foxsi/UMN-boards-FOXSI-4/README.md

# UMN-boards-FOXSI-4
Circuit boards designed in Minnesota for FOXSI-4
