foxsi/UMN-boards-FOXSI-4/little_switch/v2/doc/zdiff_jlc_vs_sierra.pdf

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
5 | 6 | 7 | 8

Trace Space

Trace Width

Trace width/space to achieve 100 Ω differential impedance for different manufacturers

Sierra-FR370HR | JLC7628 | JLC3313
