foxsi/UMN-boards-FOXSI-4/plenum/v2/doc/img/board.png

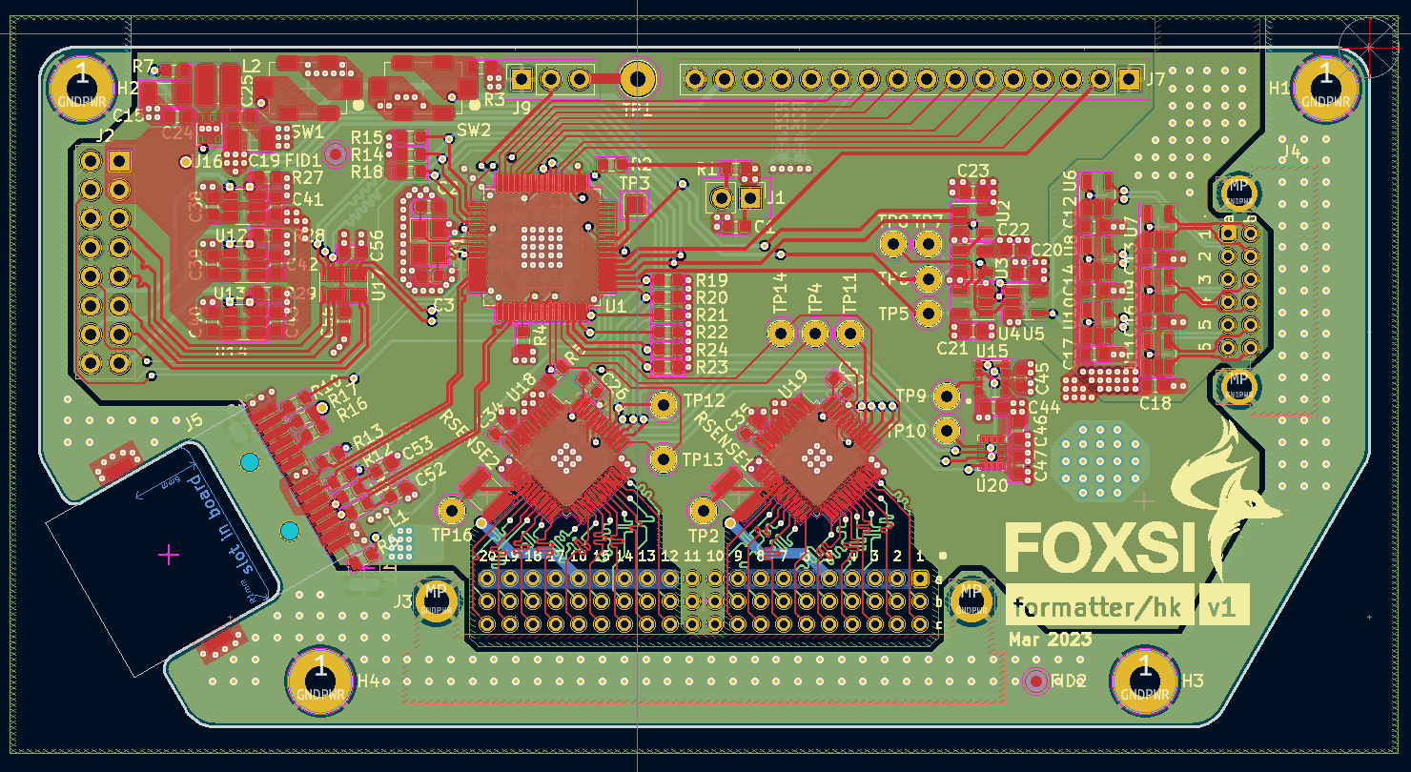
plenum/v2/doc/img/board.png
