foxsi/UMN-boards-FOXSI-4/plenum/v2/outline_w_cutout.dxf

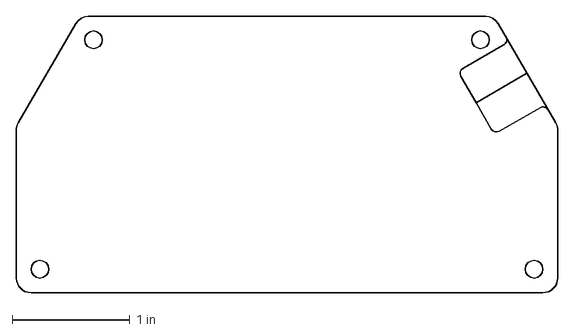
[picture p8: CAD file, 2023-04-05]
plenum/v2/outline_w_cutout.dxf
4.60 x 2.35 in
