foxsi/UMN-boards-FOXSI-4/rj45_jack/rj45_jack.stp

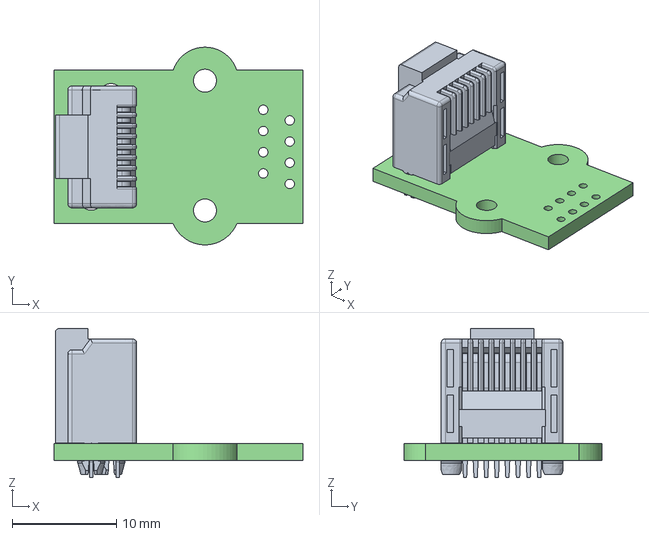
[picture p9: CAD file, 2023-04-05]
rj45_jack/rj45_jack.stp
23.9 x 19.0 x 14.3 mm
rj45_jack PCB
