foxsi/UMN-boards-FOXSI-4/plenum/v2/board_outline.dxf

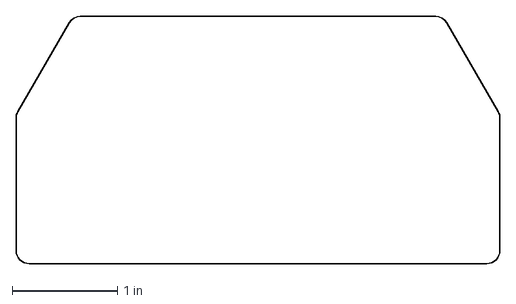
[picture p10: CAD file, 2022-10-31]
plenum/v2/board_outline.dxf
4.60 x 2.35 in
