foxsi/UMN-boards-FOXSI-4/(threads)

Thread 1 (2023-03-22):

Add RS-232 input to Ethernet switch board

thanasipantazides, 2023-03-22:
### Need:

To uplink commands from TM section (over RS-232 TX line) to Raspberry Pi.

### Todo:

- [x] Find an RS-232 <=> UART translator (with some memory, no fancy interrupting/flow control stuff)
- [x] Identify appropriate Raspberry Pi UART to route command uplink into.
- [x] Add that chip to the Ethernet switch, bottom side.

Closed 2023-07-11.

Thread 2 (2023-04-09):

Flight board solder concerns

thanasipantazides, 2023-04-09:
### Surface finishes

Summit requested to use ENIG surface finish on EM Housekeeping board due to small pad size (rather than HASL). Compared to HASL, ENIG has better pad flatness, corrosion and oxidation resistance under long-duration storage, but worse solderability and a propensity to form brittle solder joints. Specifically, some of the Ni used in the ENIG finish tends to flow into SnPb solders during reflow, which changes the solder chemistry and can result in a brittle joint if enough Ni is introduced (see  [Goyal et al. 2002](https://ieeexplore.ieee.org/document/1008179)). For SnAuCu (SAC) solders (lead-free), the Au content of the solder tends to create more brittle joints than leaded solders (see [Su, Jian, and Hamasha 2019](https://ieeexplore.ieee.org/document/8846735)).

So there doesn't seem to be a clear best solution.

### To do before flight

- [ ] Figure out any possible pre-soldering surface treatments for ENIG
- [ ] Store flight ENIG boards airtight, handle with gloves (avoid oil contamination of pads)
- [ ] Find a good solder to use ([on SAC candidate](https://www.digikey.com/en/products/detail/chip-quik-inc/SMD291SNL250T3/3645039))

Thread 3 (2024-10-10):

Power board v3

thanasipantazides, 2024-10-10:
## Overview
This issue will track changes to the `v3` power board design to address FOXSI-4 hardware errata, [documented here](https://github.com/foxsi/UMN-boards-FOXSI-4/releases/tag/foxsi-4-flight).

## Fixes to make

- [ ] Connect LT8612 `BST` to `SW` via 0.1 µF capacitor.
- [ ] Connect LT8612 `SYNC` to `INTVCC`.
- [ ] Route `SPI.SDO` to `J1.7` and `SPI.SDI` to `J1.9` (swapping them).
- [ ] Change `R58` value to 3 kΩ.
- [ ] `Timepix_5V_out` and `Timepix_12V_out` naming or placement in header should be swapped. They carry one another's voltage. (Error was introduced by module-level wiring in the hierarchical schematic).
- [ ] The MAX7317 `SPI.SDO` line needs external circuitry to be hi-Z when inactive (when `nCS3` is high).
- [ ] Something needs to be done to address the CMOS 2 always-on issue that emerged during sequence testing in Alaska. Consider new SRRs, input-side (`+28V_clean`) circuit protection, or output-side circuit protection.

thanasipantazides, 2024-10-10:
For the MAX7317 `SPI.SDO` fix, can use the TI [SN74AHC1G125](https://www.ti.com/lit/ds/symlink/sn74ahc1g125.pdf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) inline, switched by `SPI.nCS3`, to toggle.

thanasipantazides, 2024-10-10:
#### Oct 10 2024:
Implemented these locally:
- [x] Connect LT8612 BST to SW via 0.1 µF capacitor.
- [x] Connect LT8612 SYNC to INTVCC.
- [x] Route SPI.SDO to J1.7 and SPI.SDI to J1.9 (swapping them).
- [x] Change R58 value to 3 kΩ.
- [ ] Timepix_5V_out and Timepix_12V_out naming or placement in header should be swapped. They carry one another's voltage. (Error was introduced by module-level wiring in the hierarchical schematic).
- [x] The MAX7317 SPI.SDO line needs external circuitry to be hi-Z when inactive (when nCS3 is high).
- [ ] Something needs to be done to address the CMOS 2 always-on issue that emerged during sequence testing in Alaska. Consider new SRRs, input-side (+28V_clean) circuit protection, or output-side circuit protection.

thanasipantazides, 2024-10-10:
For voltage spike suppression, consider the [LittleFuse SMCJ36CA](https://www.digikey.com/en/products/detail/littelfuse-inc/SMCJ36CA/762405) which was used on the CMOS boards.

thanasipantazides, 2024-10-10:
Or the SMBJ36CA, which is slightly smaller.

thanasipantazides, 2024-10-22:
A proposed set of mitigations for the CMOS 2 issue. This avoids changes to the CdTe canister channels, for which we expect much less inrush and which performed well:
1. Add a TVS diode on the input for transient suppression. That's done above.
2. Maximize the R19/R20 resistance to maximize turn-on time. I think the largest we can do is ~1 kΩ; I will validate this in the lab.
3. Duplicate the CMOS channels' G3VM-61 chips. Run two chips in parallel per CMOS channel. This gives us much more current overhead, uses two of the same part that already flew, and minimizes board space consumption. Are there downsides to this plan?

thanasipantazides, 2024-10-23:
I corrected the `Timepix_5V_out` / `Timepix_12V_out` schematic-side. So there is no change to the FOXSI-4 power pinout, but the schematic is also now internally consistent with the voltage you actually get out of the pins.

thanasipantazides, 2024-11-01:
Phil made two suggestions in review:
1. Move topside copper out from under 12 V inductor. Lower layer or route around. This affects `REGS_Isense` and `Net-(JP9-C)`.
2. Get more consistent voltage across each duplicated CMOS SSR LED. This applies to `U19` + `U33`, and `U20` + `U32`. The idea is each LED will turn on at slightly different times, based on their steep transition in response to applied voltage. To mitigate, Phil suggests either wiring them serially, or giving each LED its own ballast resistor. Serial hookup is undesirable because of lack of redundancy, if the topside fails. Phil included a setup (for the low voltage/high current switches) with similar paired SSRs in his original v1 board, and succeeded with separate ballast resistors per LED.

So for (2) I will plan to implement dedicated ballast resistors for each LED.

thanasipantazides, 2024-11-13:
Another edit before purchase: add some exposed +28/return copper on bottom side just after input Gecko. In case we need more components for any reason.

thanasipantazides, 2024-11-15:
Re: Phil's suggestions: I've implemented this:
> So for (2) I will plan to implement dedicated resistors for each LED.
