foxsi/UMN-boards-FOXSI-4/power/v3/doc/ref_sch_20230531.pdf

# 2.2pF R5

INTVCC | 21 BST | 20 SW_5 | 19 SW_4 | 18 SW_3 | 17 SW_2 | 16 SW_1 | 15 GND_5 29 | NC_4 28 | NC_3 27 | NC_2 26 | NC_1 25 TP? R3

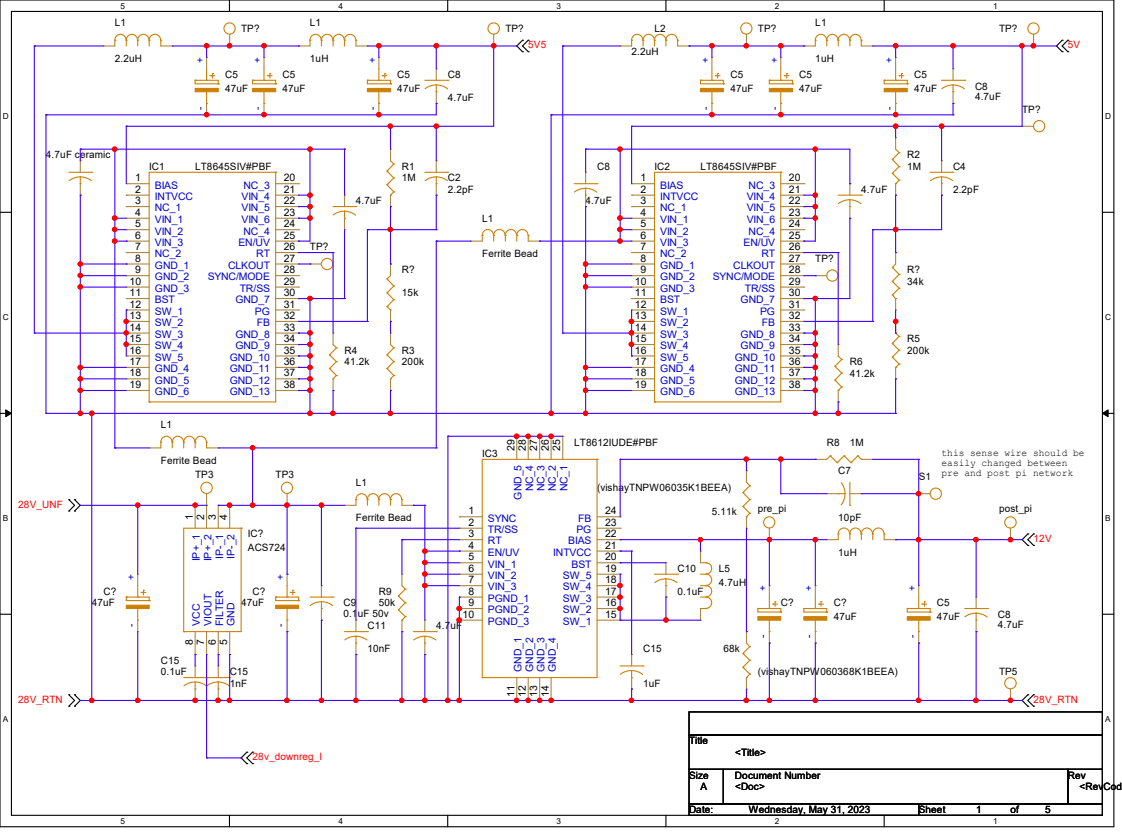
[picture p21: page 1]

this sense wire should be
easily changed between
pre and post pi network

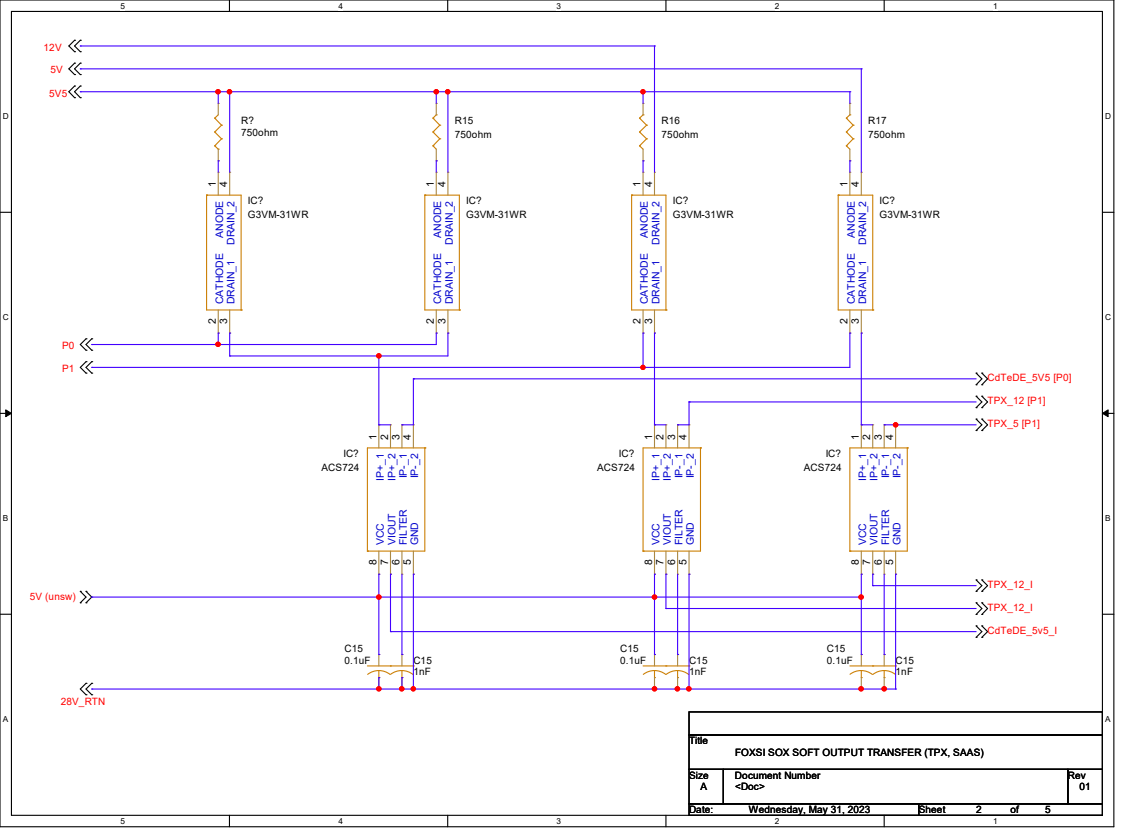
[picture p22: page 2]
A A 28V_RTN; CdTeDE_5V5 [P0]; TPX_12 [P1]; TPX_5 [P1]; CdTeDE_5v5_I; TPX_12_I; 5V (unsw); Title Size; Document Number; Rev Date:; Sheet; of <Doc>; 01 FOXSI SOX SOFT OUTPUT TRANSFER (TPX, SAAS) A; Wednesday, May 31, 2023; 5 Title Size; IC? ACS724; 4 VCC; 8 VIOUT; 7 FILTER; 6 GND; IC? G3VM-31WR ANODE; 1 CATHODE; 2 DRAIN_1; 3 DRAIN_2; R15 750ohm; R? 750ohm; R16 750ohm; 5 R17 750ohm

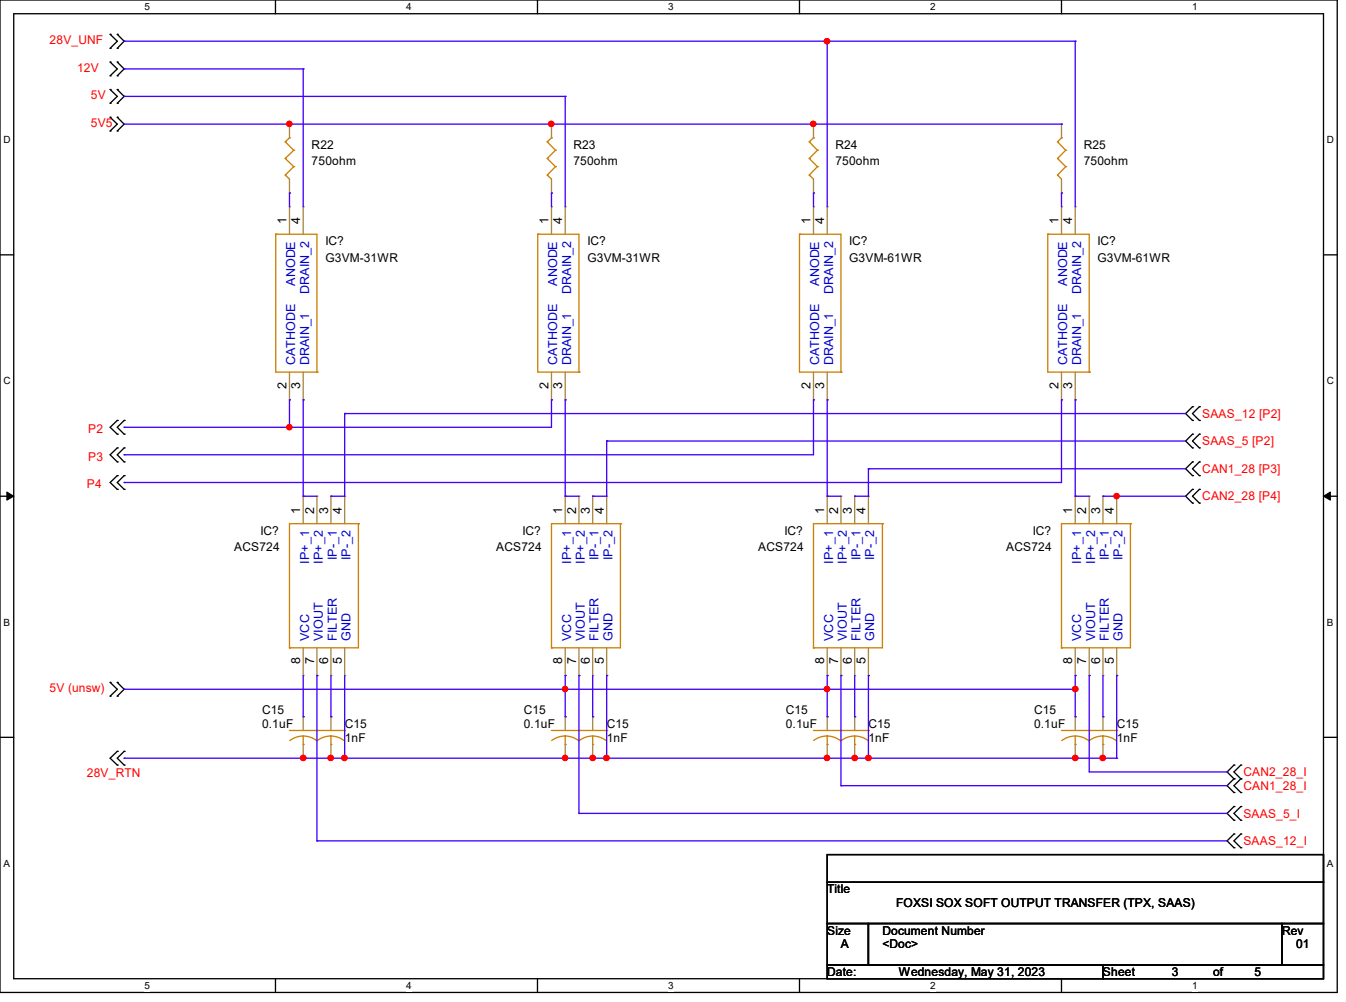
[picture p23: page 3]
A A 28V_RTN; 28V_UNF; SAAS_12 [P2]; SAAS_5 [P2]; CAN2_28 [P4]; CAN1_28 [P3]; CAN2_28_I CAN1_28_I; SAAS_5_I; SAAS_12_I; 5V (unsw); Title Size; Document Number; Rev Date:; Sheet; of <Doc>; 01 FOXSI SOX SOFT OUTPUT TRANSFER (TPX, SAAS) A; Wednesday, May 31, 2023; 5 Title Size; R23 750ohm; IC? G3VM-31WR ANODE; 1 CATHODE; 2 DRAIN_1; 3 DRAIN_2; 4 R22 750ohm; IC? ACS724; 4 VCC; 8 VIOUT; 7 FILTER; 6 GND; 5 R24 750ohm; IC? G3VM-61WR ANODE; R25 750ohm

5V5 P5

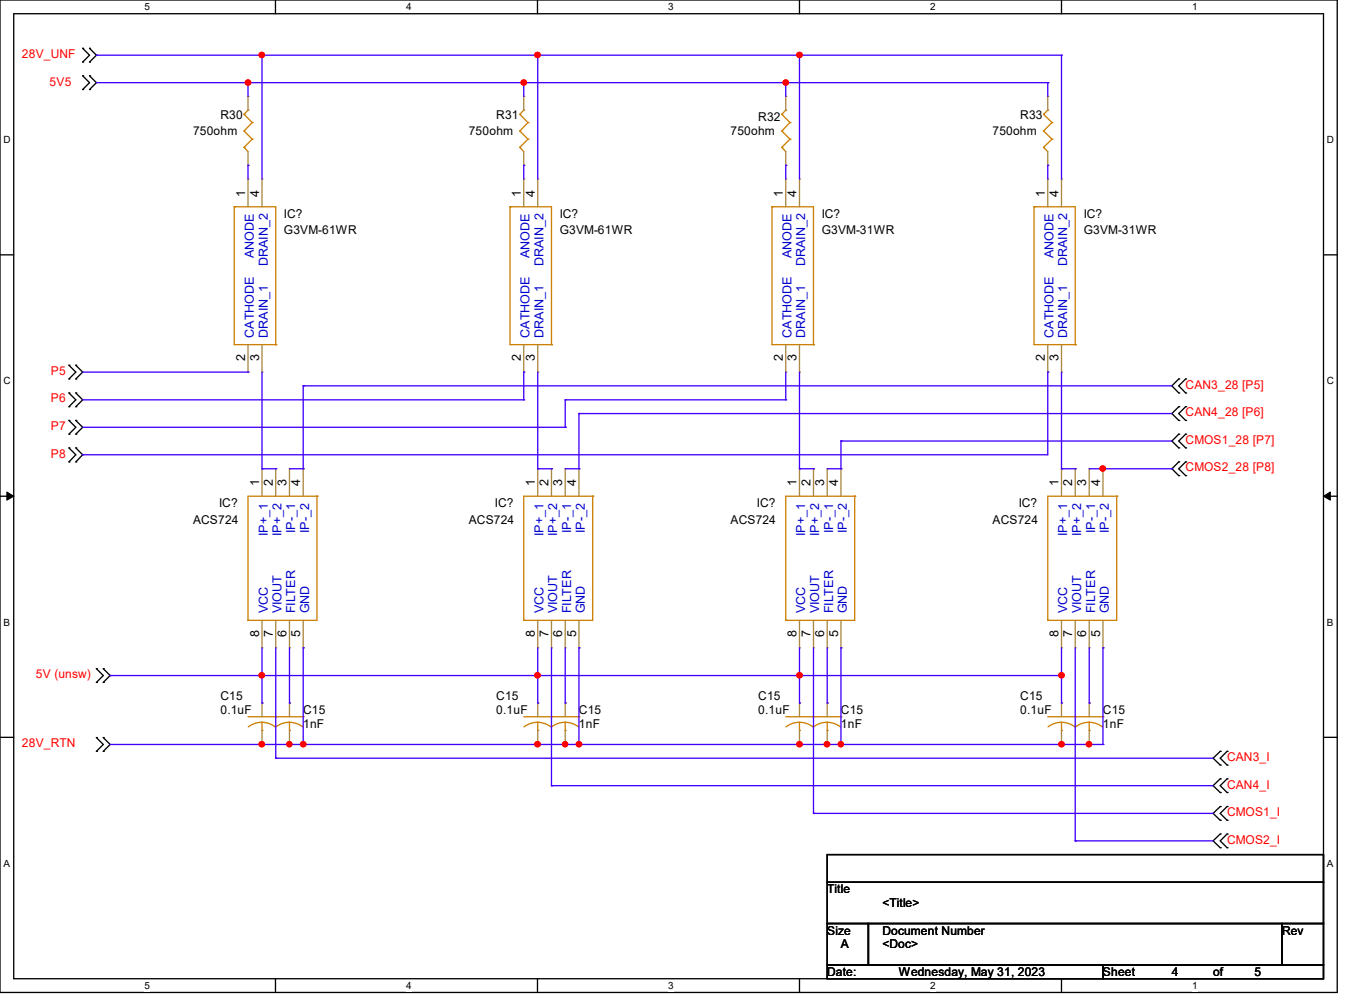
[picture p24: page 4]
A A 28V_RTN; CAN3_28 [P5]; CAN4_28 [P6]; CMOS1_28 [P7]; CMOS2_28 [P8]; 28V_UNF; CMOS2_I; CMOS1_I; CAN4_I; CAN3_I; 5V (unsw); Title Size; Document Number; Rev Date:; Sheet; of <Doc>; <Title> A; Wednesday, May 31, 2023; 5 Title Size; IC? G3VM-31WR ANODE; 1 CATHODE; 2 DRAIN_1; 3 DRAIN_2; R31 750ohm; IC? ACS724; 4 VCC; 8 VIOUT; 7 FILTER; 6 GND; R32 750ohm; IC? G3VM-61WR ANODE; R33 750ohm; R30 750ohm

# TP12 TP6

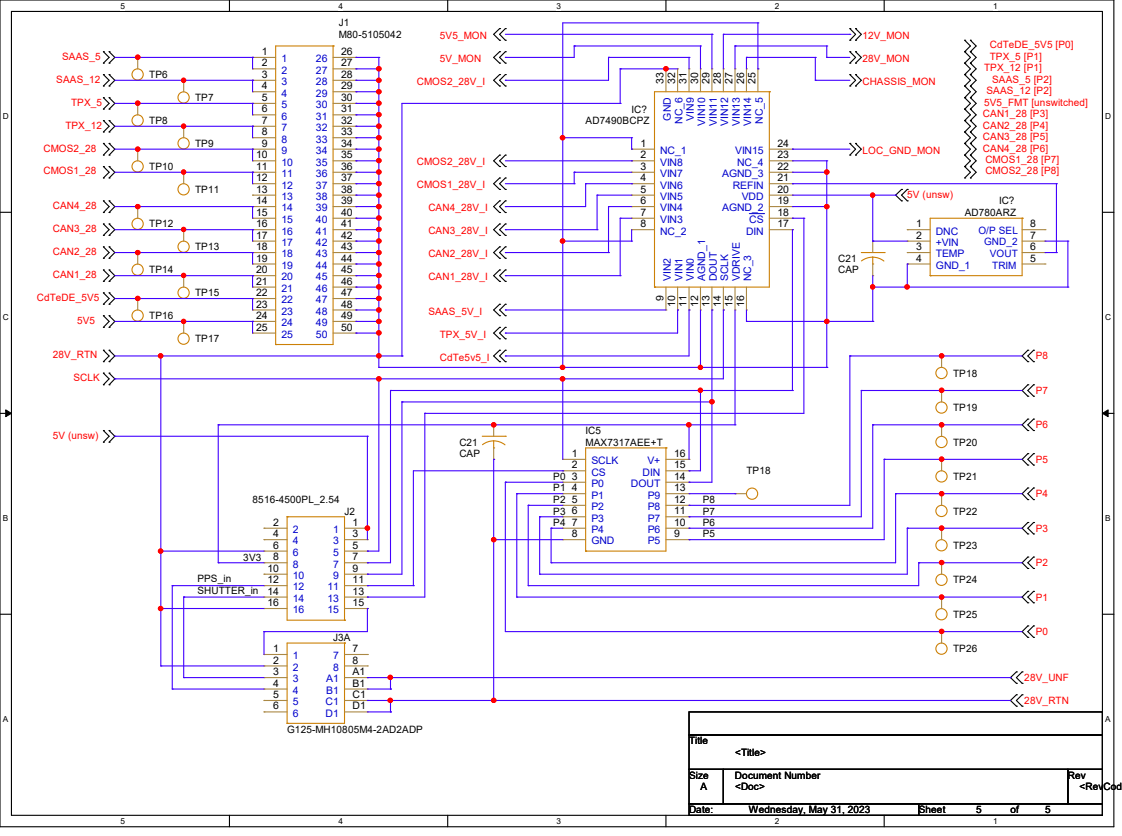
[picture p25: page 5]

9 VIN1 10 VIN0 11 AGND_1 12 DOUT 13 SCLK 14 VDRIVE 15 NC_3 16 VIN15 24 NC_4 23 AGND_3 22 REFIN 21 VDD 20 AGND_2 19 CS 18 DIN 17 GND 33 NC_6 32 VIN9 31 VIN10 30 VIN11 29 VIN12 28 VIN13 27 VIN14 26 NC_5 25
