foxsi/UMN-boards-FOXSI-4/little_switch/v2/doc/formatter stack drawing.pdf

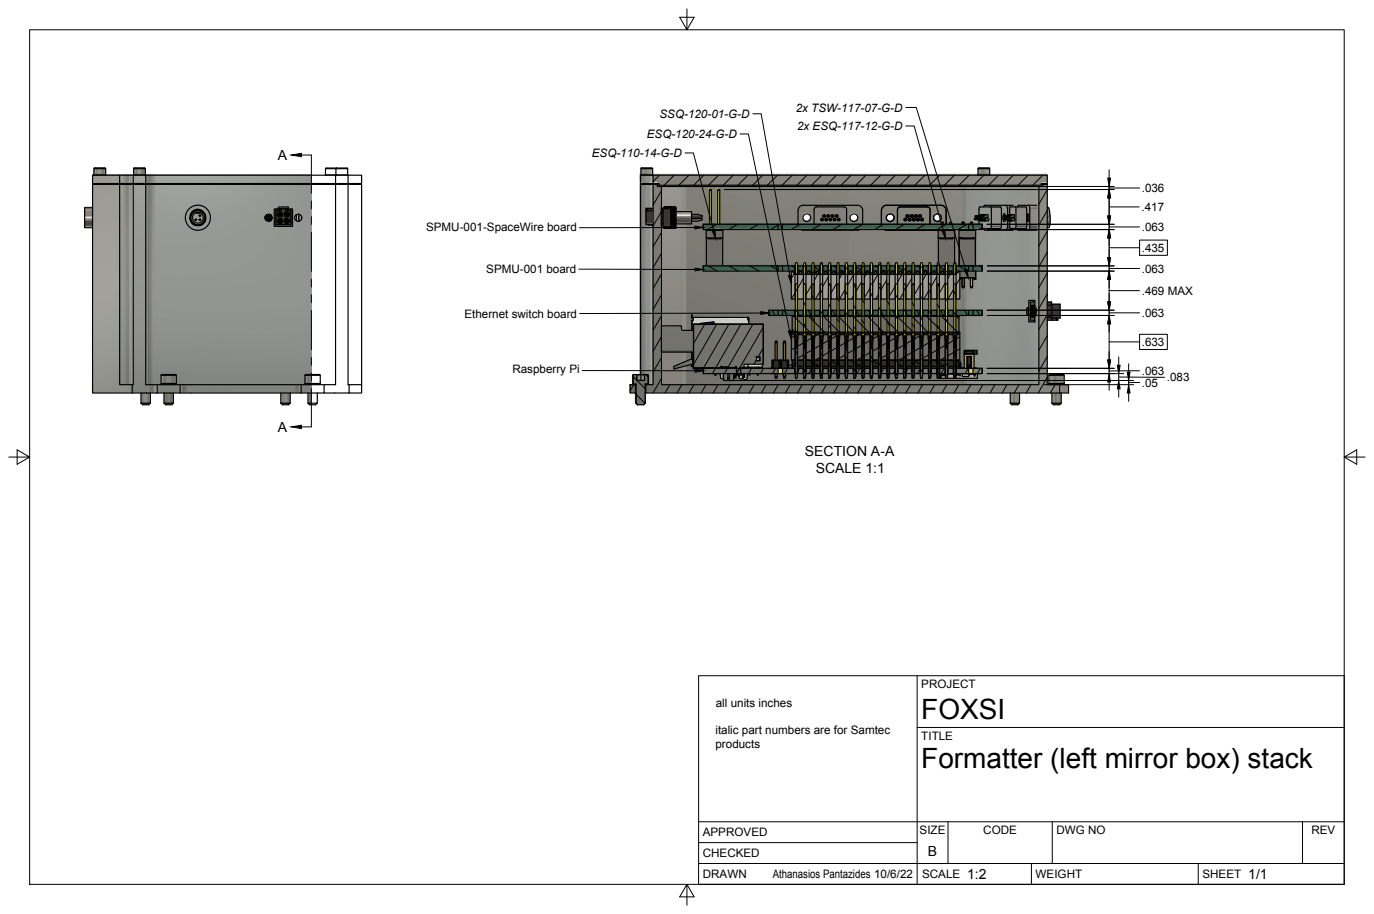
[picture p26: page 1]
SIZE; CODE; DWG NO; REV; Athanasios Pantazides 10/6/22; SECTION A-A SCALE 1:1; .469 MAX; SPMU-001 board; Raspberry Pi; 2x ESQ-117-12-G-D; 2x TSW-117-07-G-D SSQ-120-01-G-D

SPMU-001-SpaceWire board

Ethernet switch board

PROJECT
FOXSI
Formatter (left mirror box) stack

all units inches

italic part numbers are for Samtec
products
