foxsi/UMN-boards-FOXSI-4/power/v3/build/power.pdf

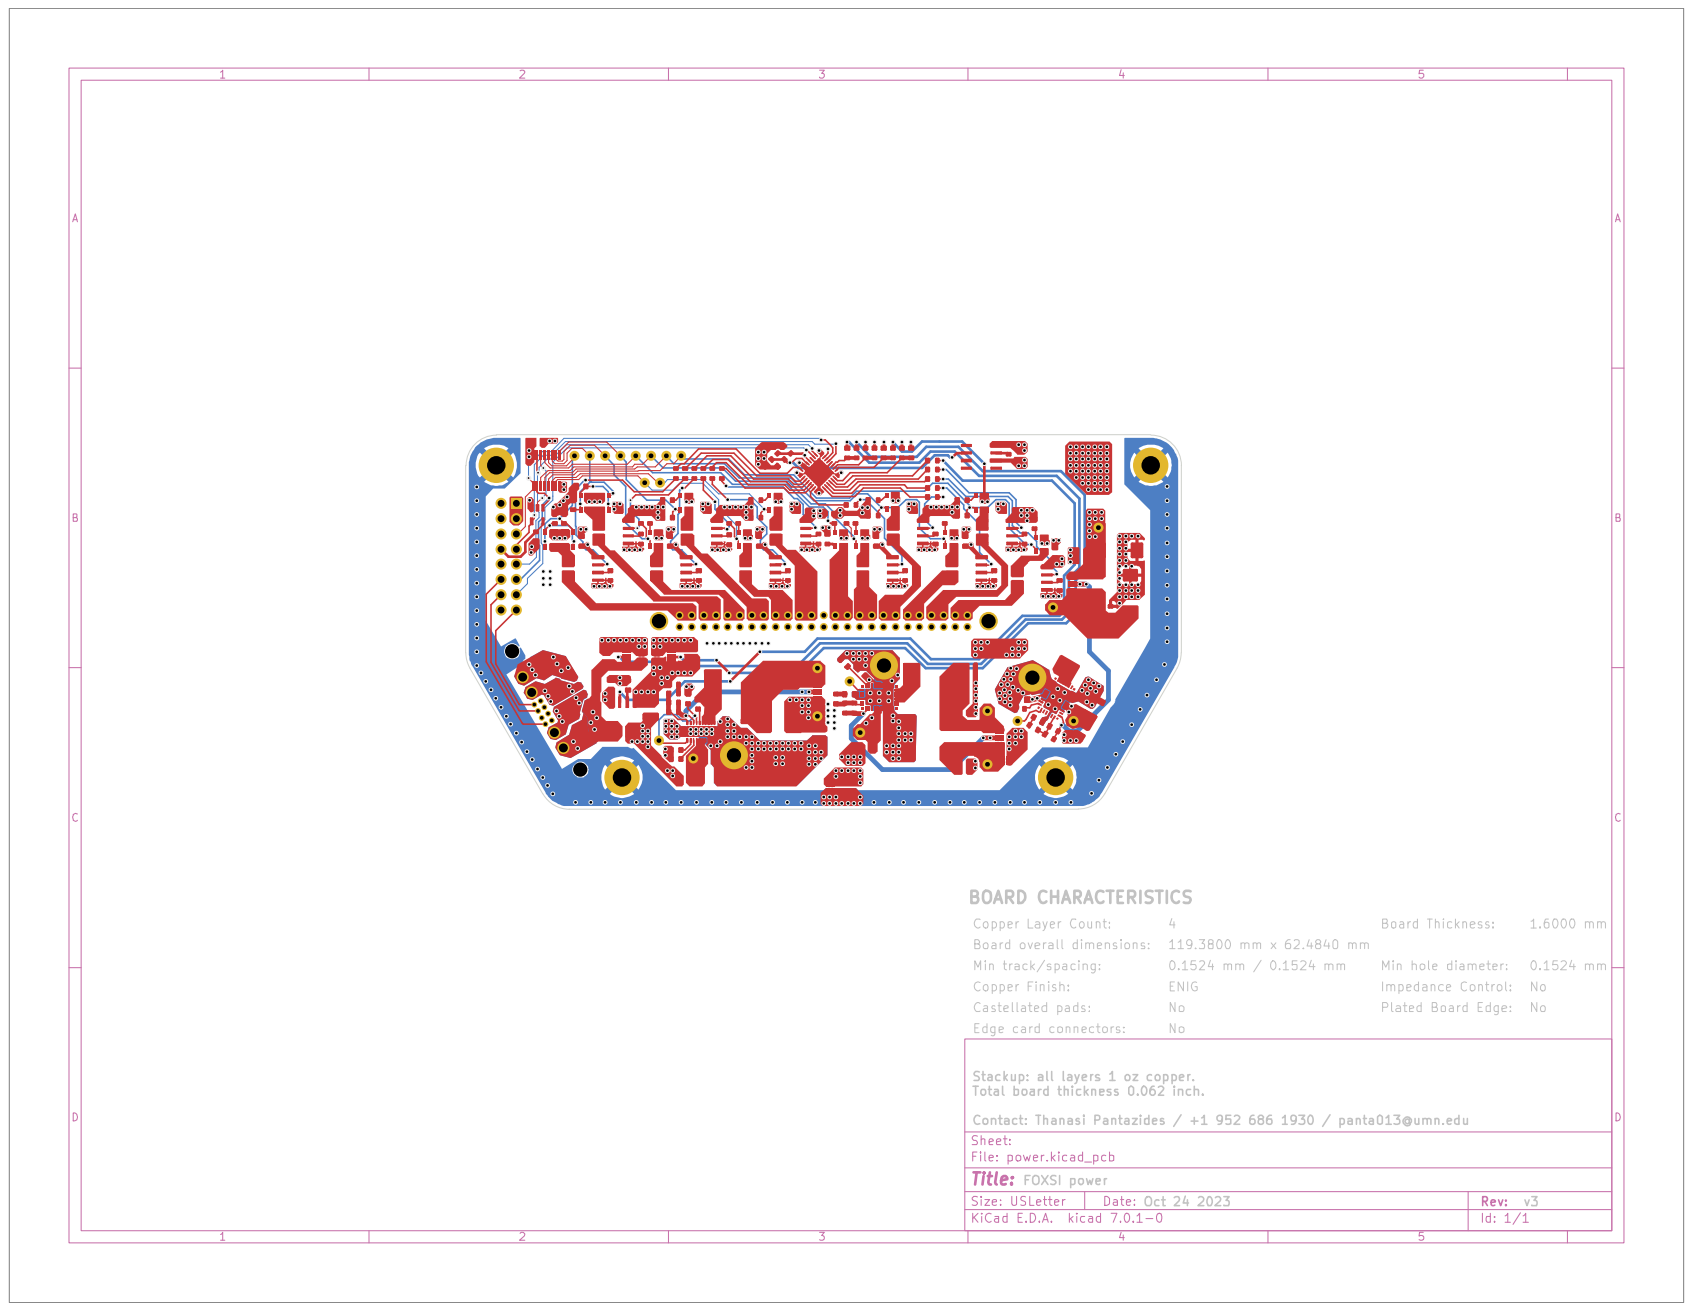
[picture p36: page 1]
