foxsi/UMN-boards-FOXSI-4/power/v3/doc/schematic.pdf

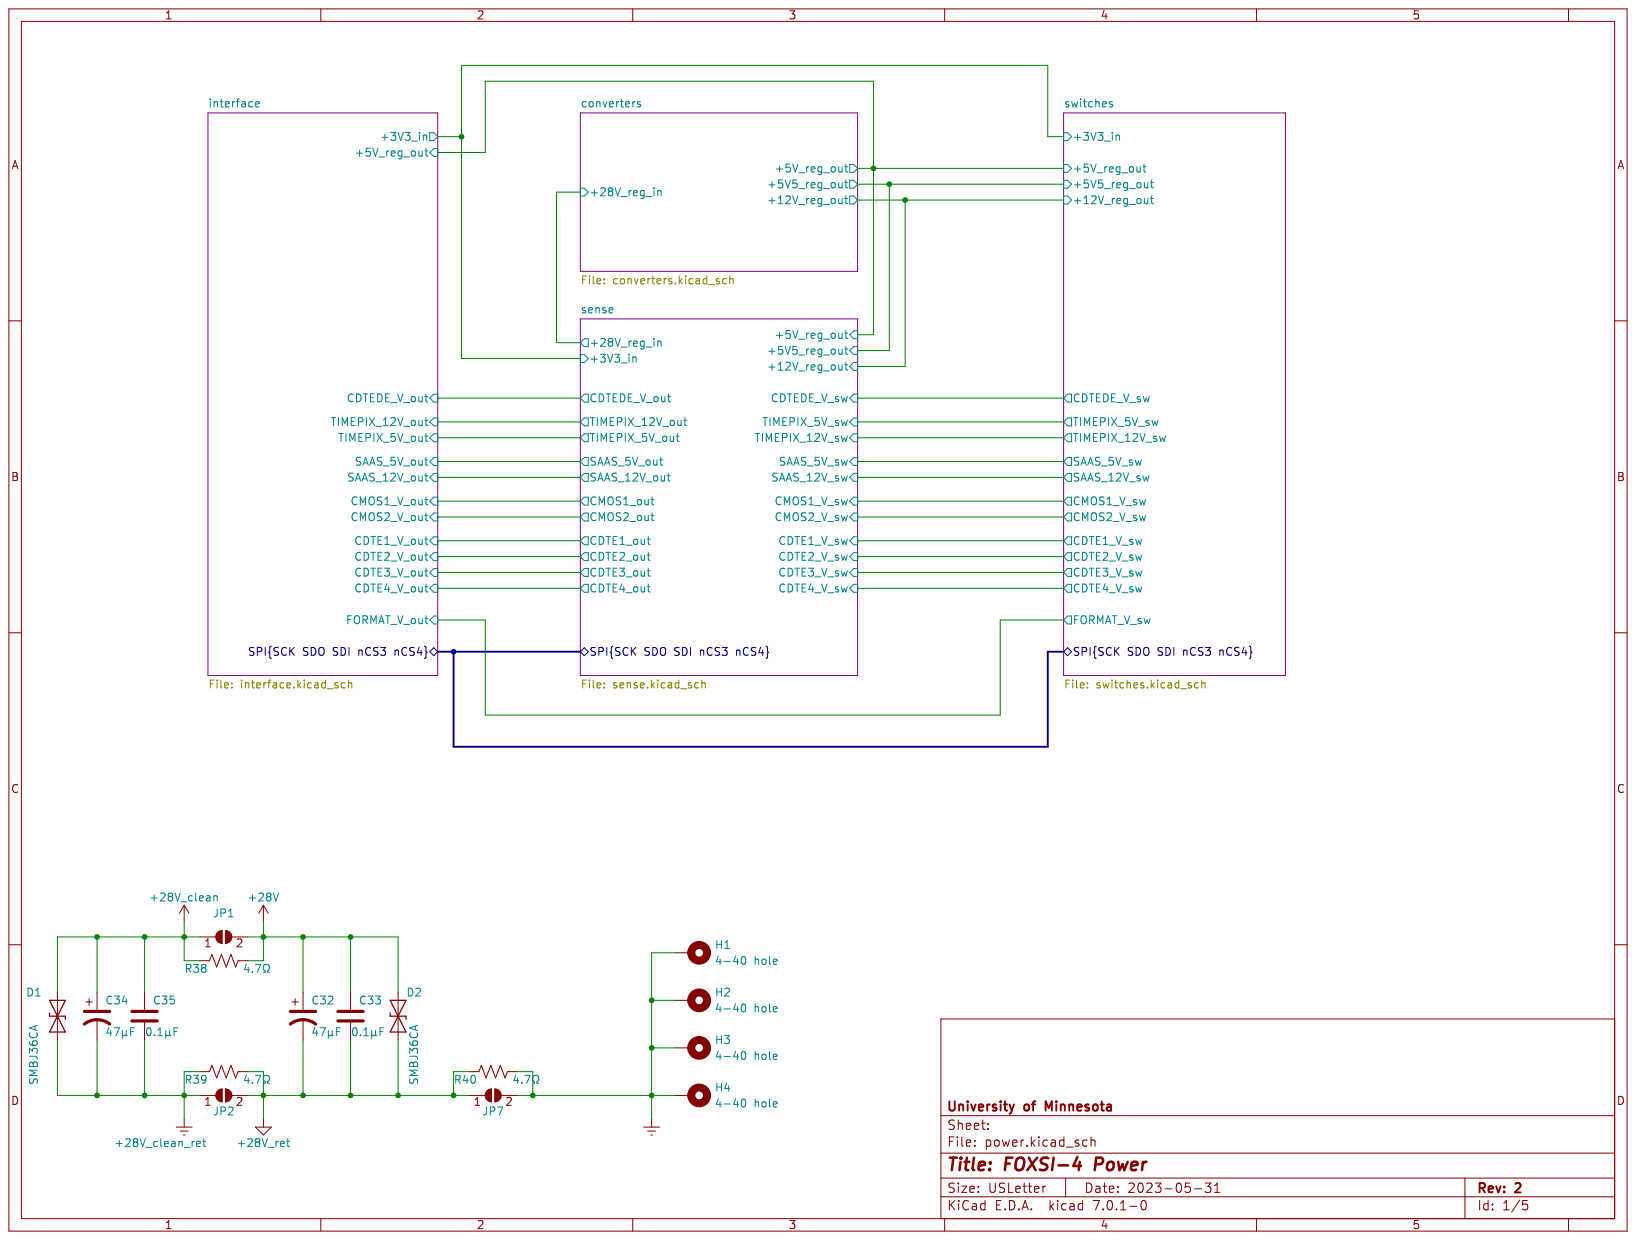
[picture p37: page 1]

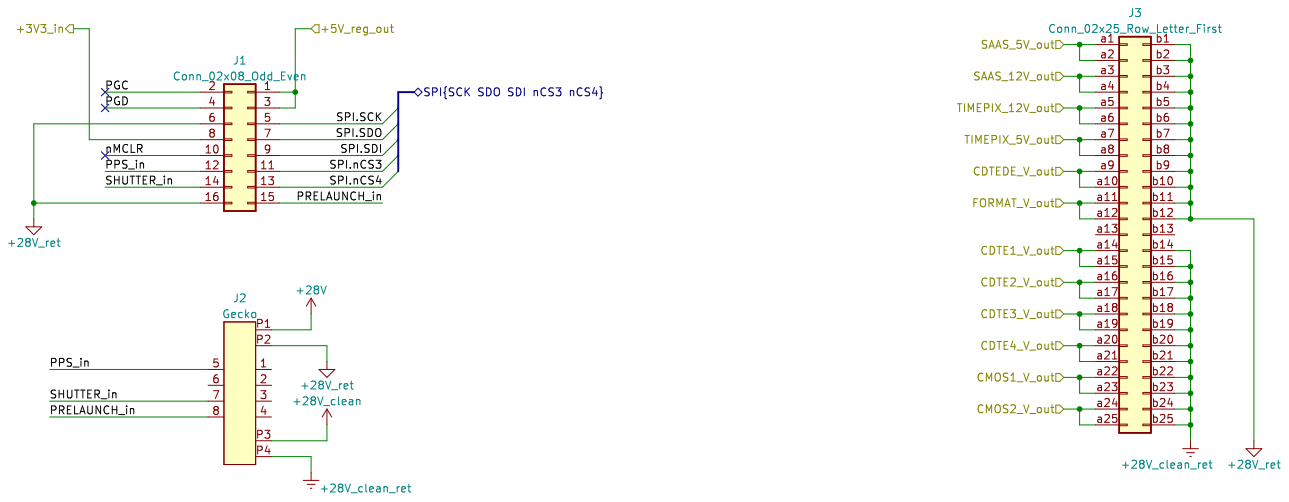
[picture p38: page 2]

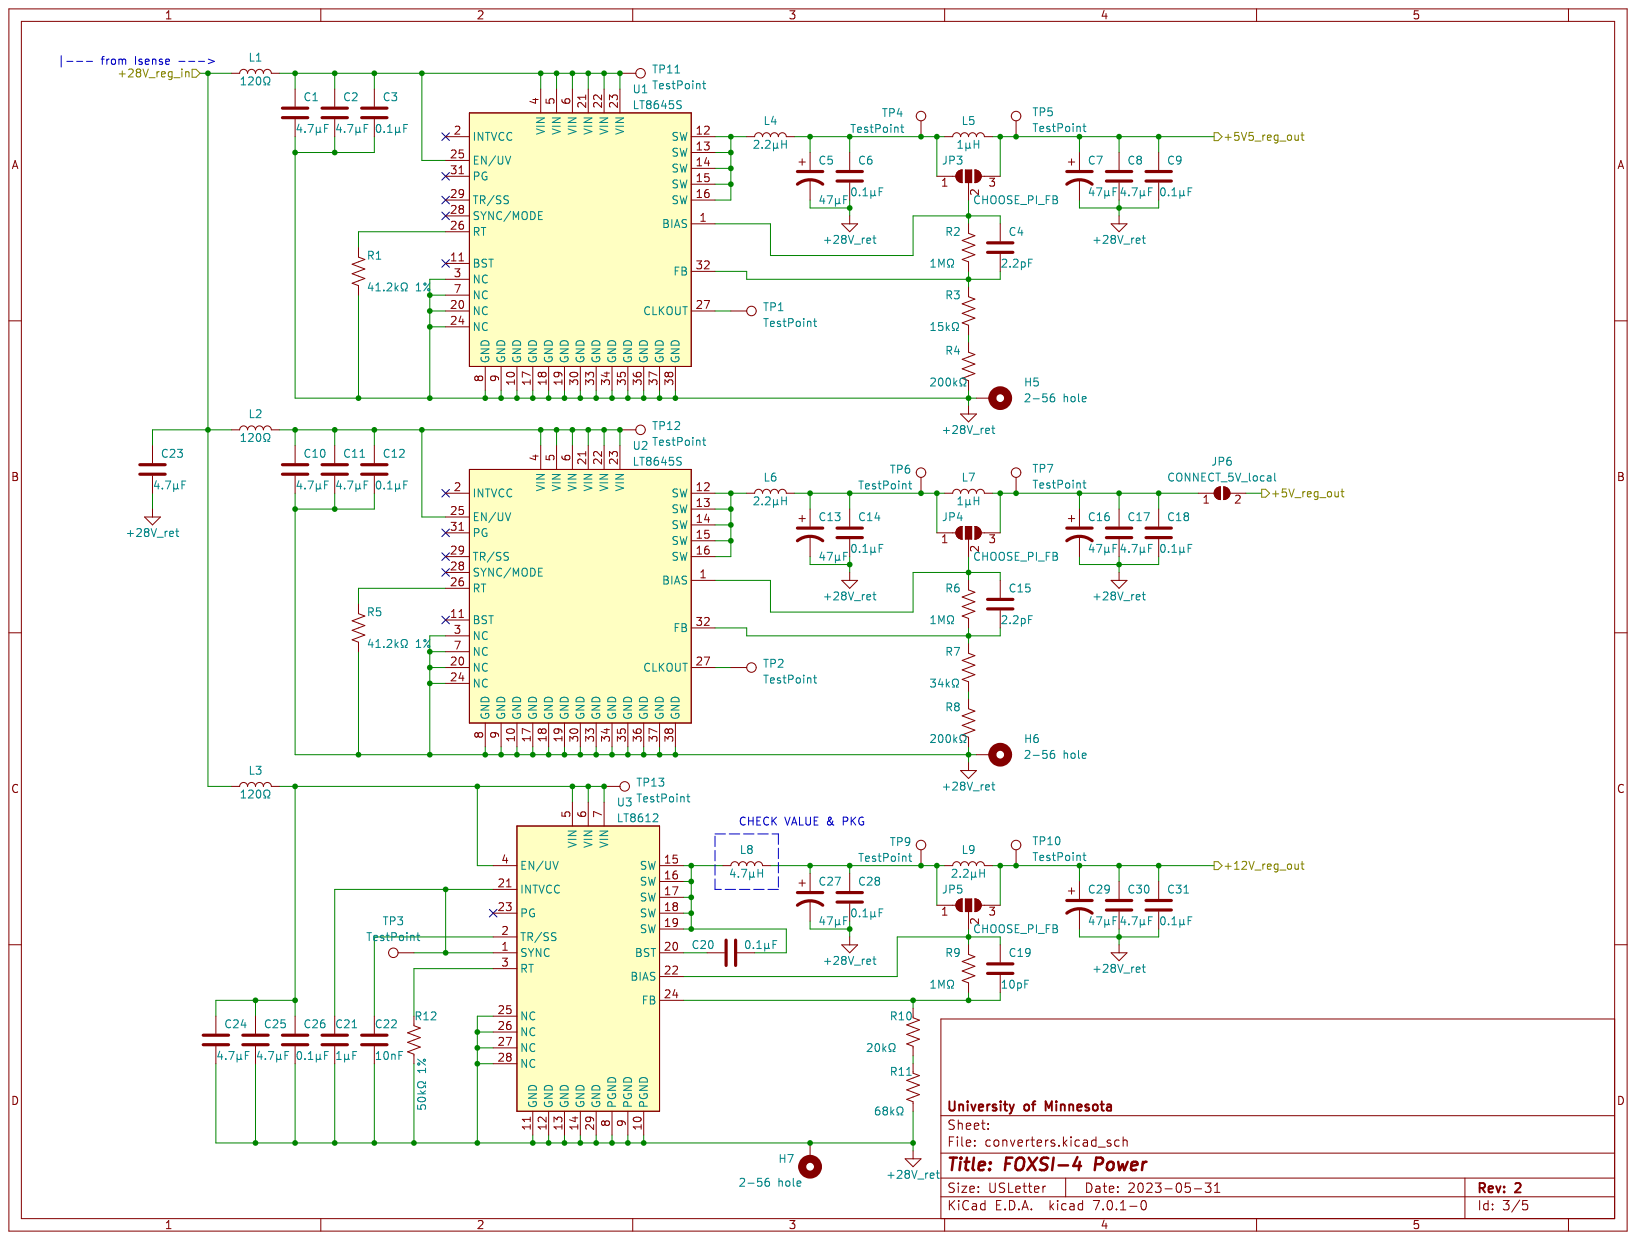
[picture p39: page 3]

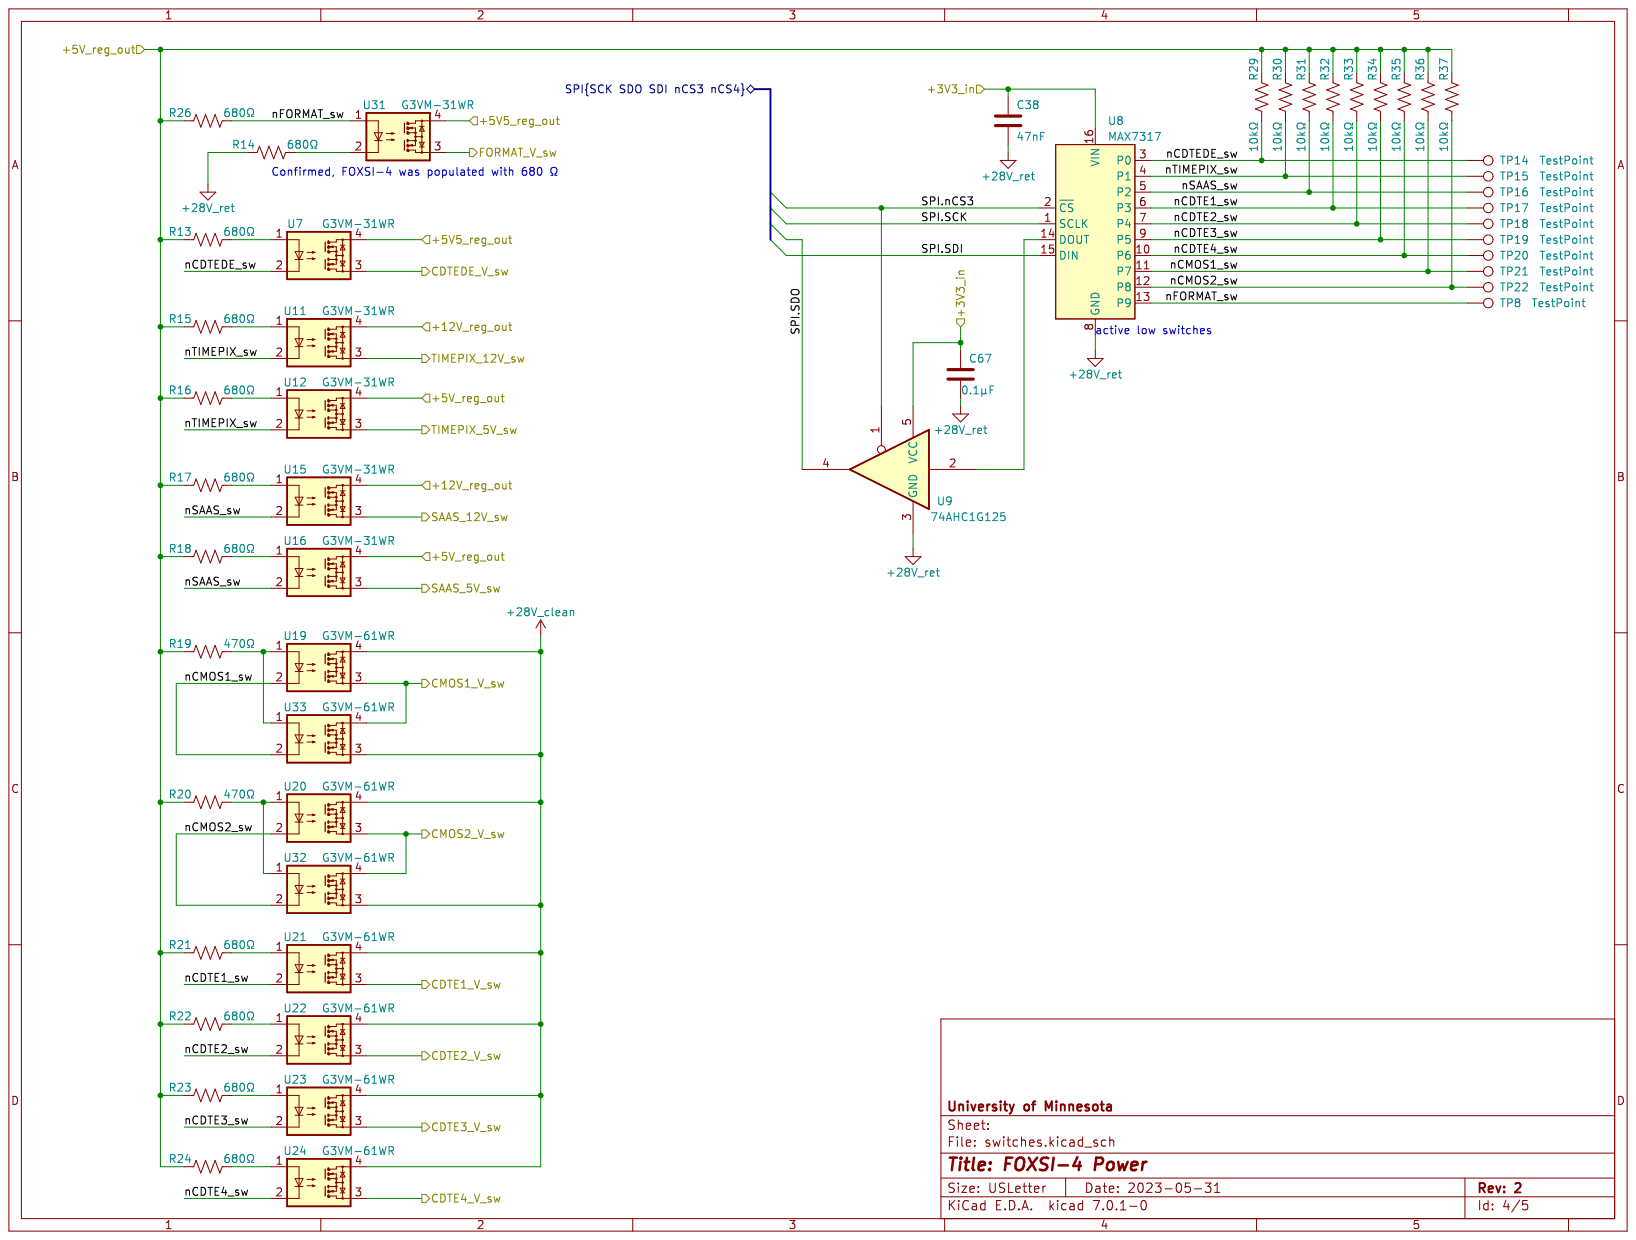
[picture p40: page 4]

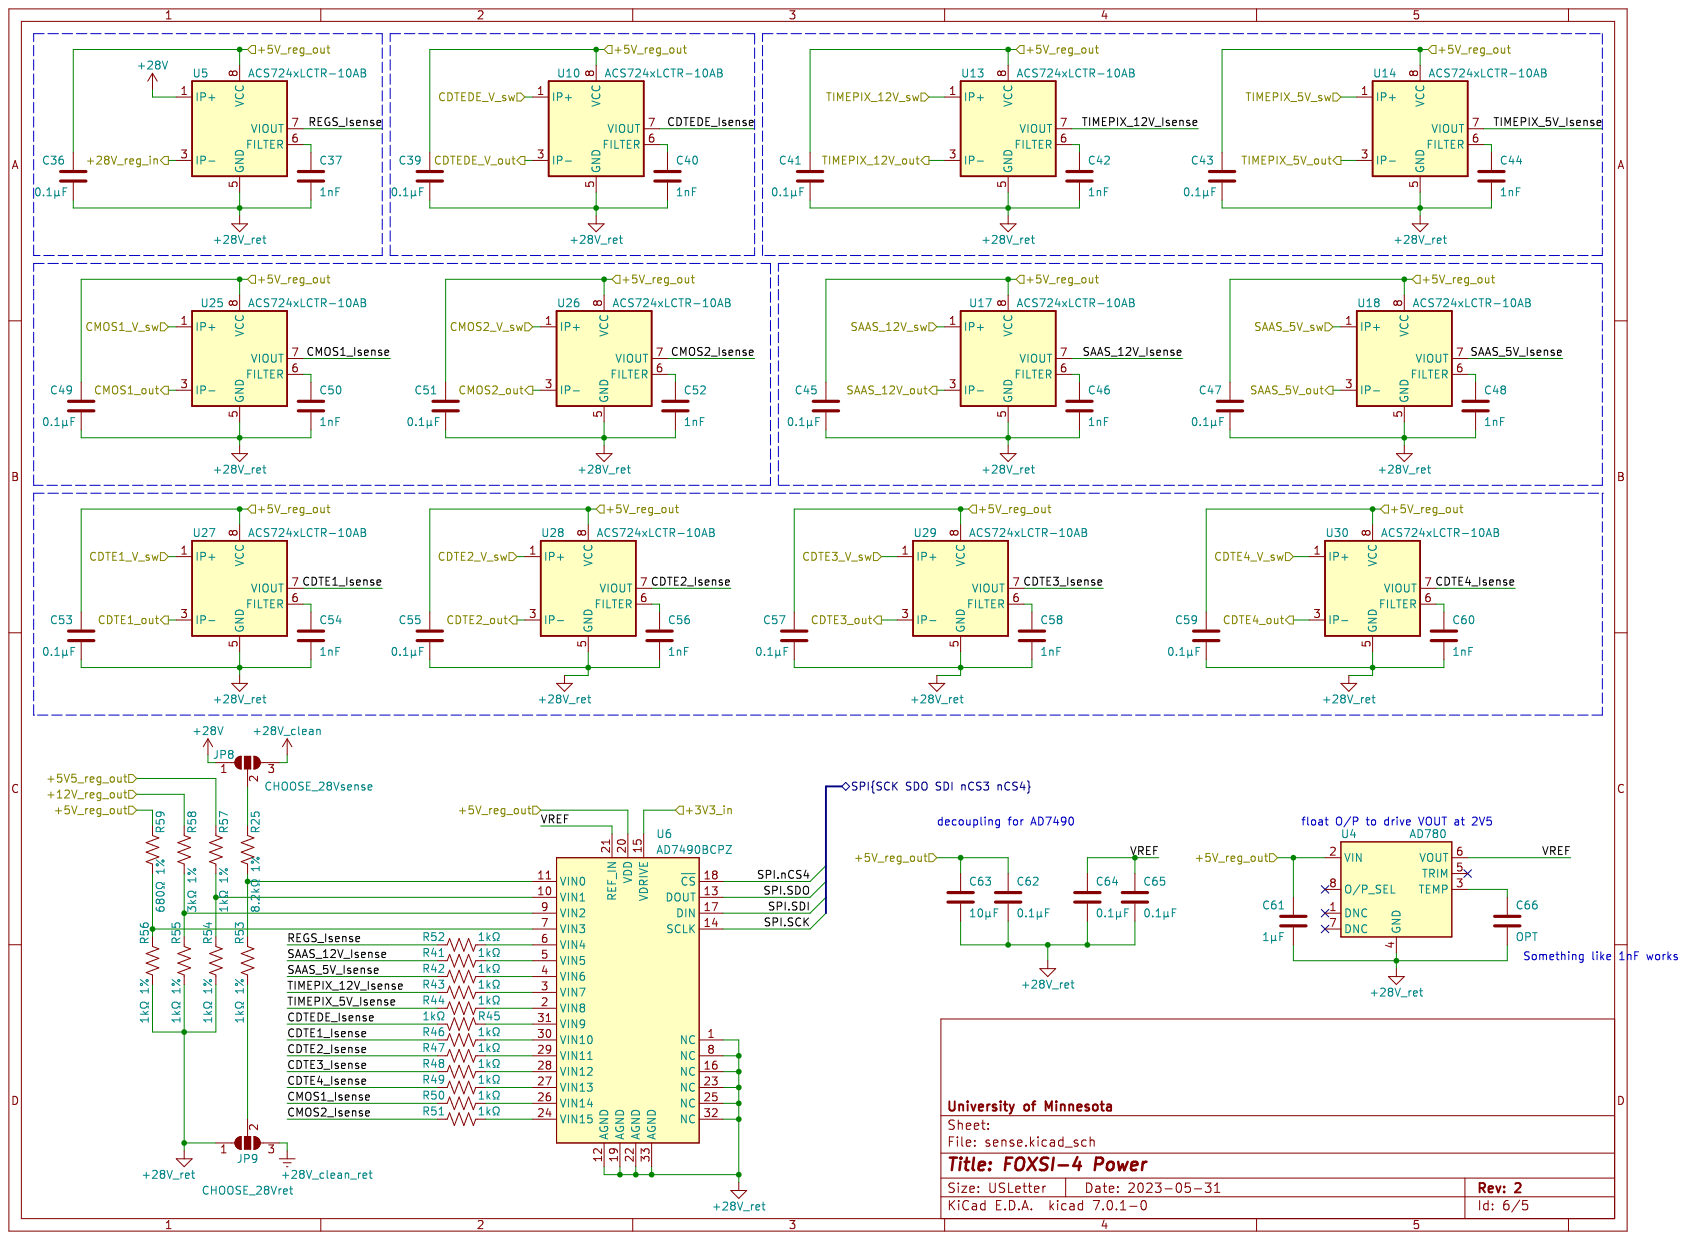
[picture p41: page 5]
