foxsi/UMN-boards-FOXSI-4/plenum/v2/build/housekeeping.pdf

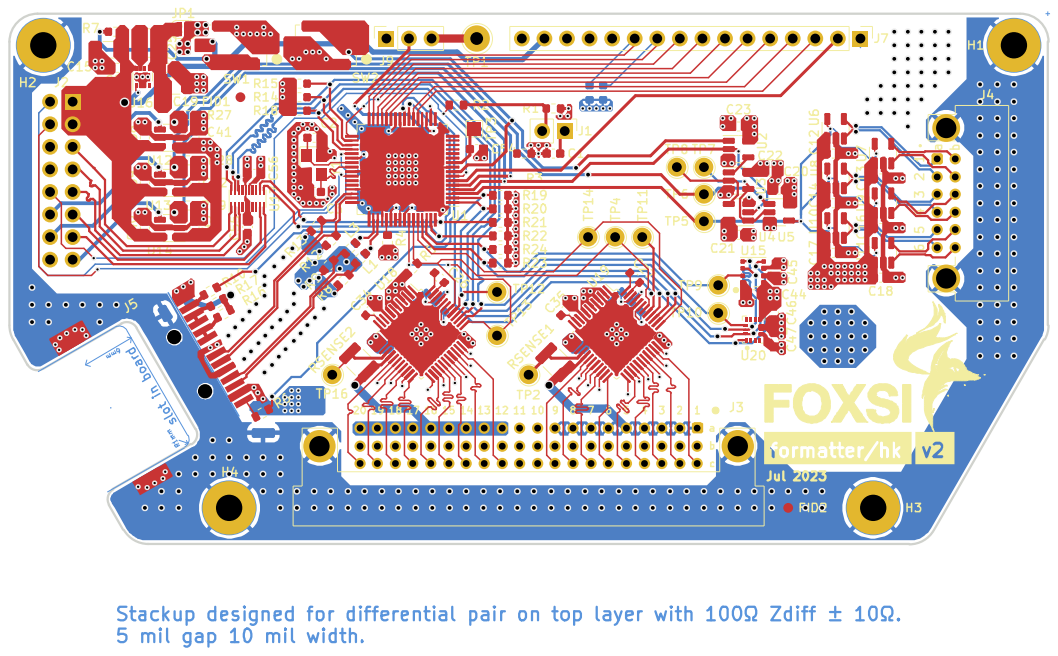
[picture p58: page 1]
