foxsi/UMN-boards-FOXSI-4/plenum/v2/build/layers.pdf

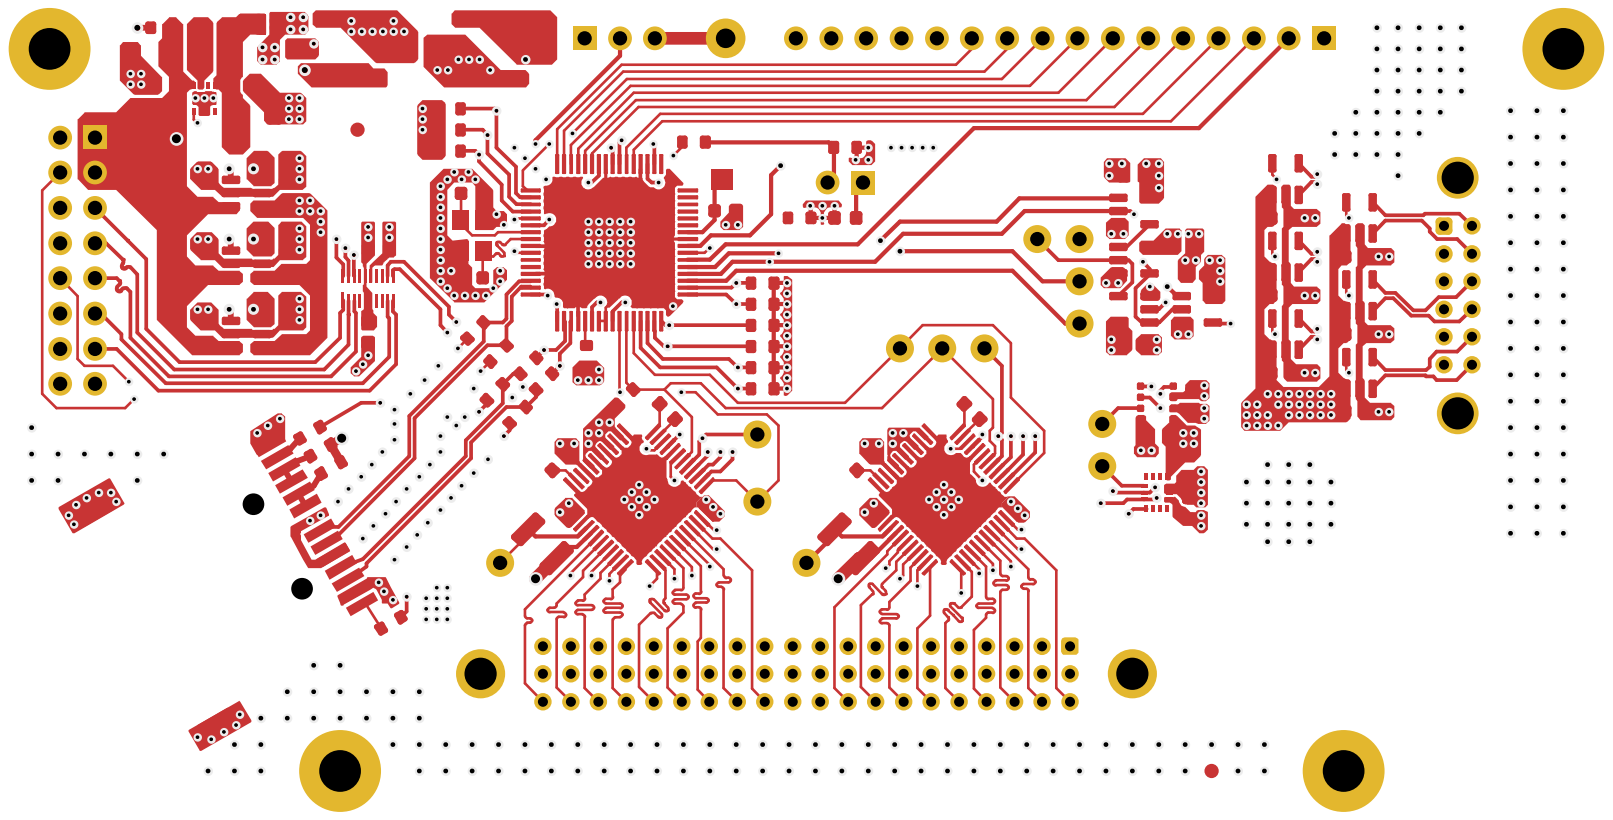
[picture p59: page 1]

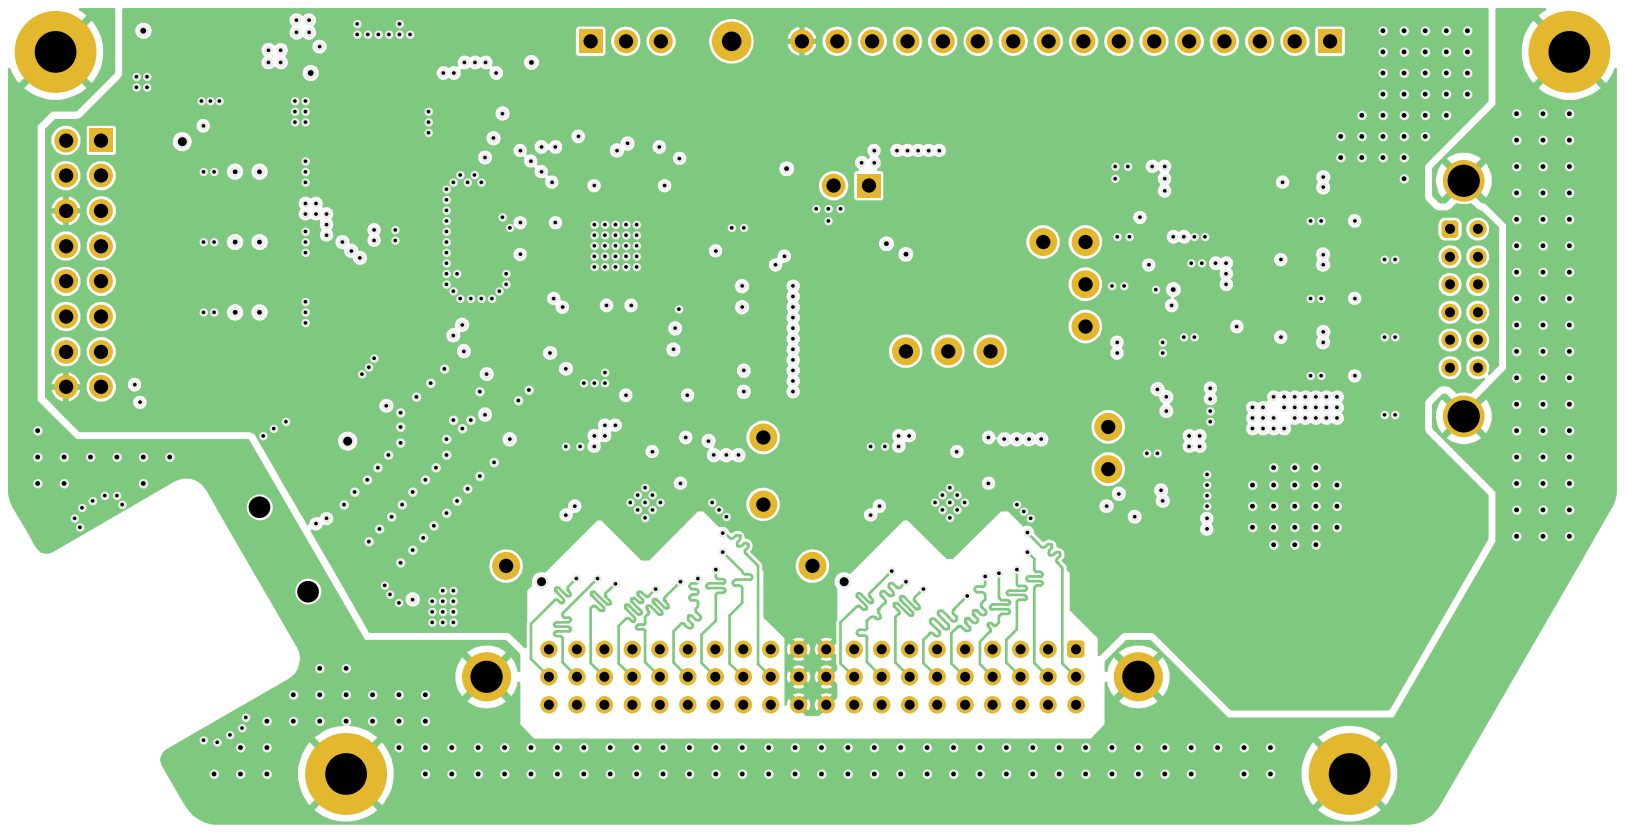
[picture p60: page 2]

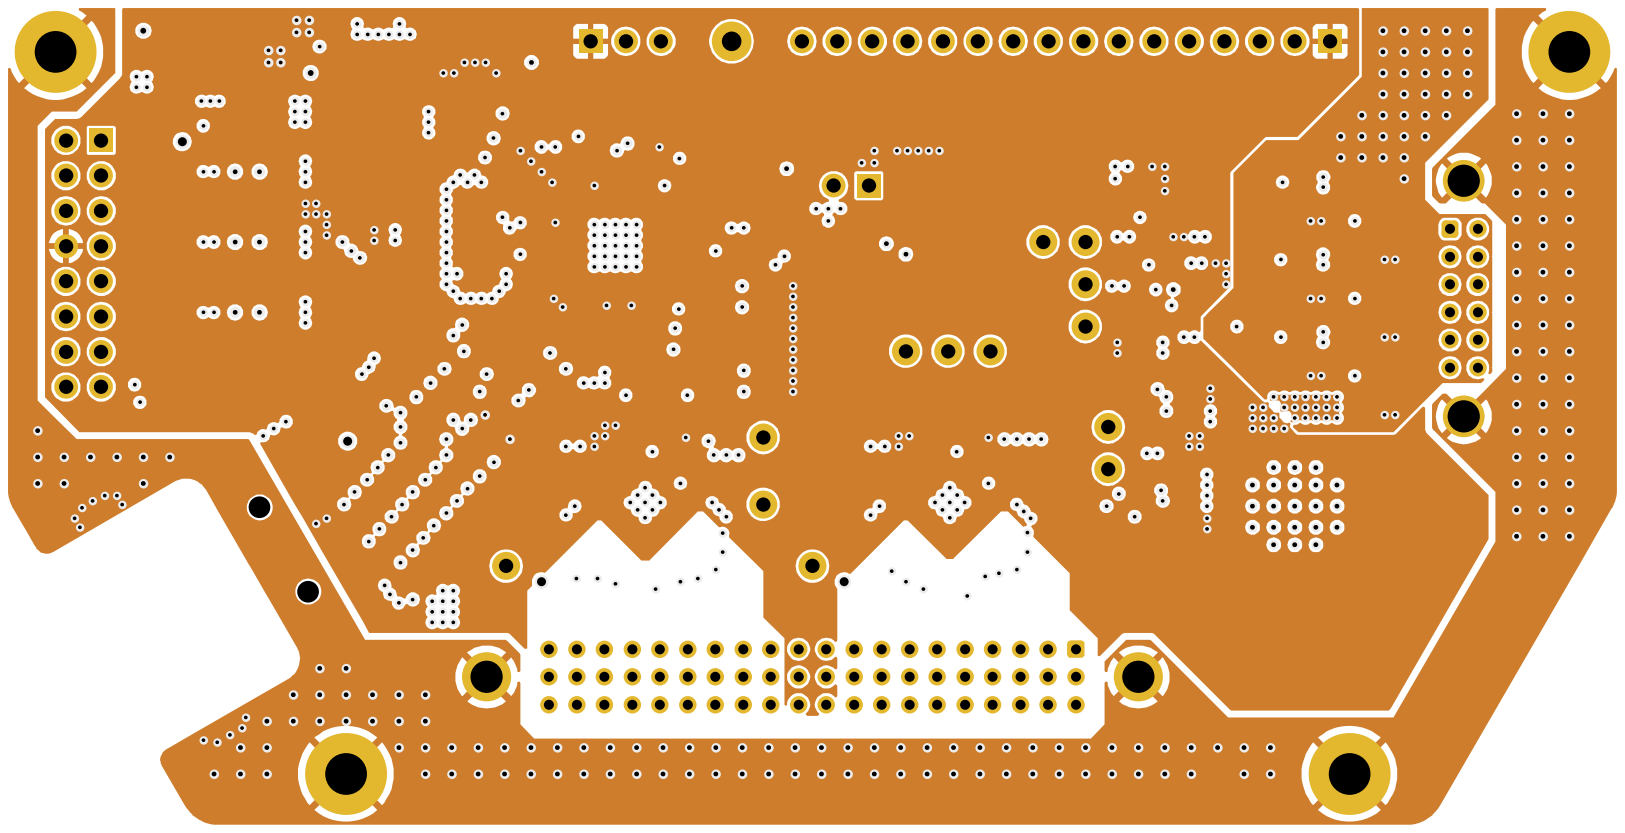
[picture p61: page 3]

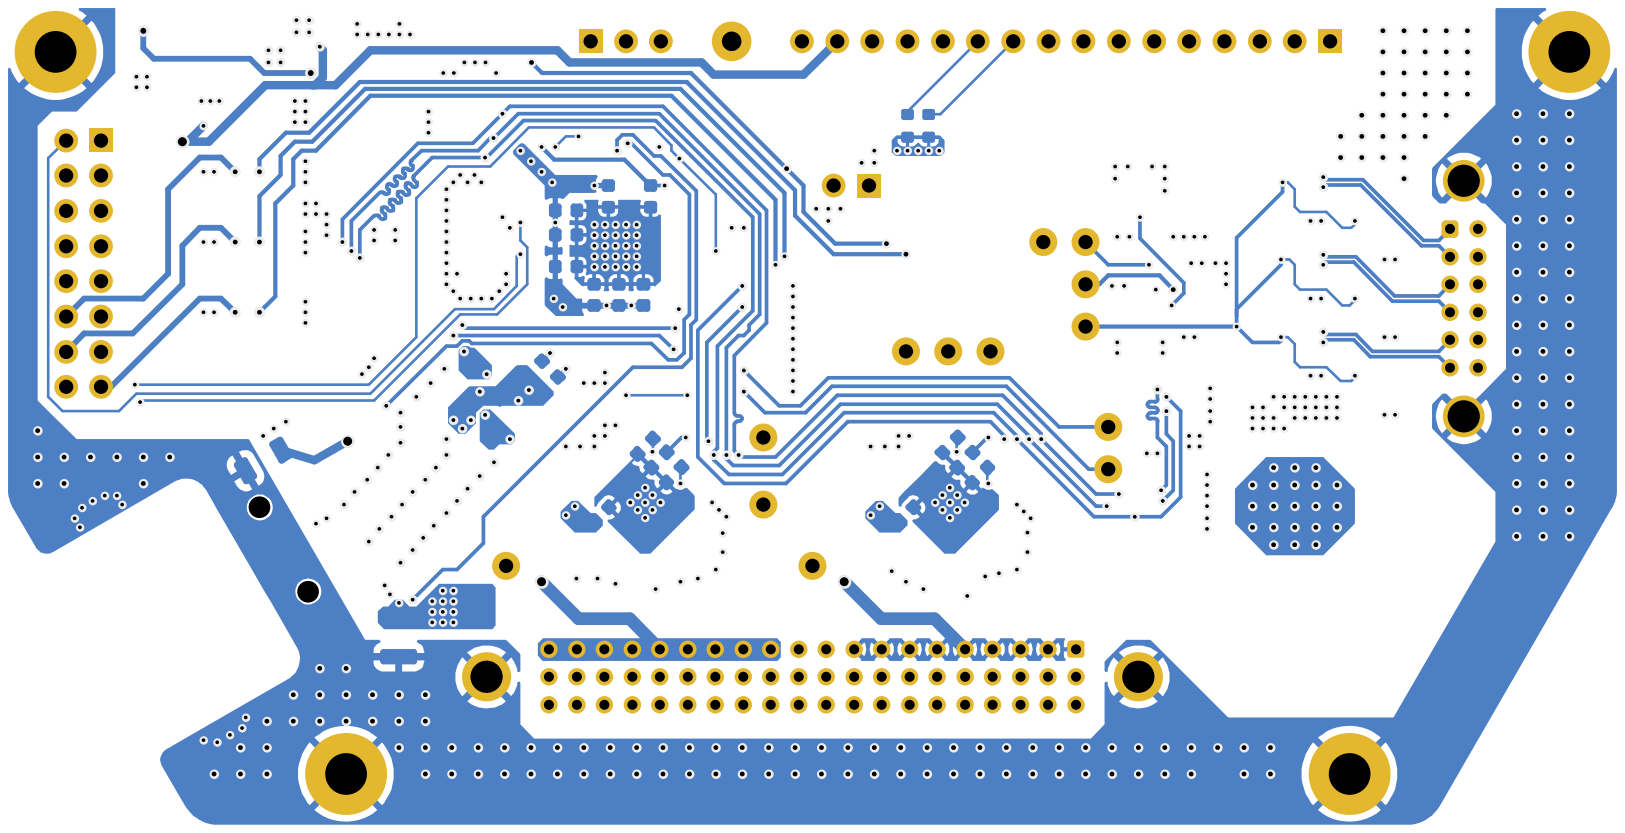
[picture p62: page 4]

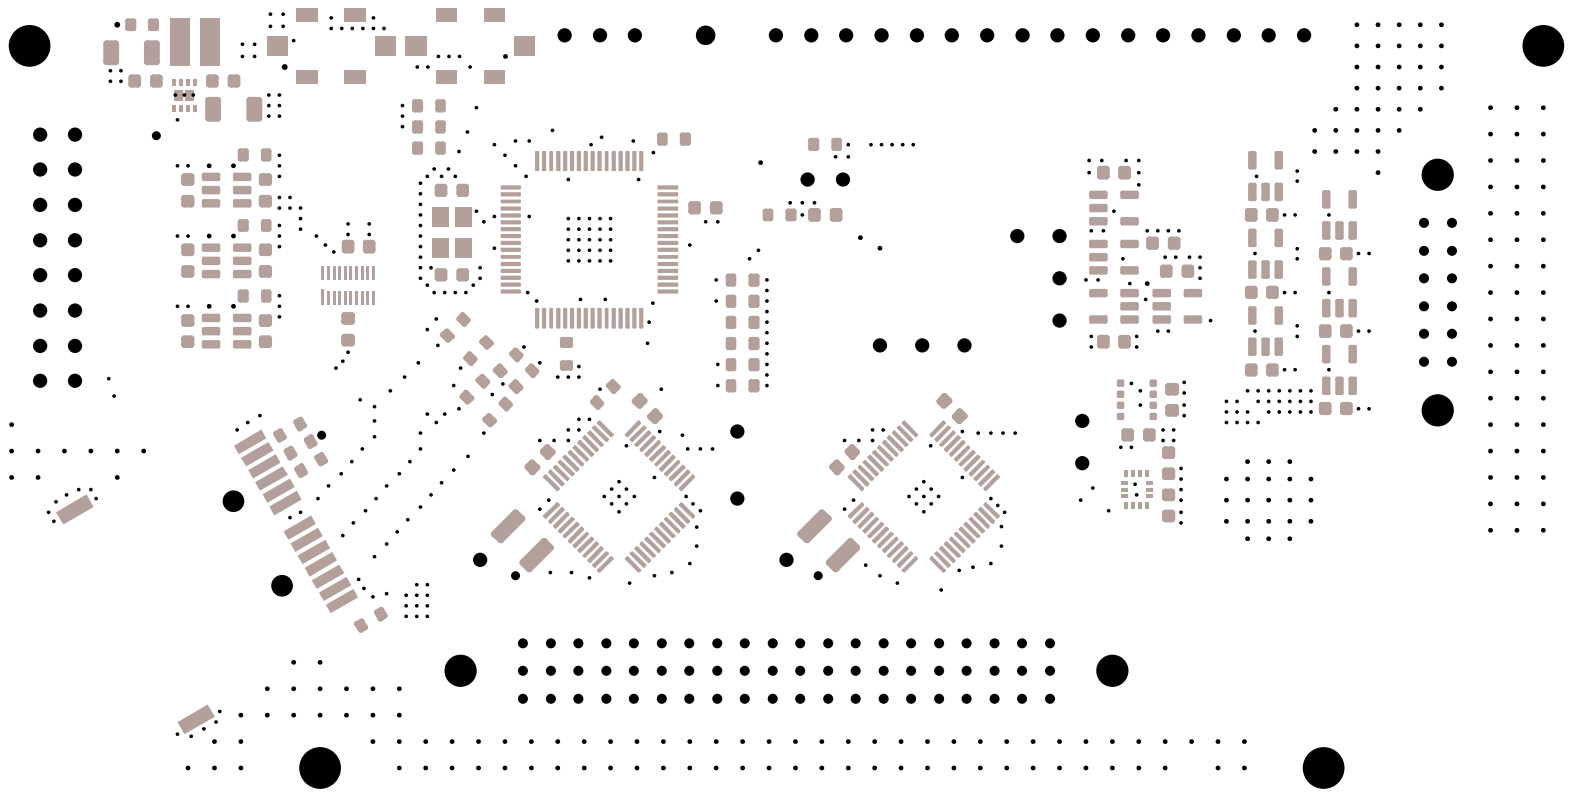
[picture p63: page 5]

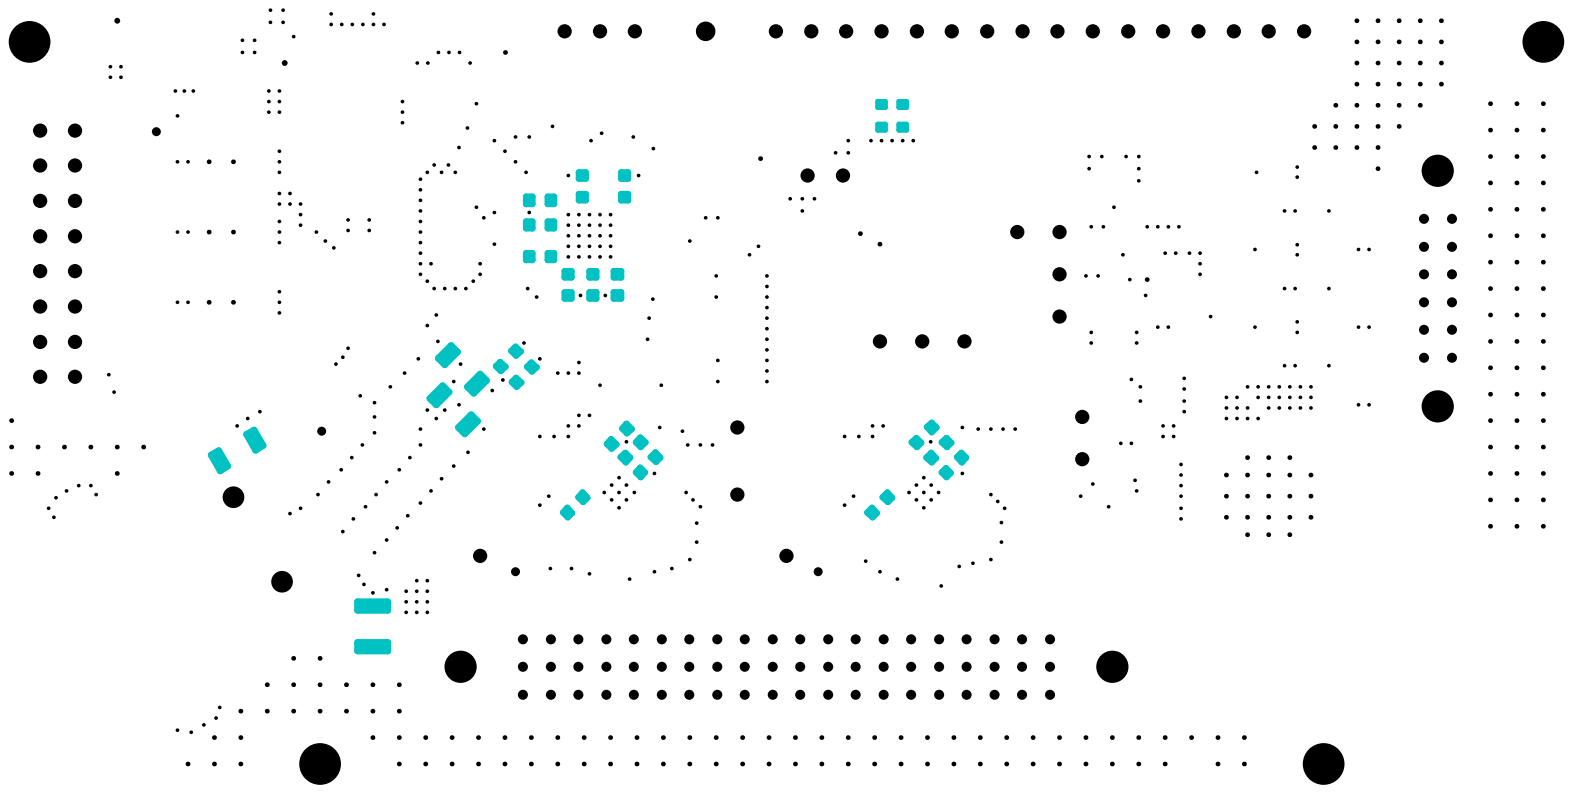
[picture p64: page 6]

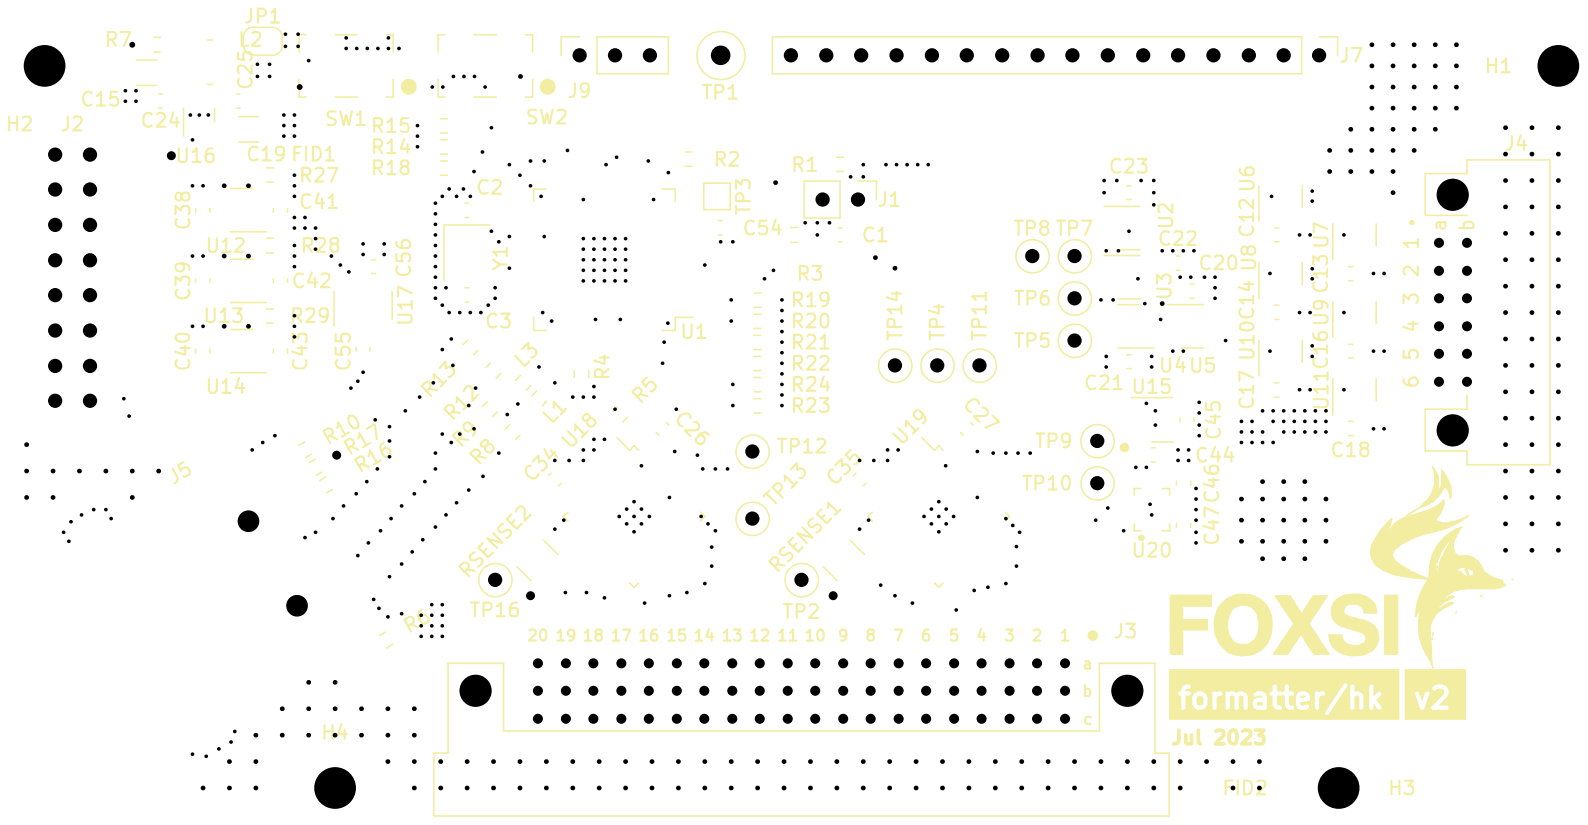
[picture p65: page 7]

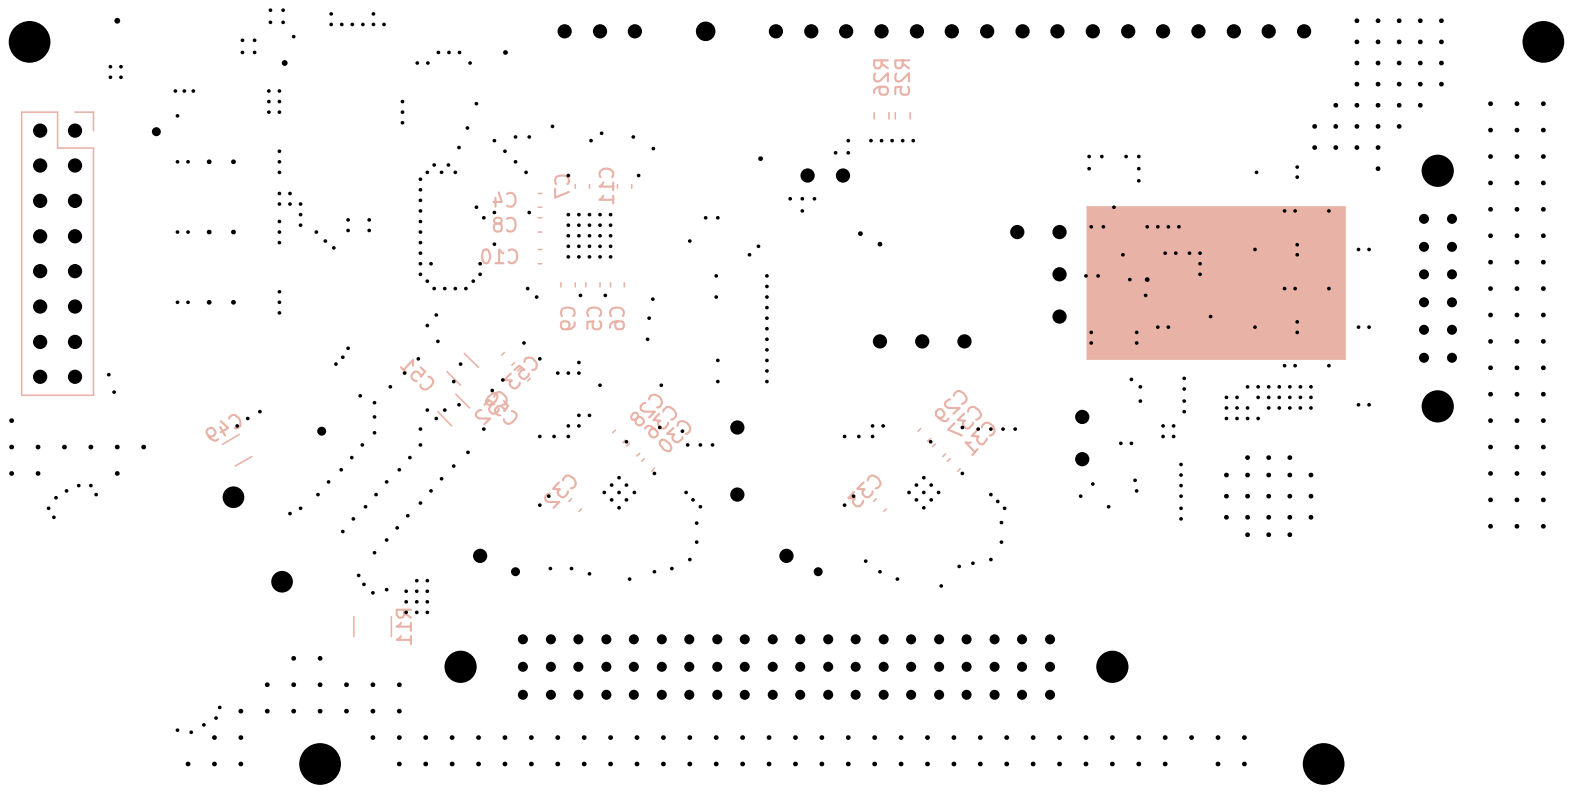
[picture p66: page 8]

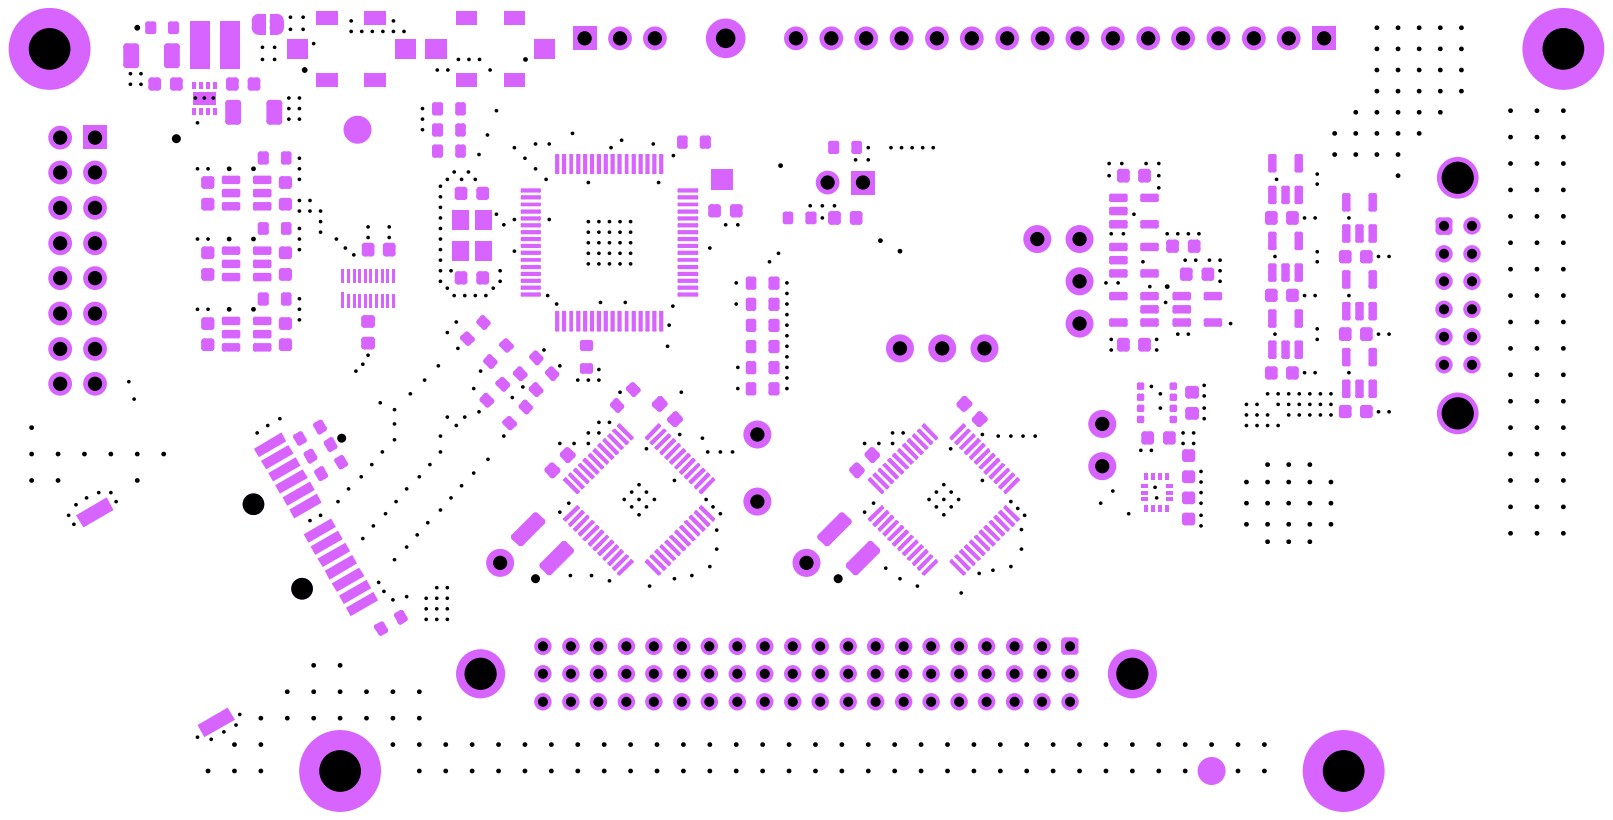
[picture p67: page 9]

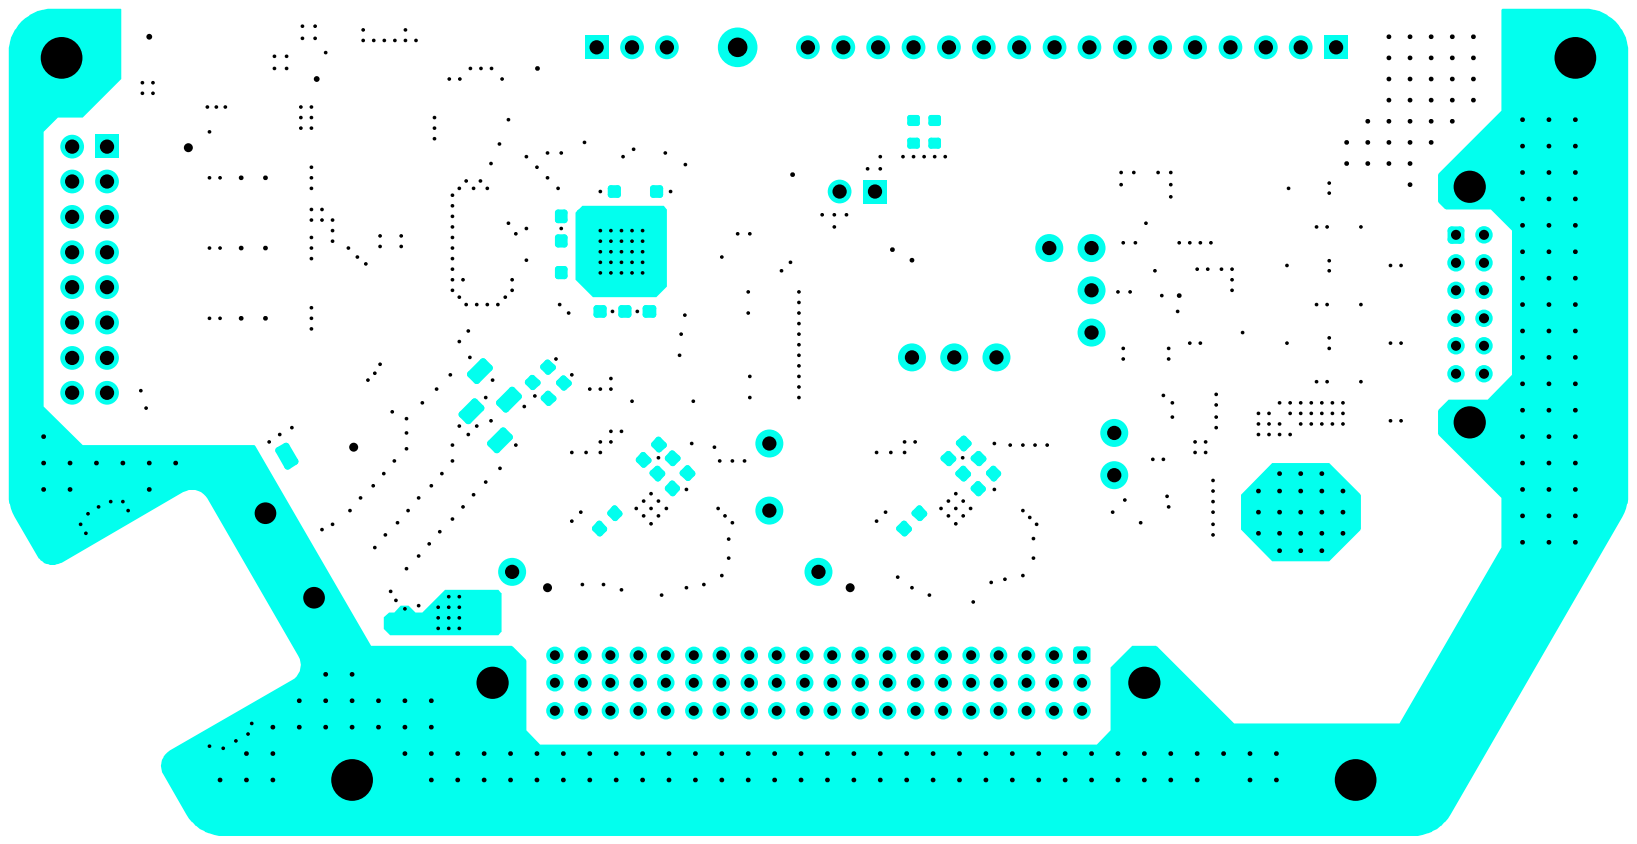
[picture p68: page 10]

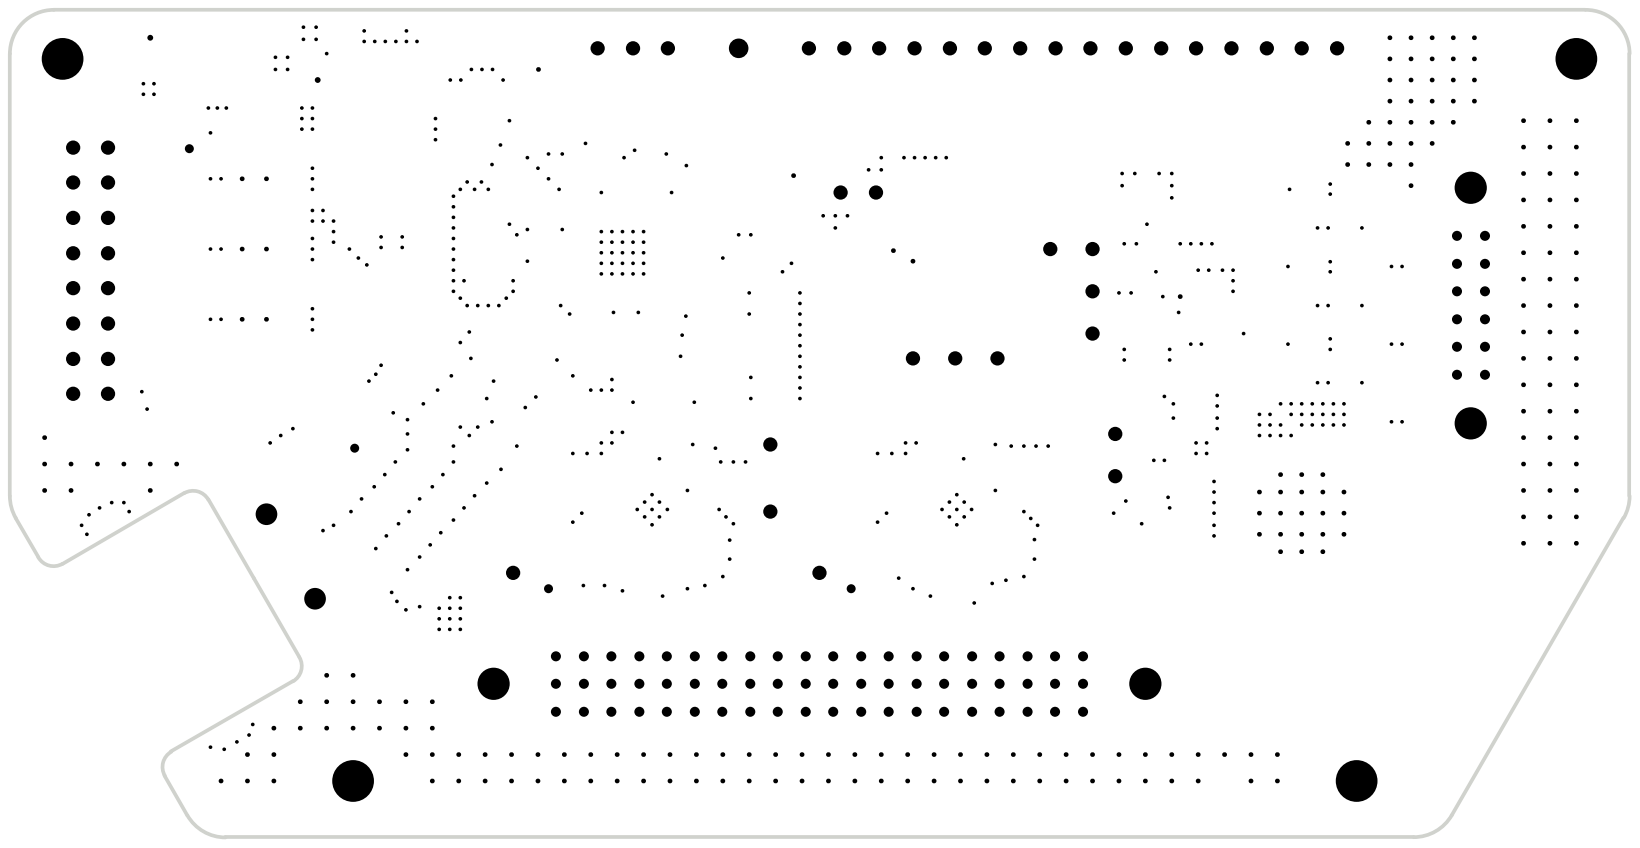
[picture p69: page 11]
