foxsi/UMN-boards-FOXSI-4/power/v3/doc/pour_planning.pdf

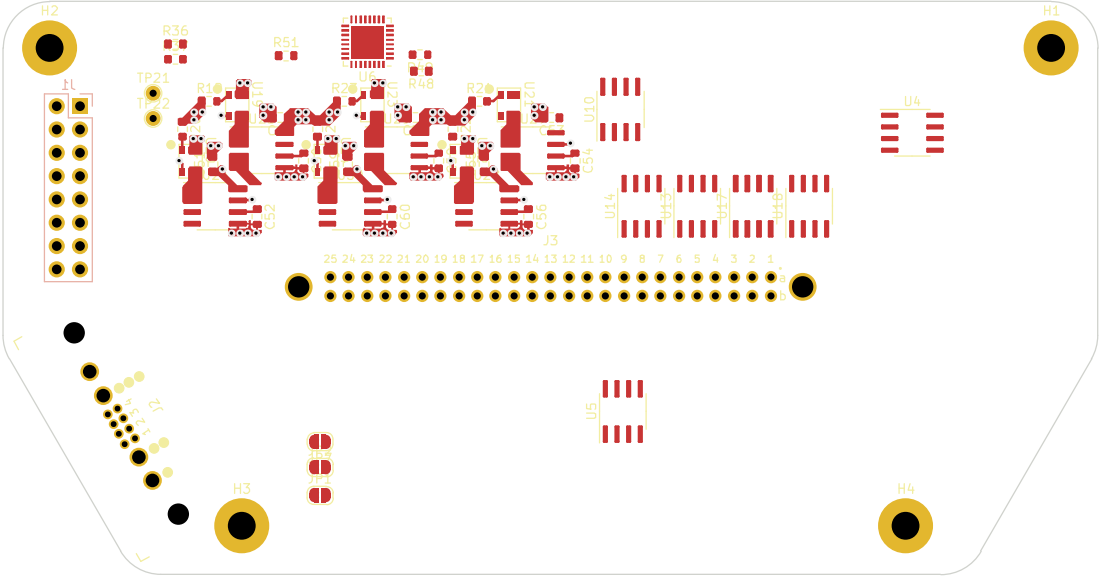
[picture p70: page 1]
