foxsi/UMN-boards-FOXSI-4/plenum/v2/doc/draw_planes.pdf

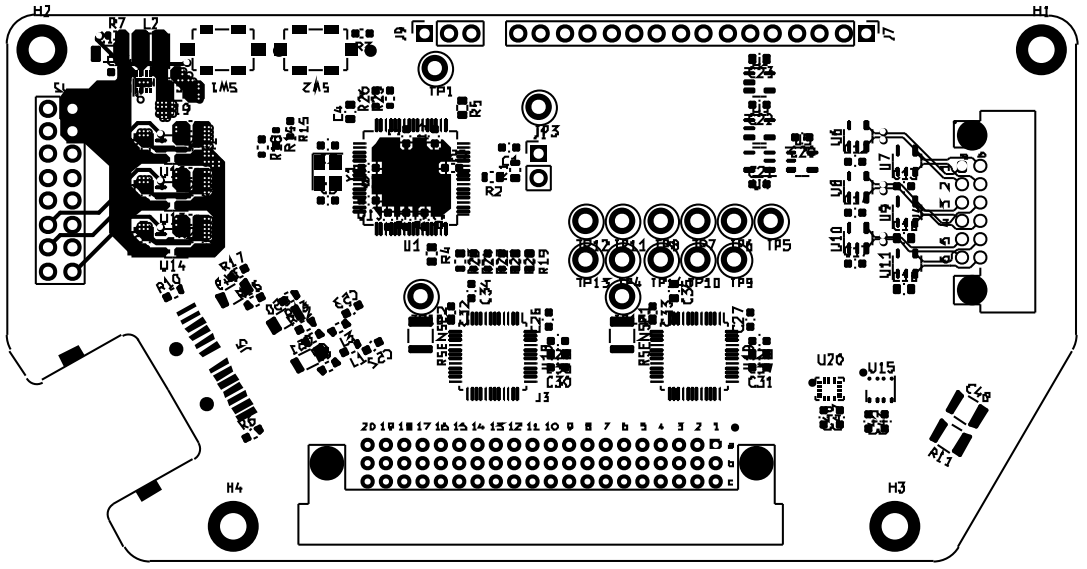
[picture p71: page 1]
