foxsi/UMN-boards-FOXSI-4/plenum/v2/doc/outline_regions.pdf

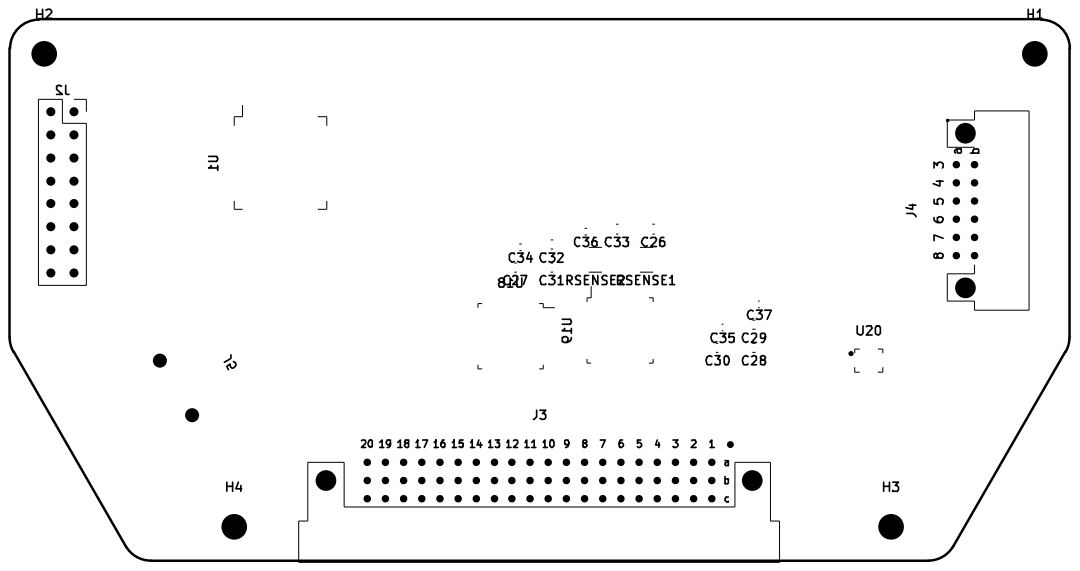
[picture p72: page 1]
