foxsi/UMN-boards-FOXSI-4/little_switch/v2/doc/switch_no_planes.pdf

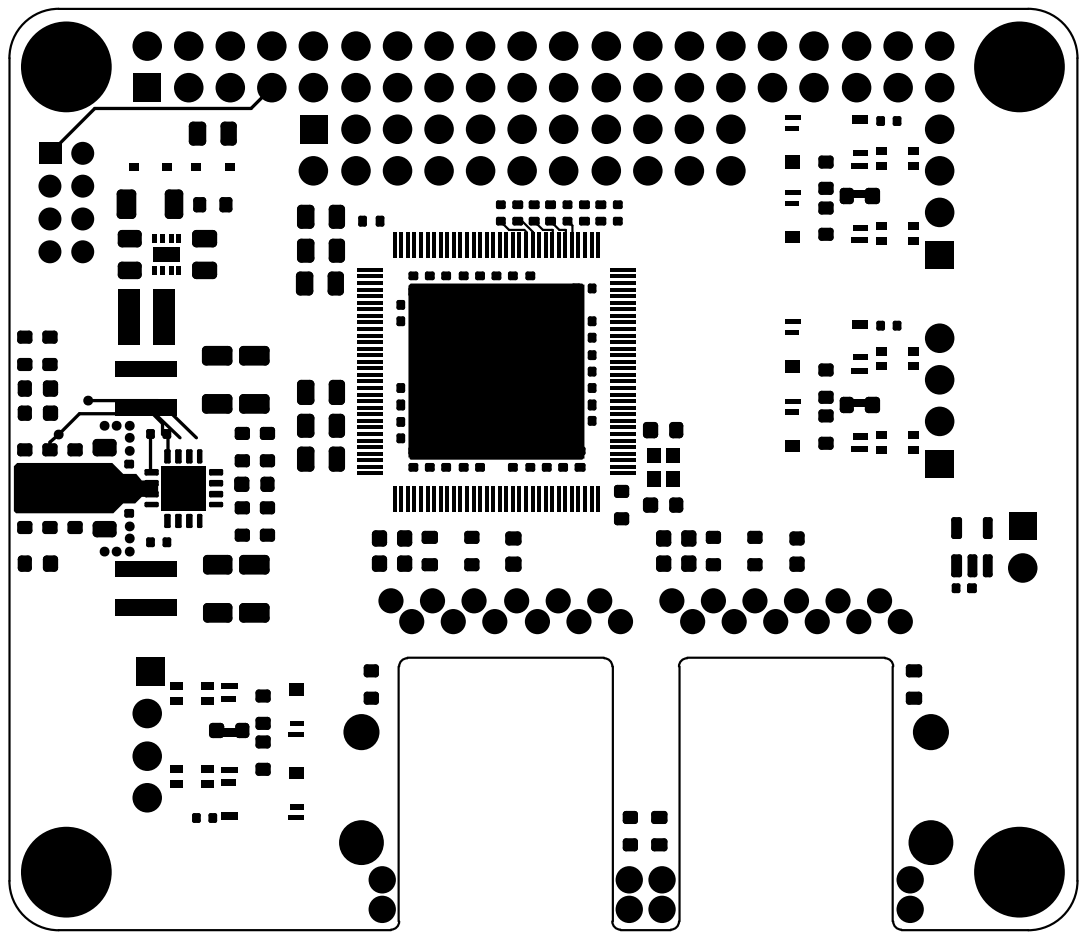
[picture p73: page 1]
