foxsi/UMN-boards-FOXSI-4/plenum/v1/build/housekeeping.pdf

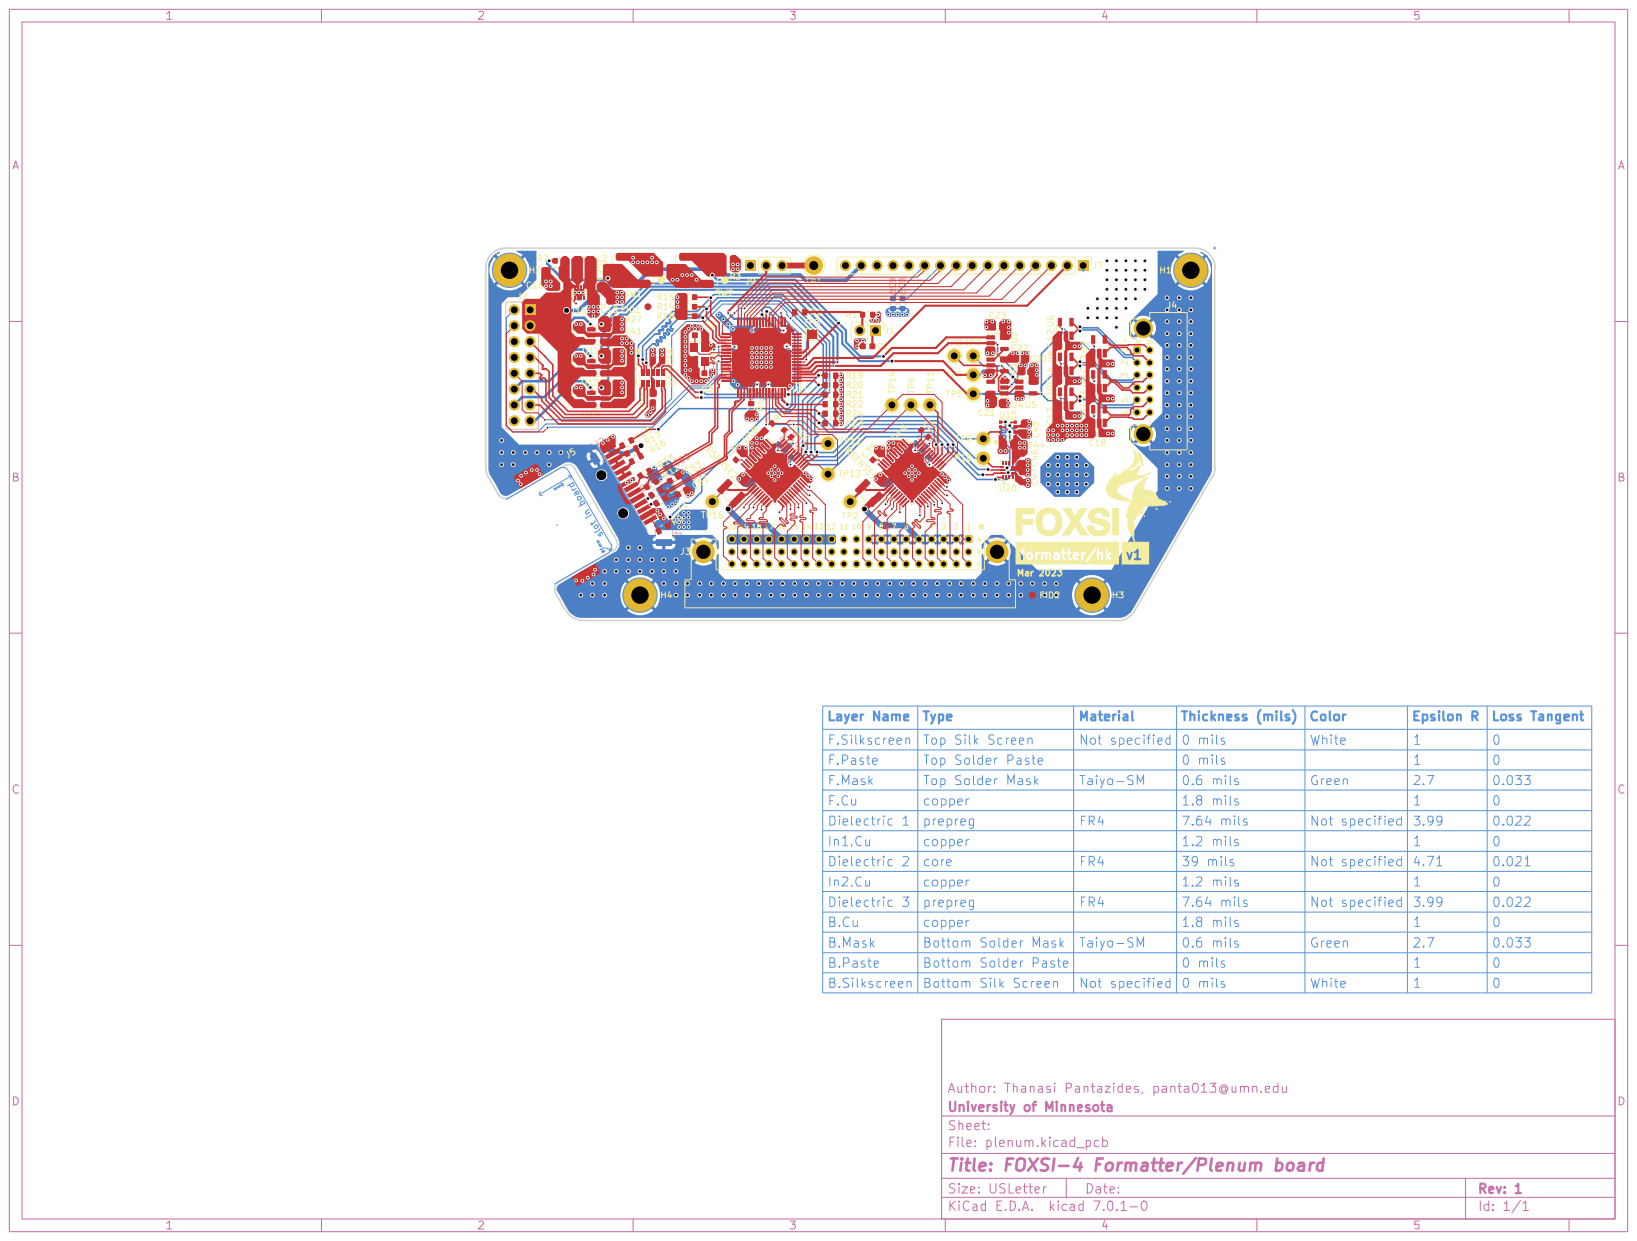
[picture p74: page 1]
