foxsi/UMN-boards-FOXSI-4/plenum/v1/build/layers.pdf

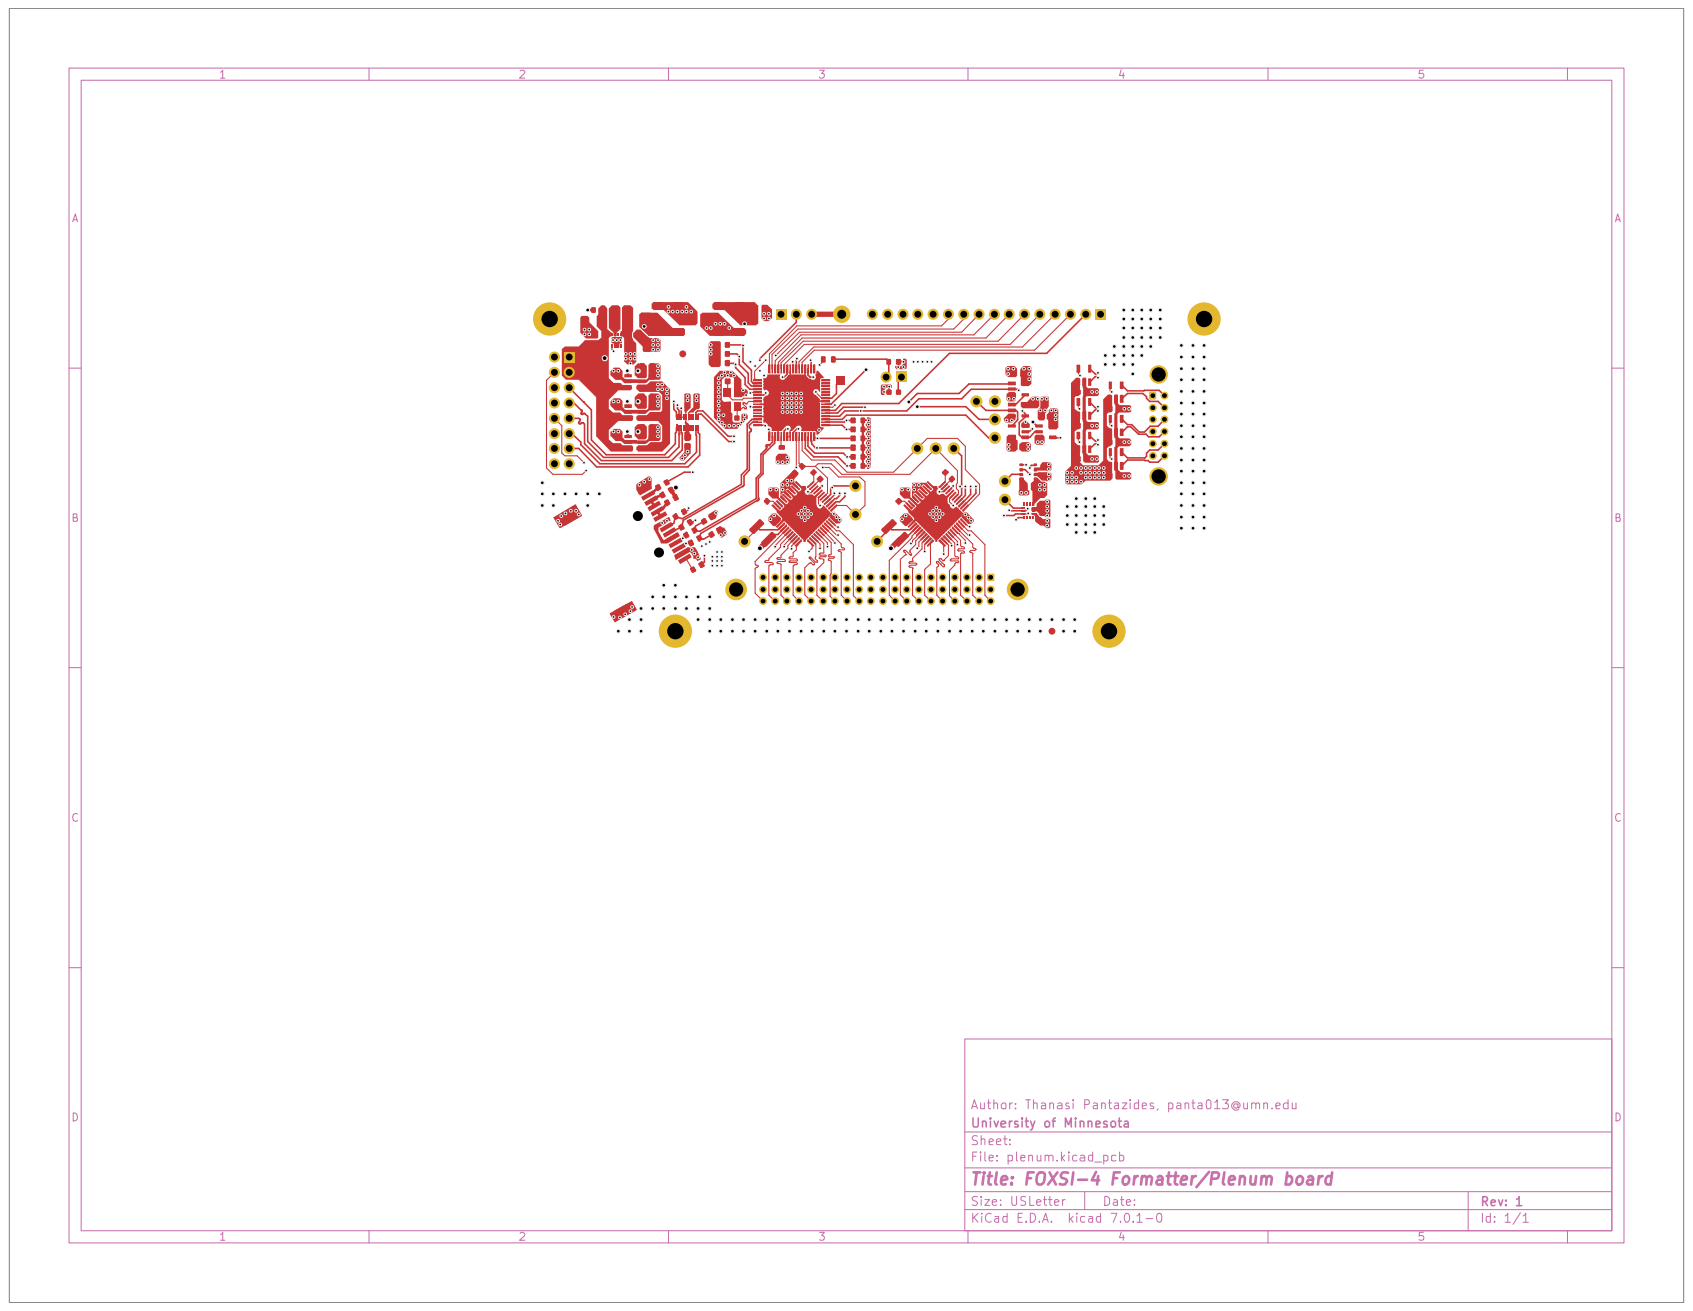
[picture p75: page 1]

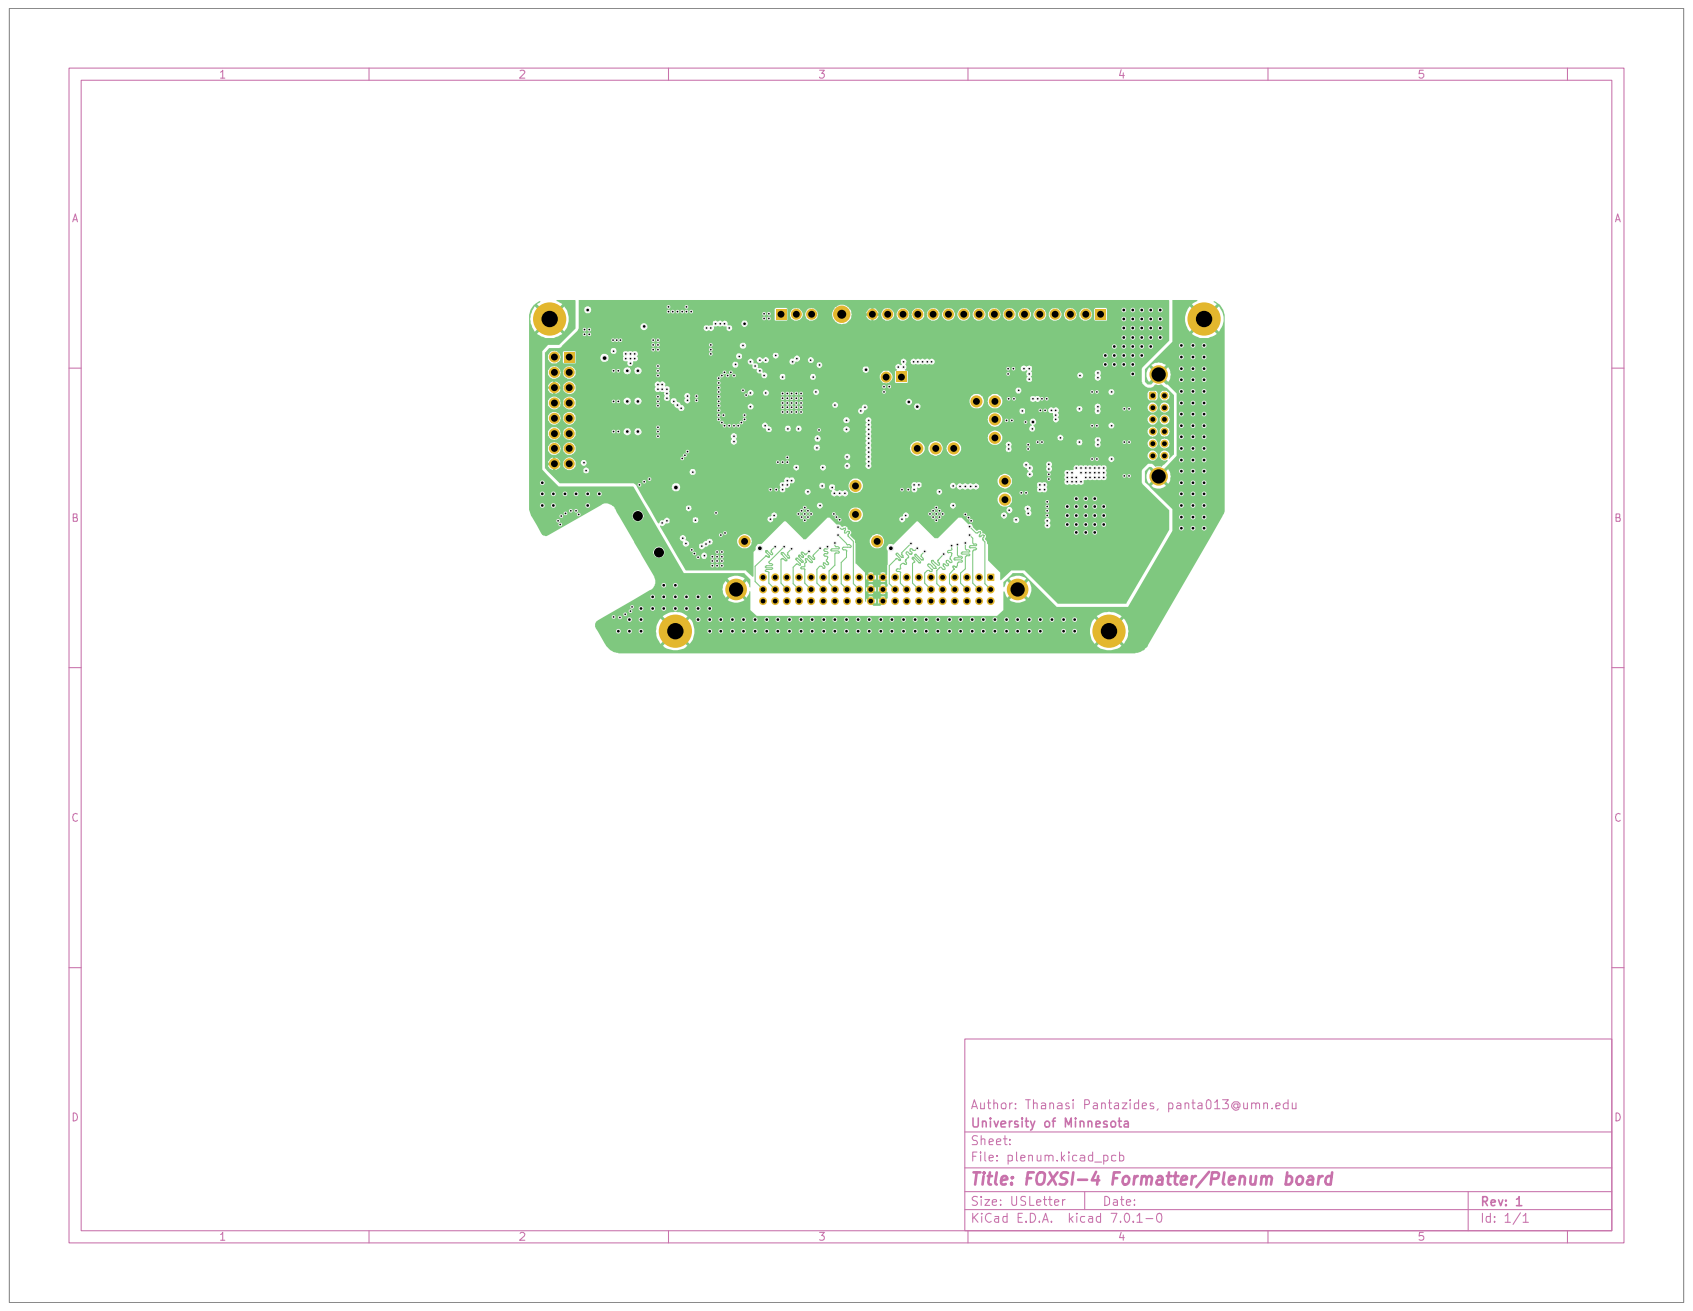
[picture p76: page 2]

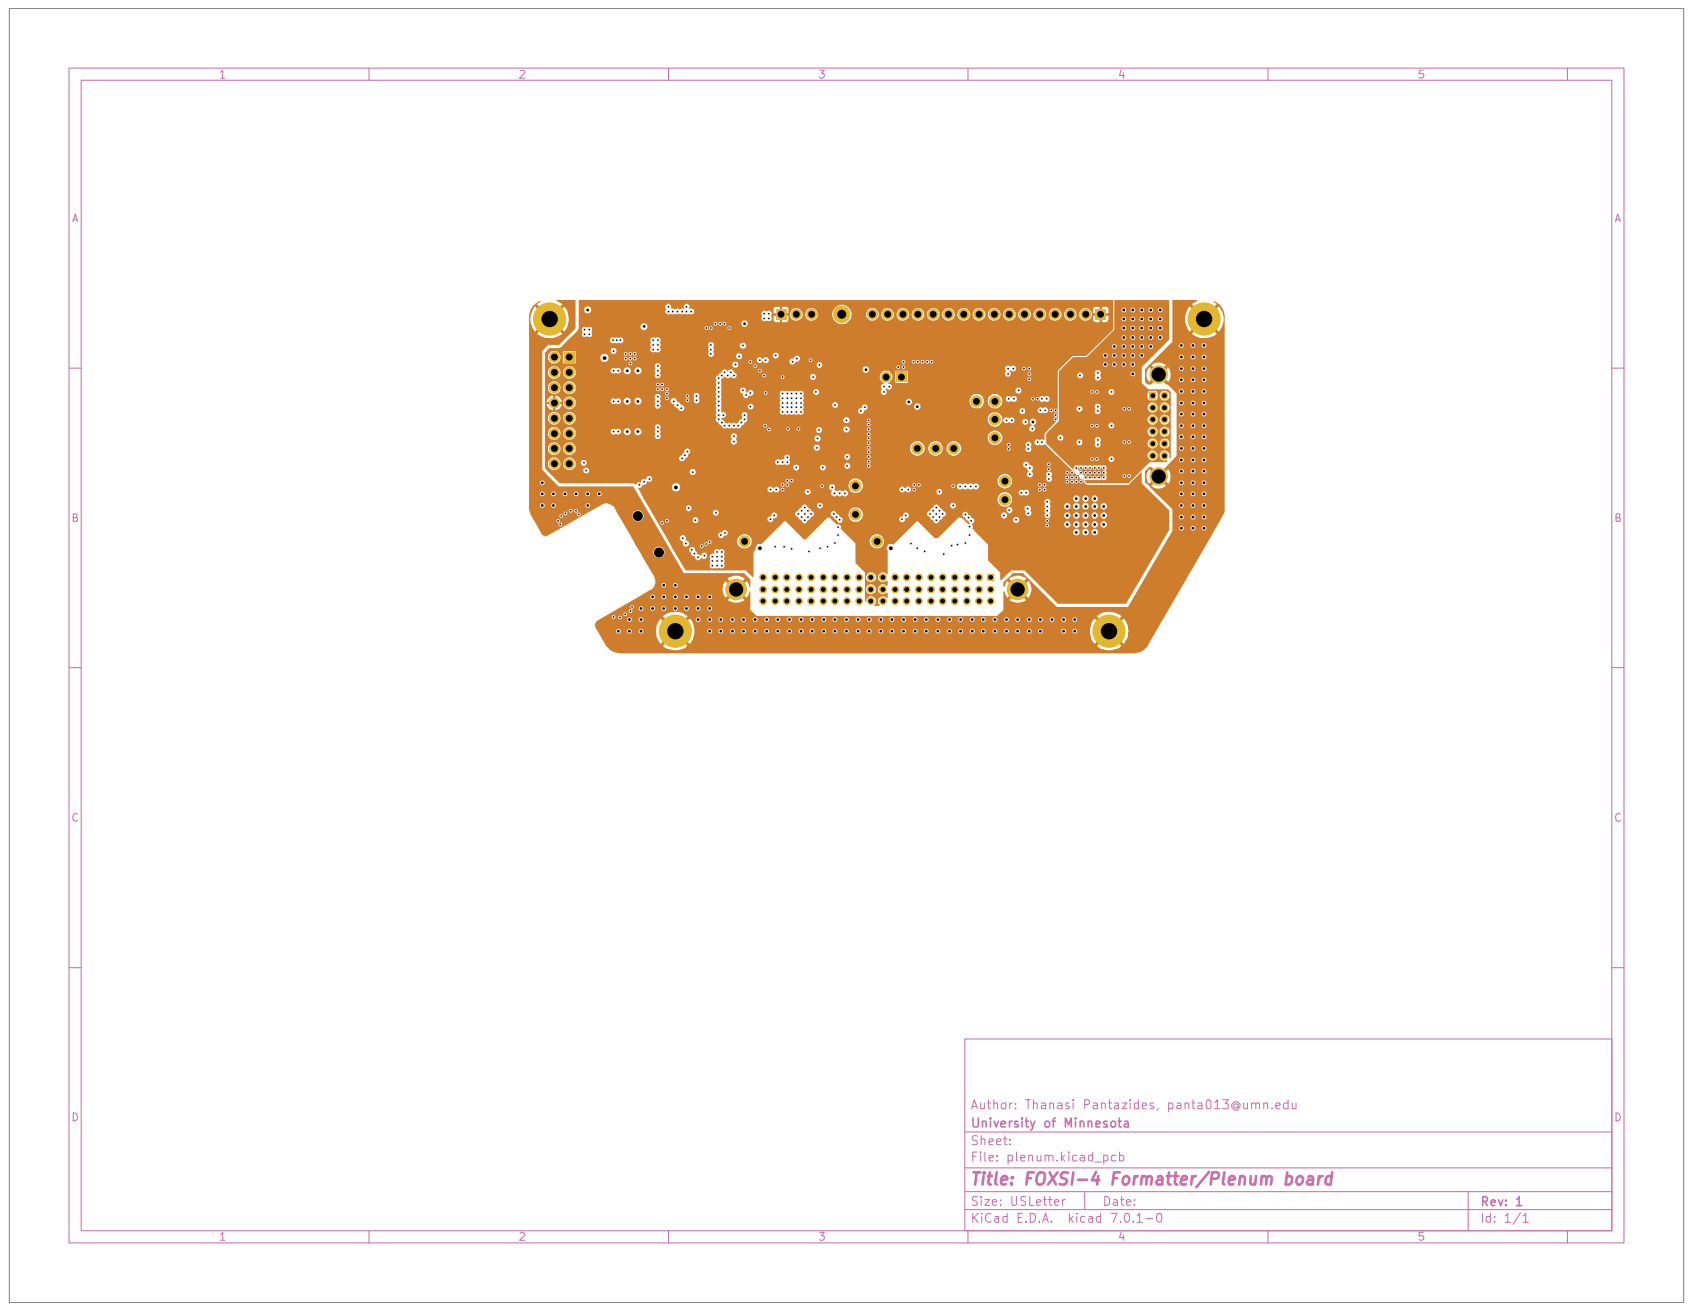
[picture p77: page 3]

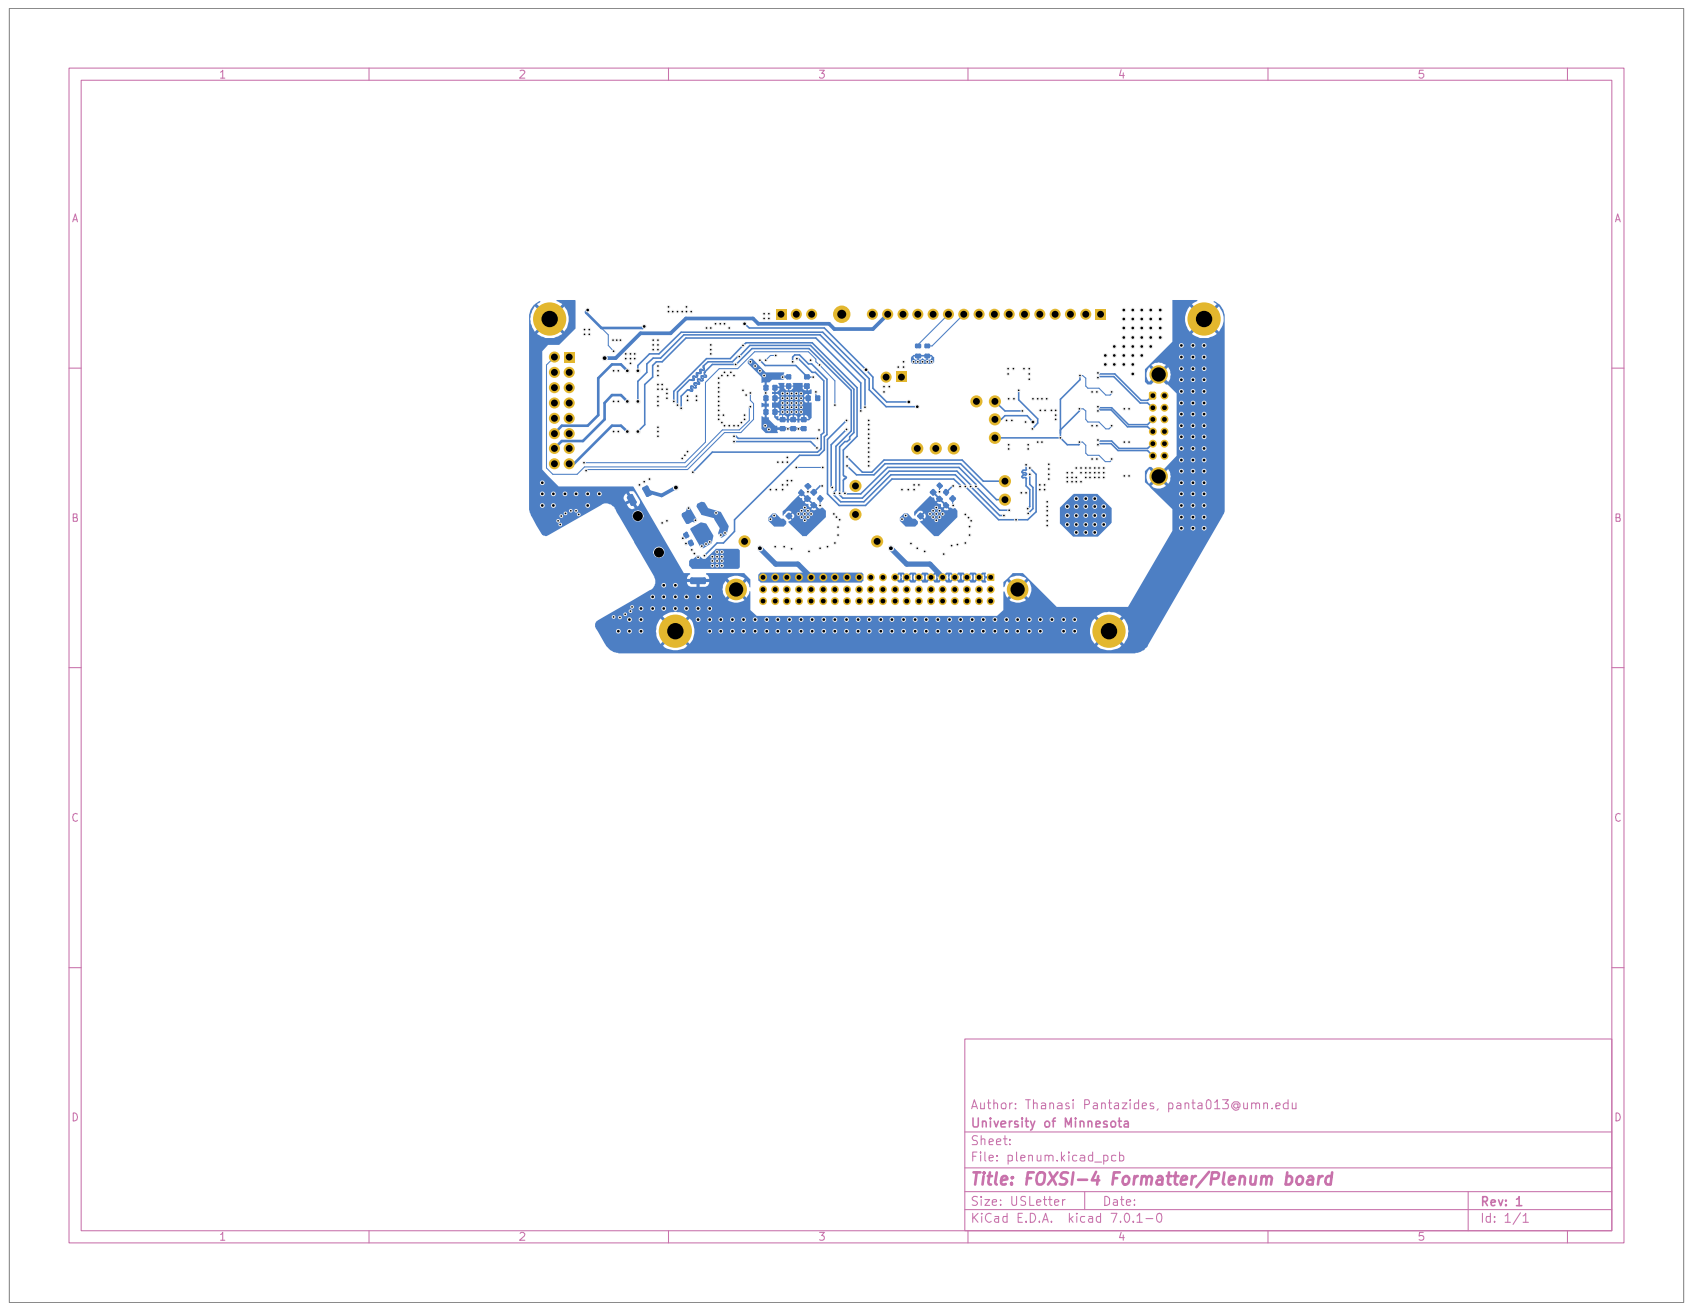
[picture p78: page 4]

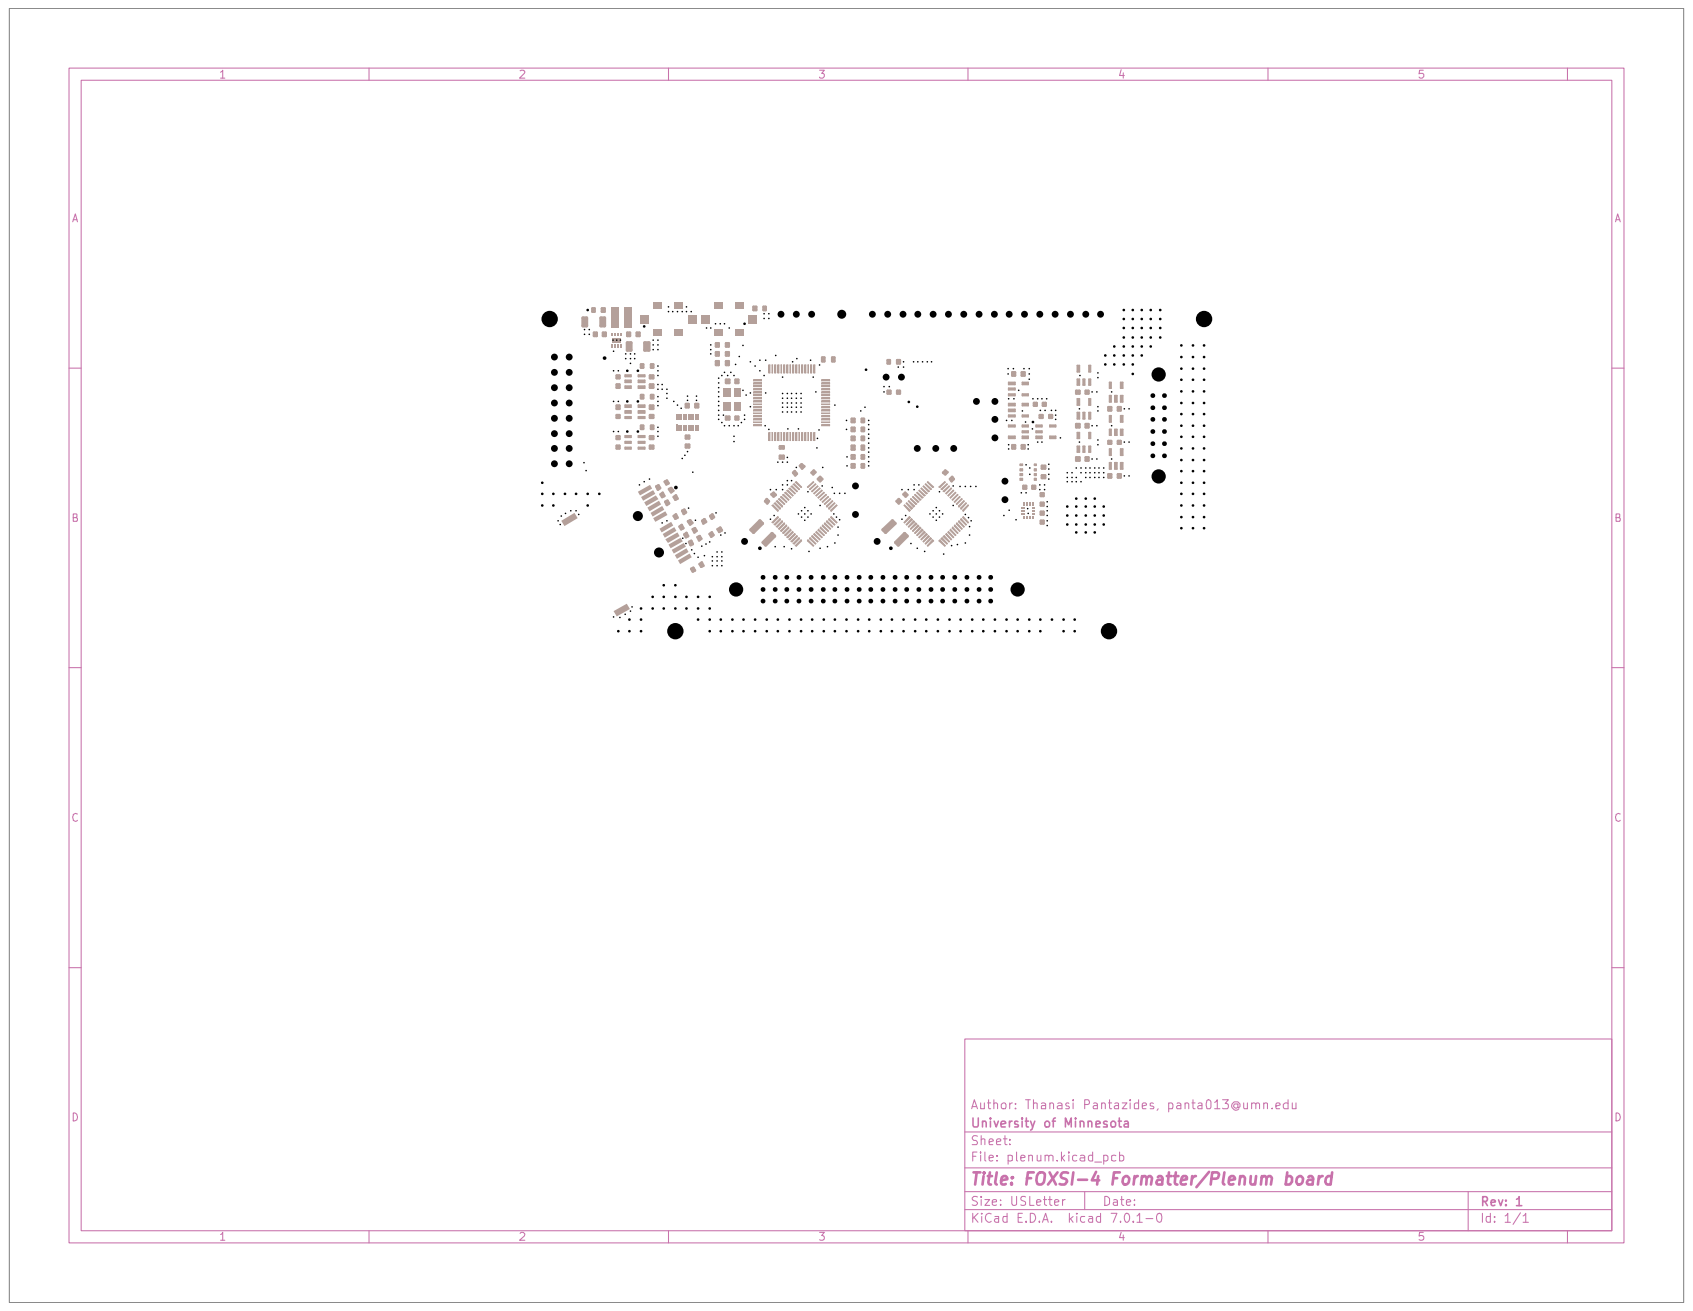
[picture p79: page 5]

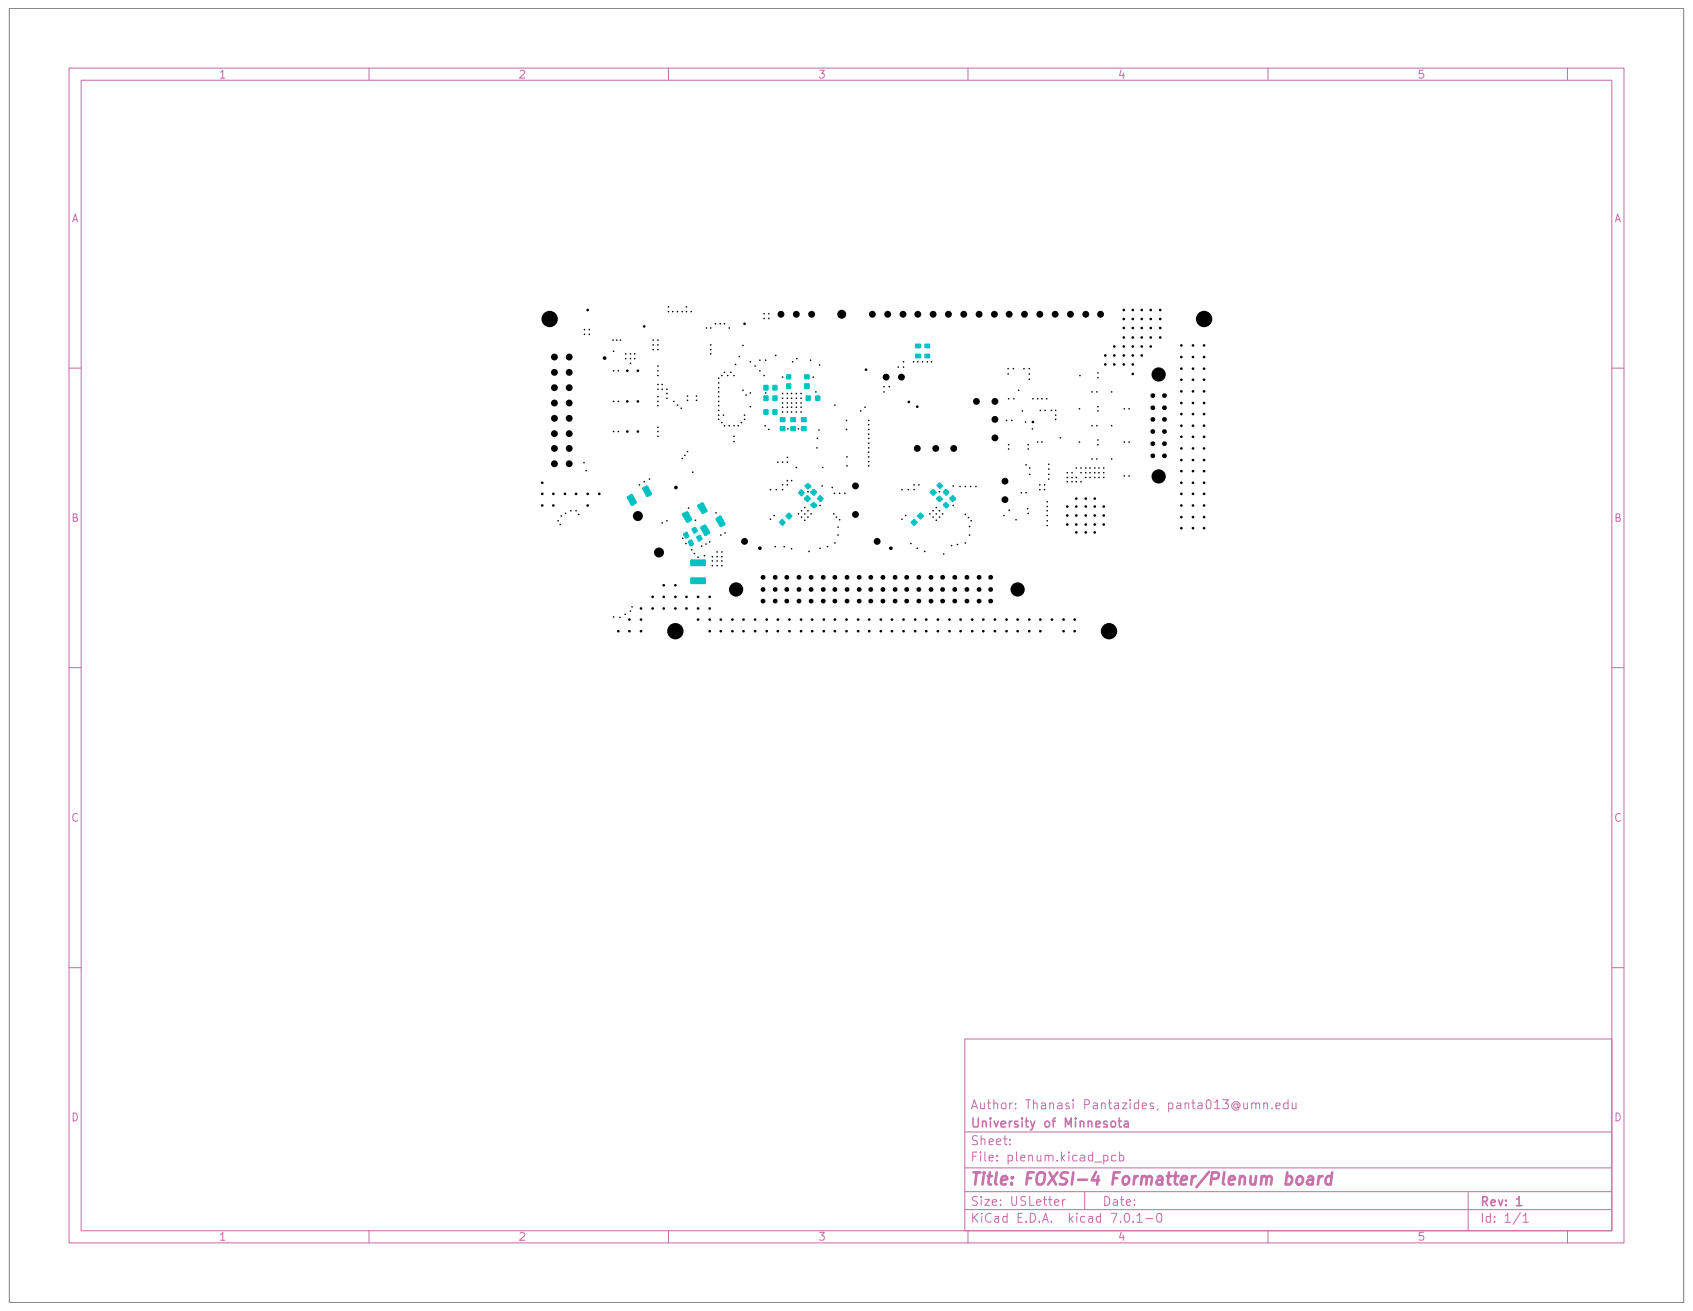
[picture p80: page 6]

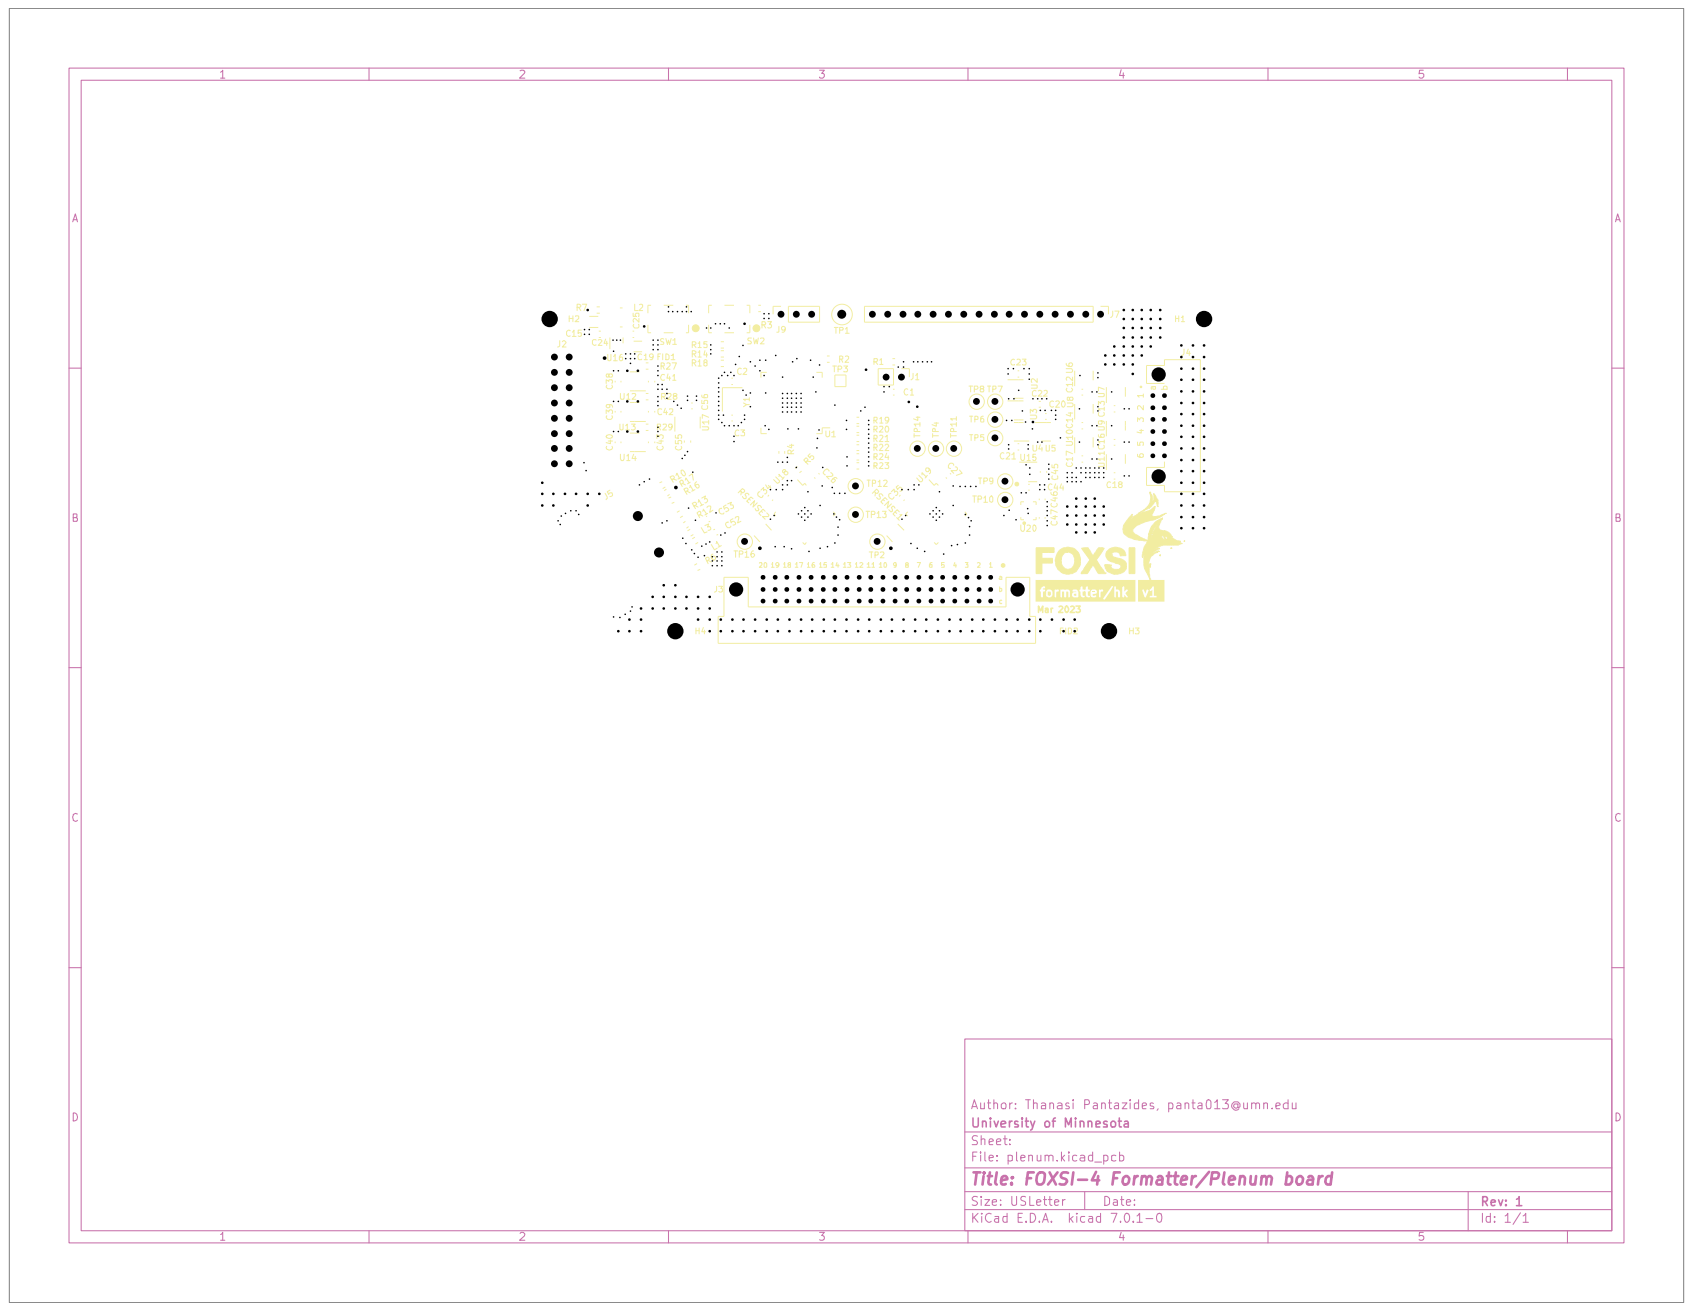
[picture p81: page 7]

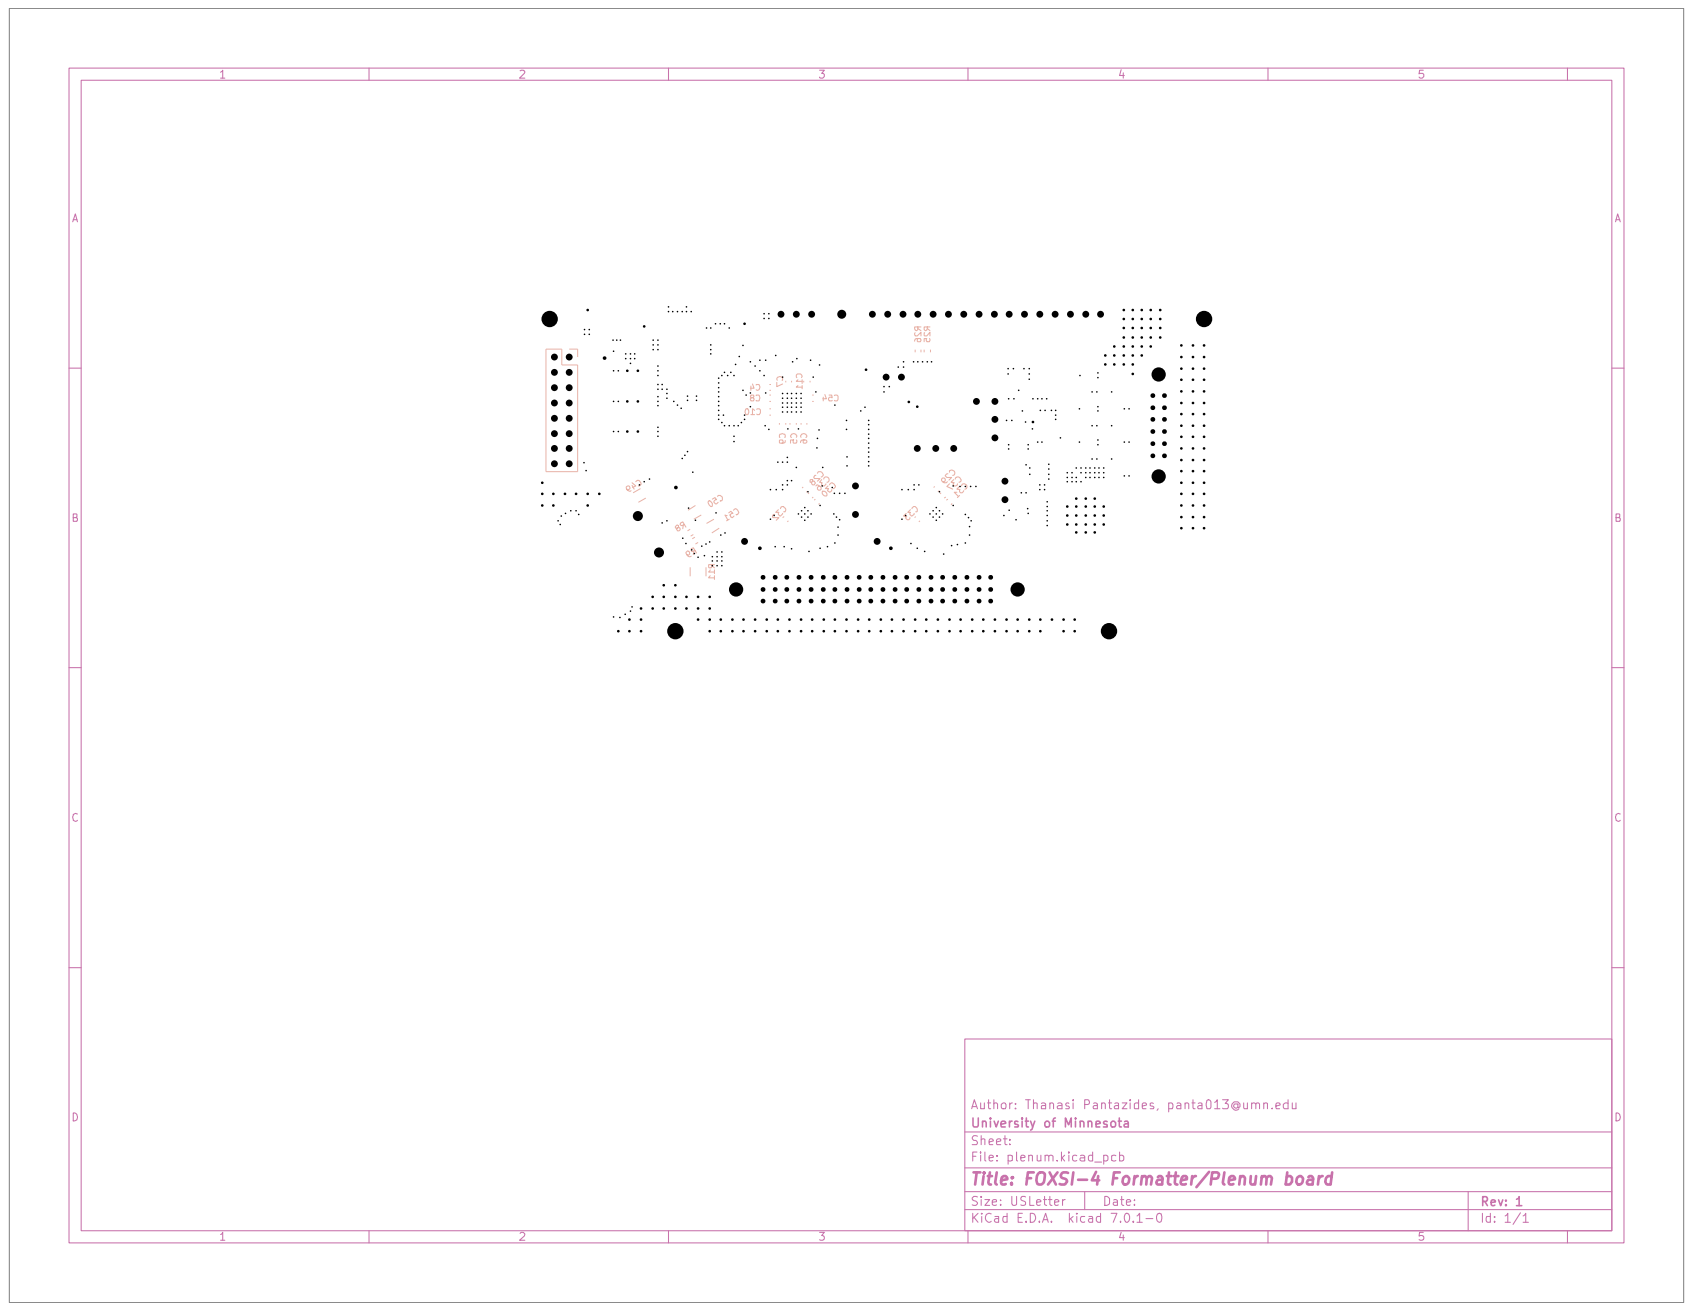
[picture p82: page 8]

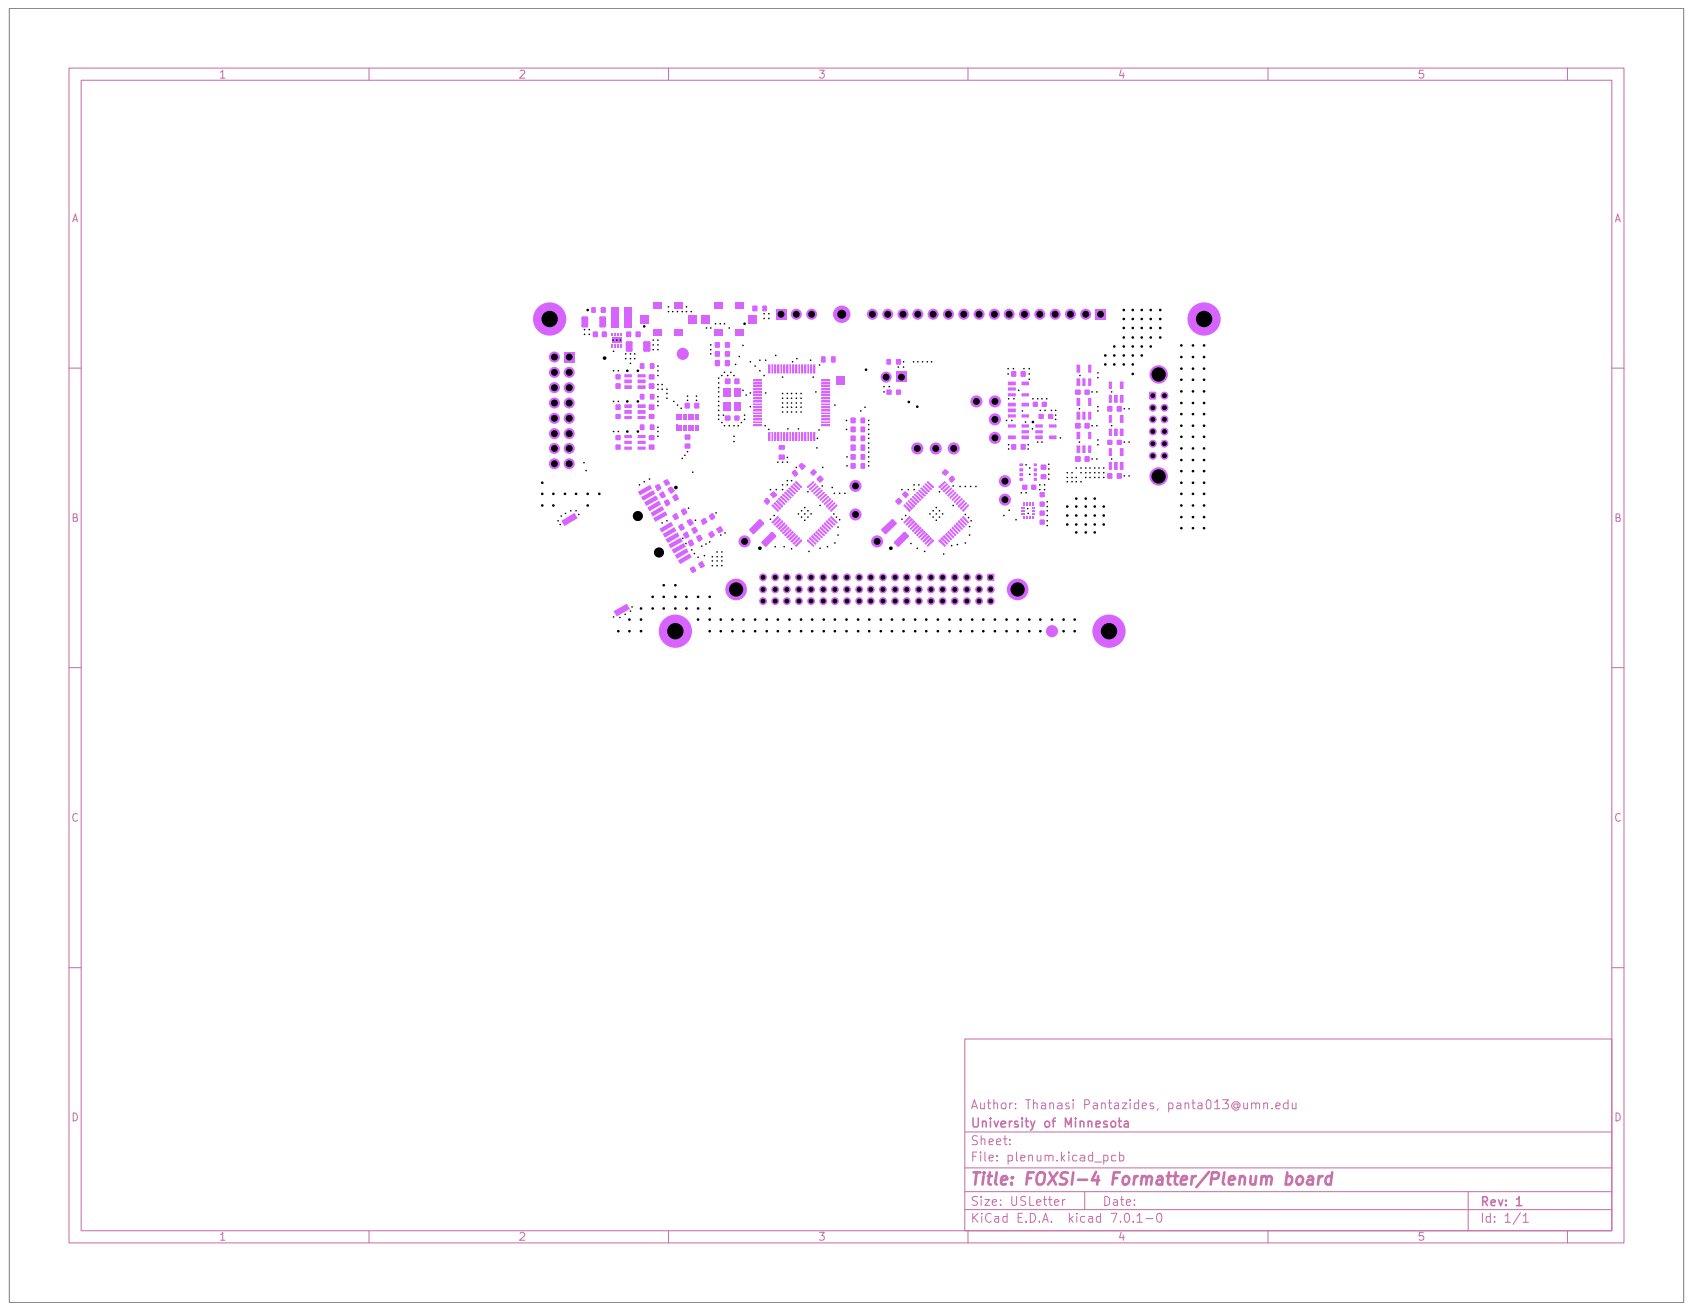
[picture p83: page 9]

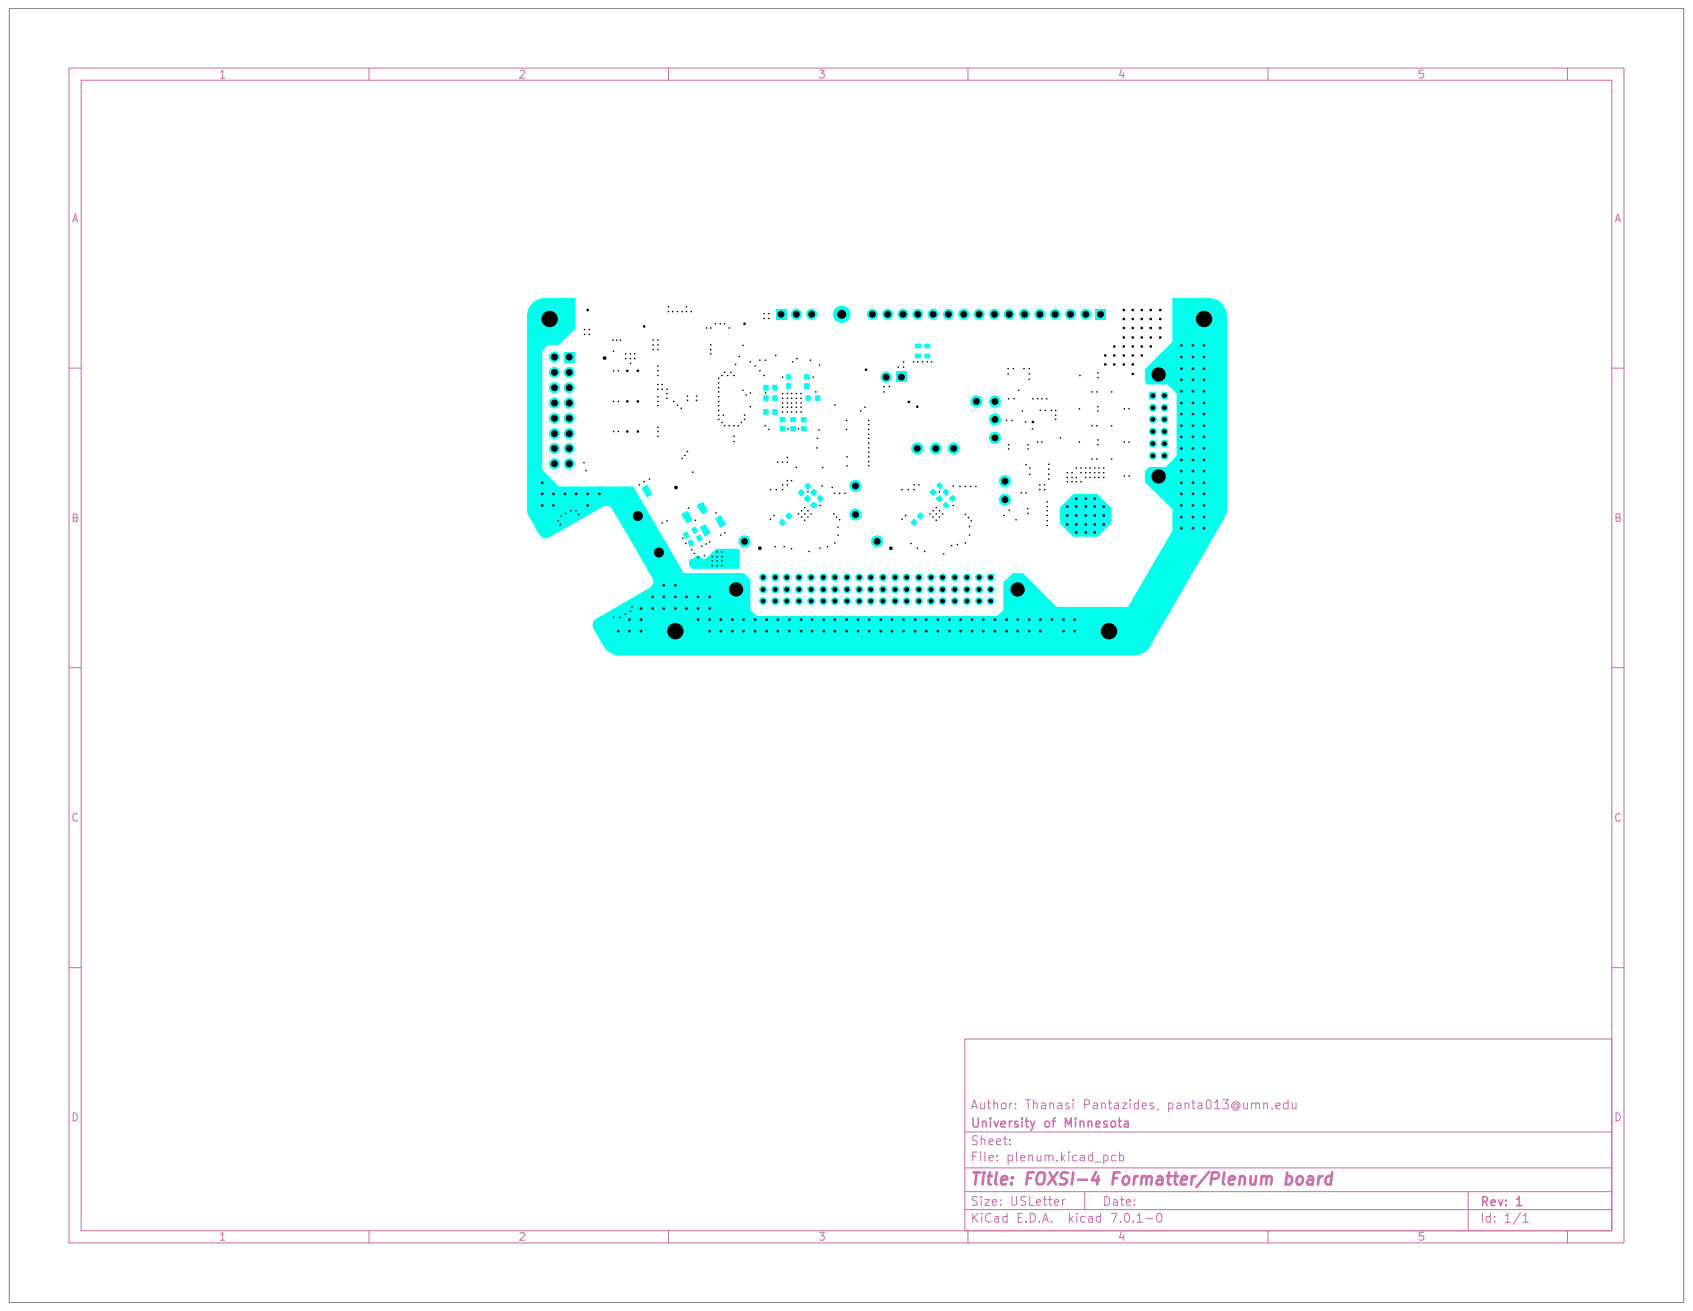
[picture p84: page 10]

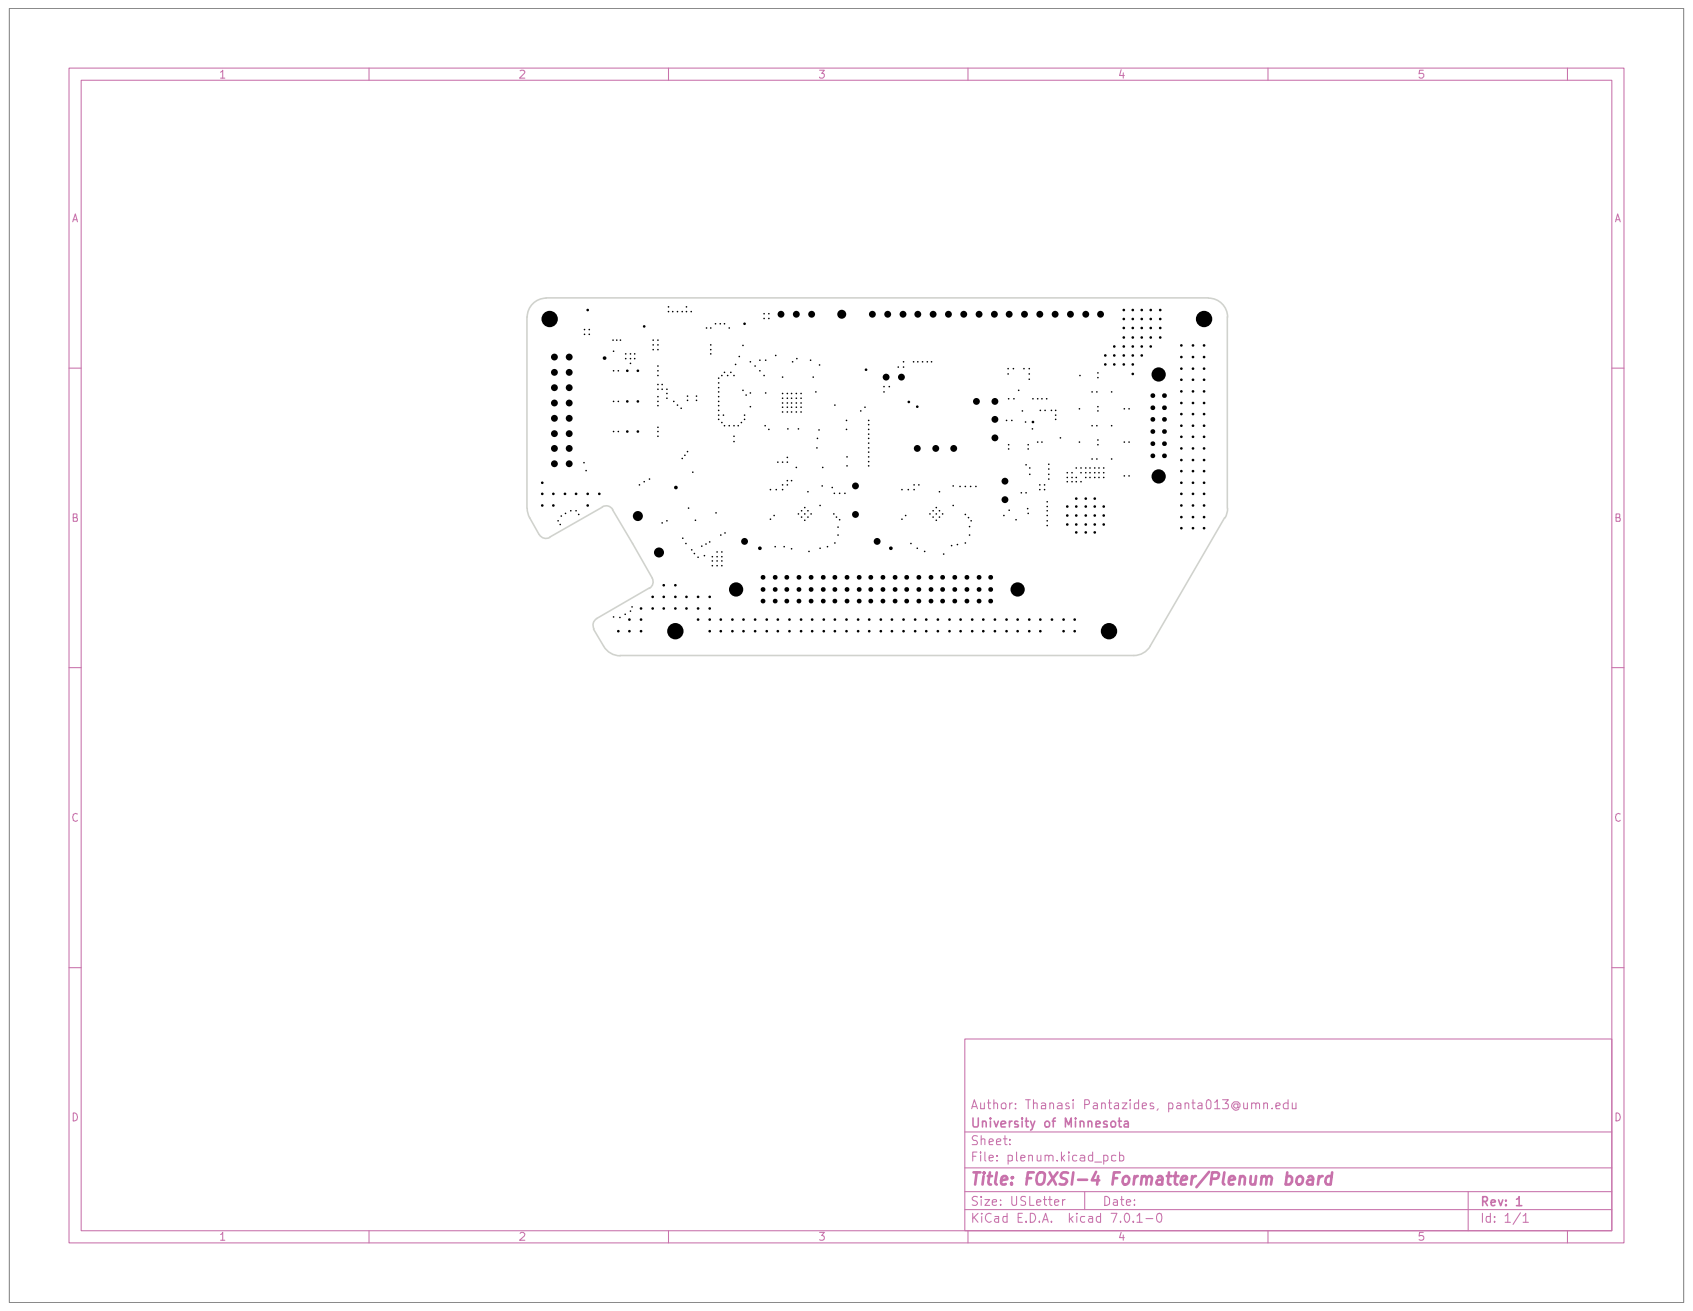
[picture p85: page 11]
