foxsi/UMN-boards-FOXSI-4/little_switch/v1/build/gerber_view.pdf

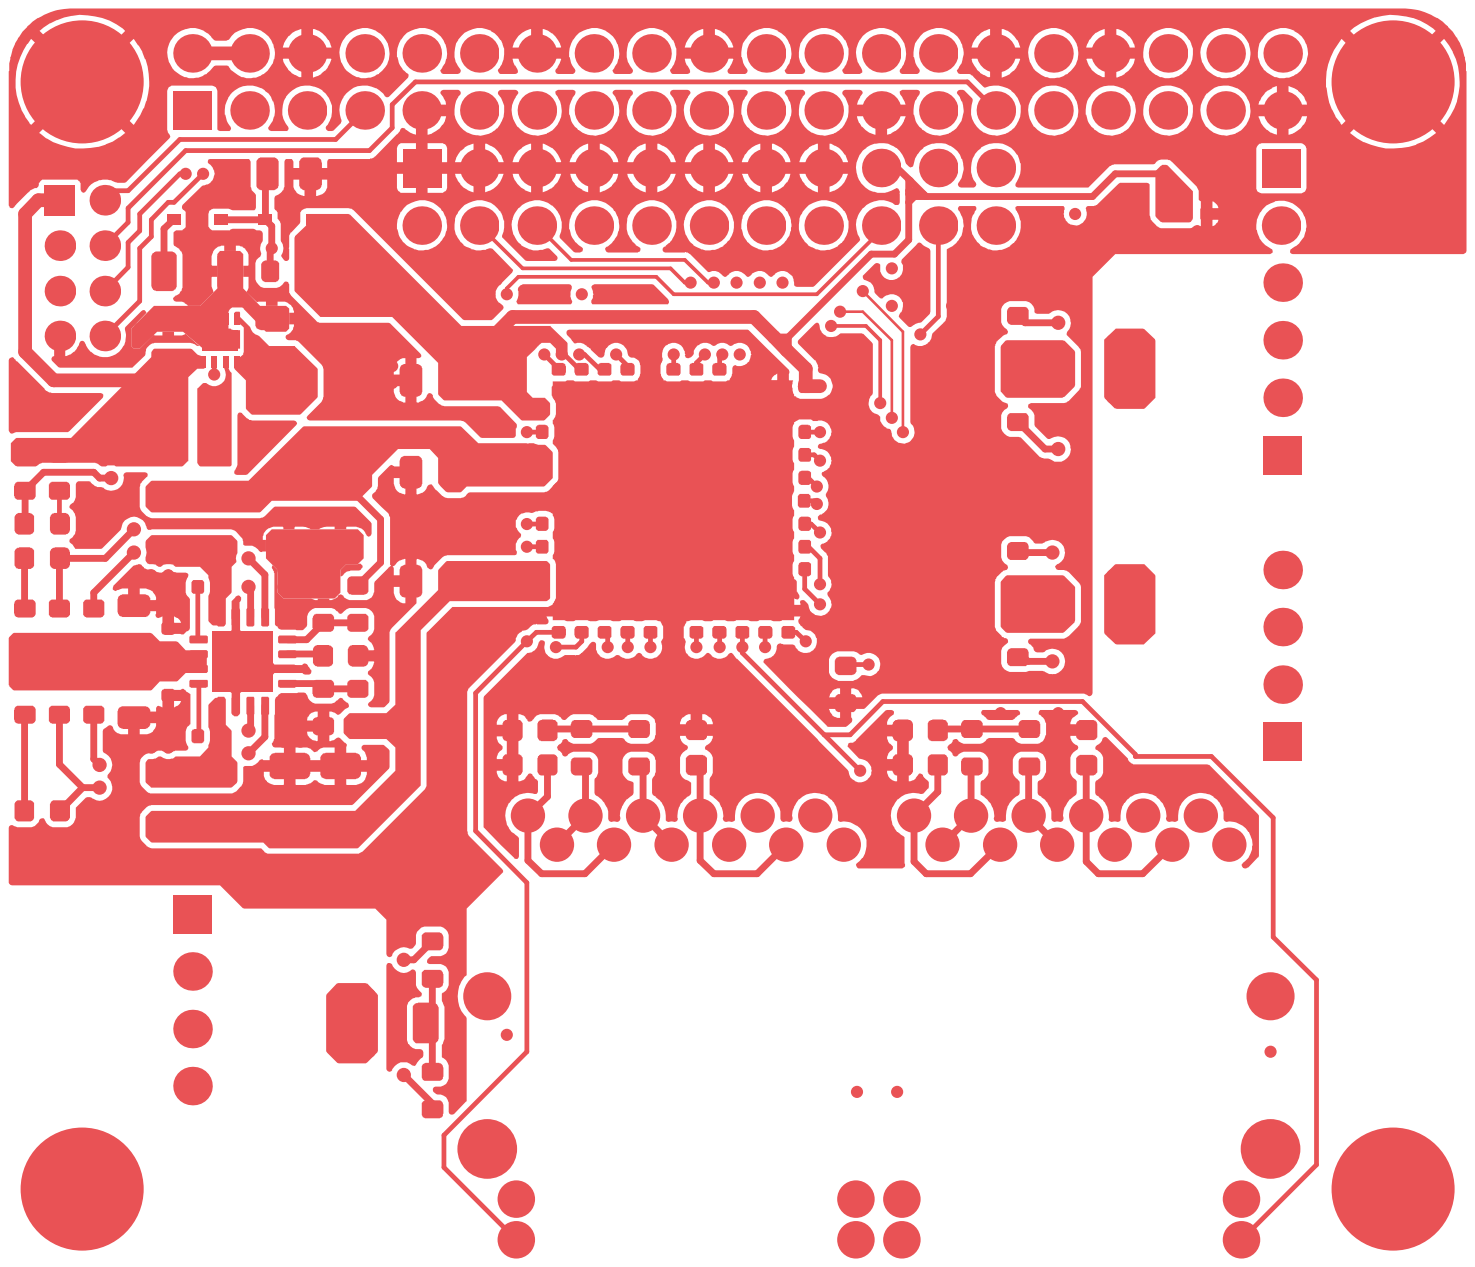
[picture p86: page 2]

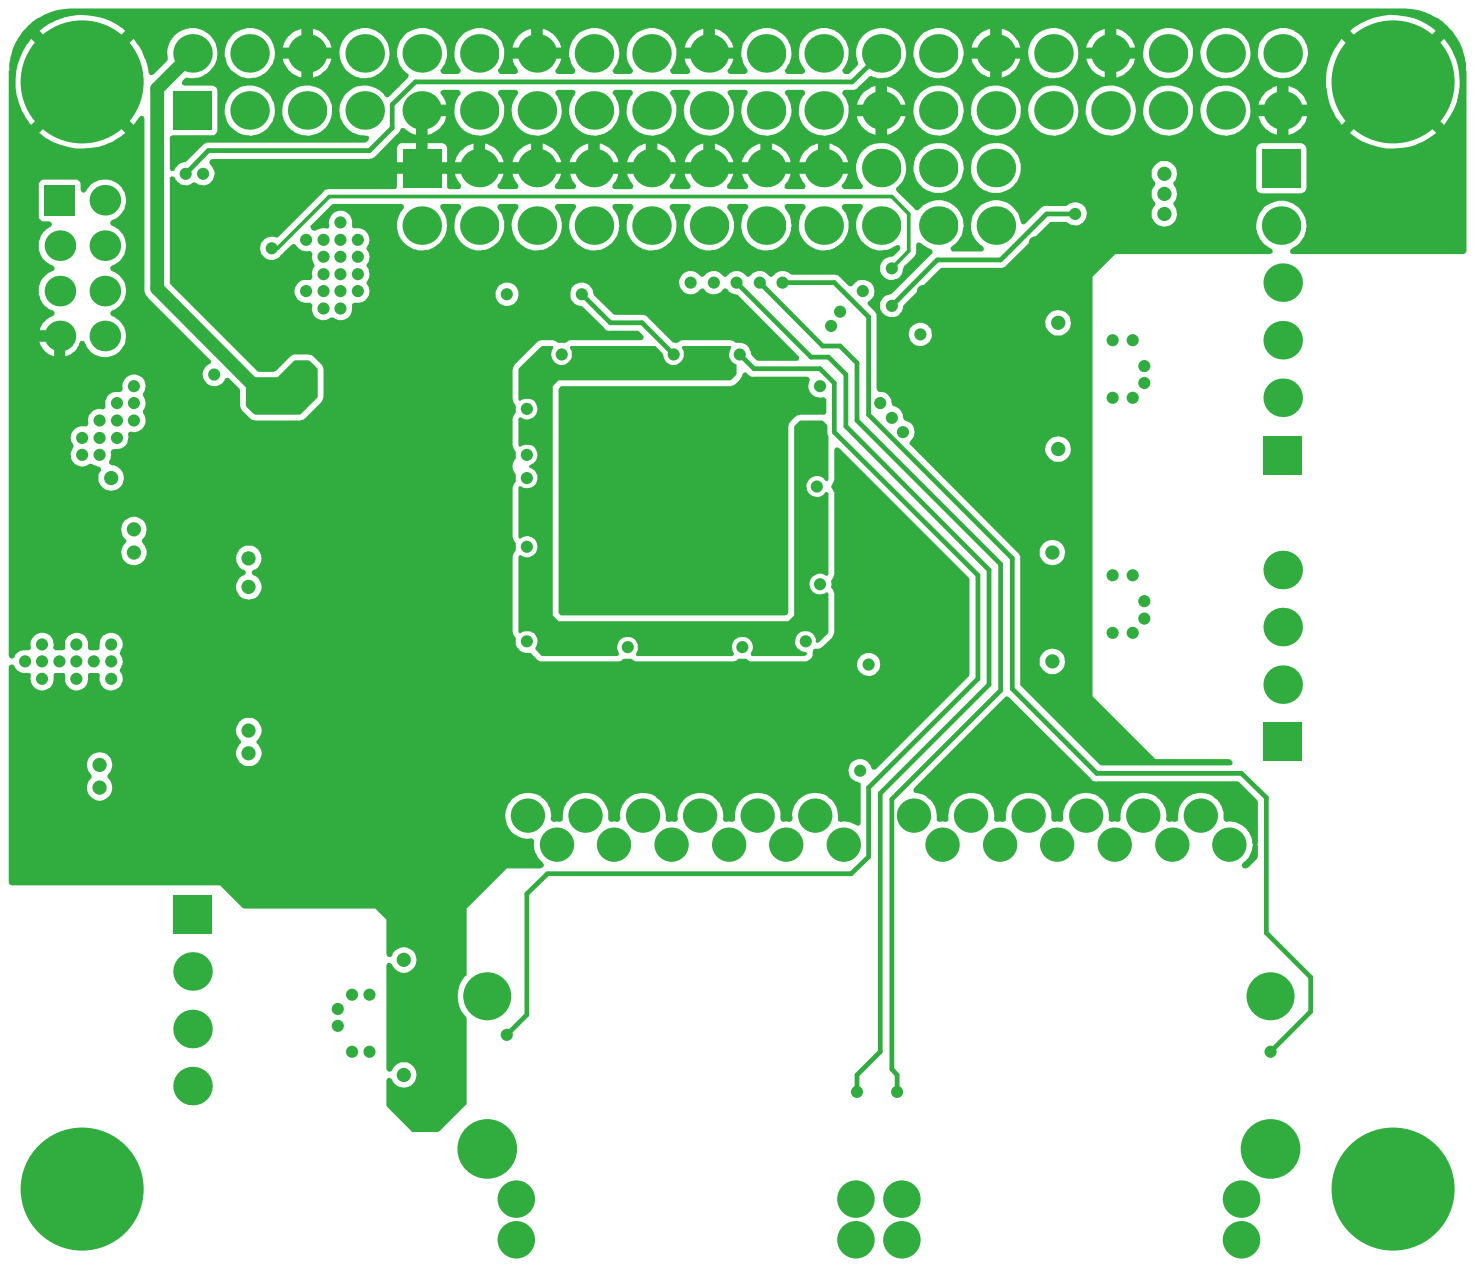
[picture p87: page 3]

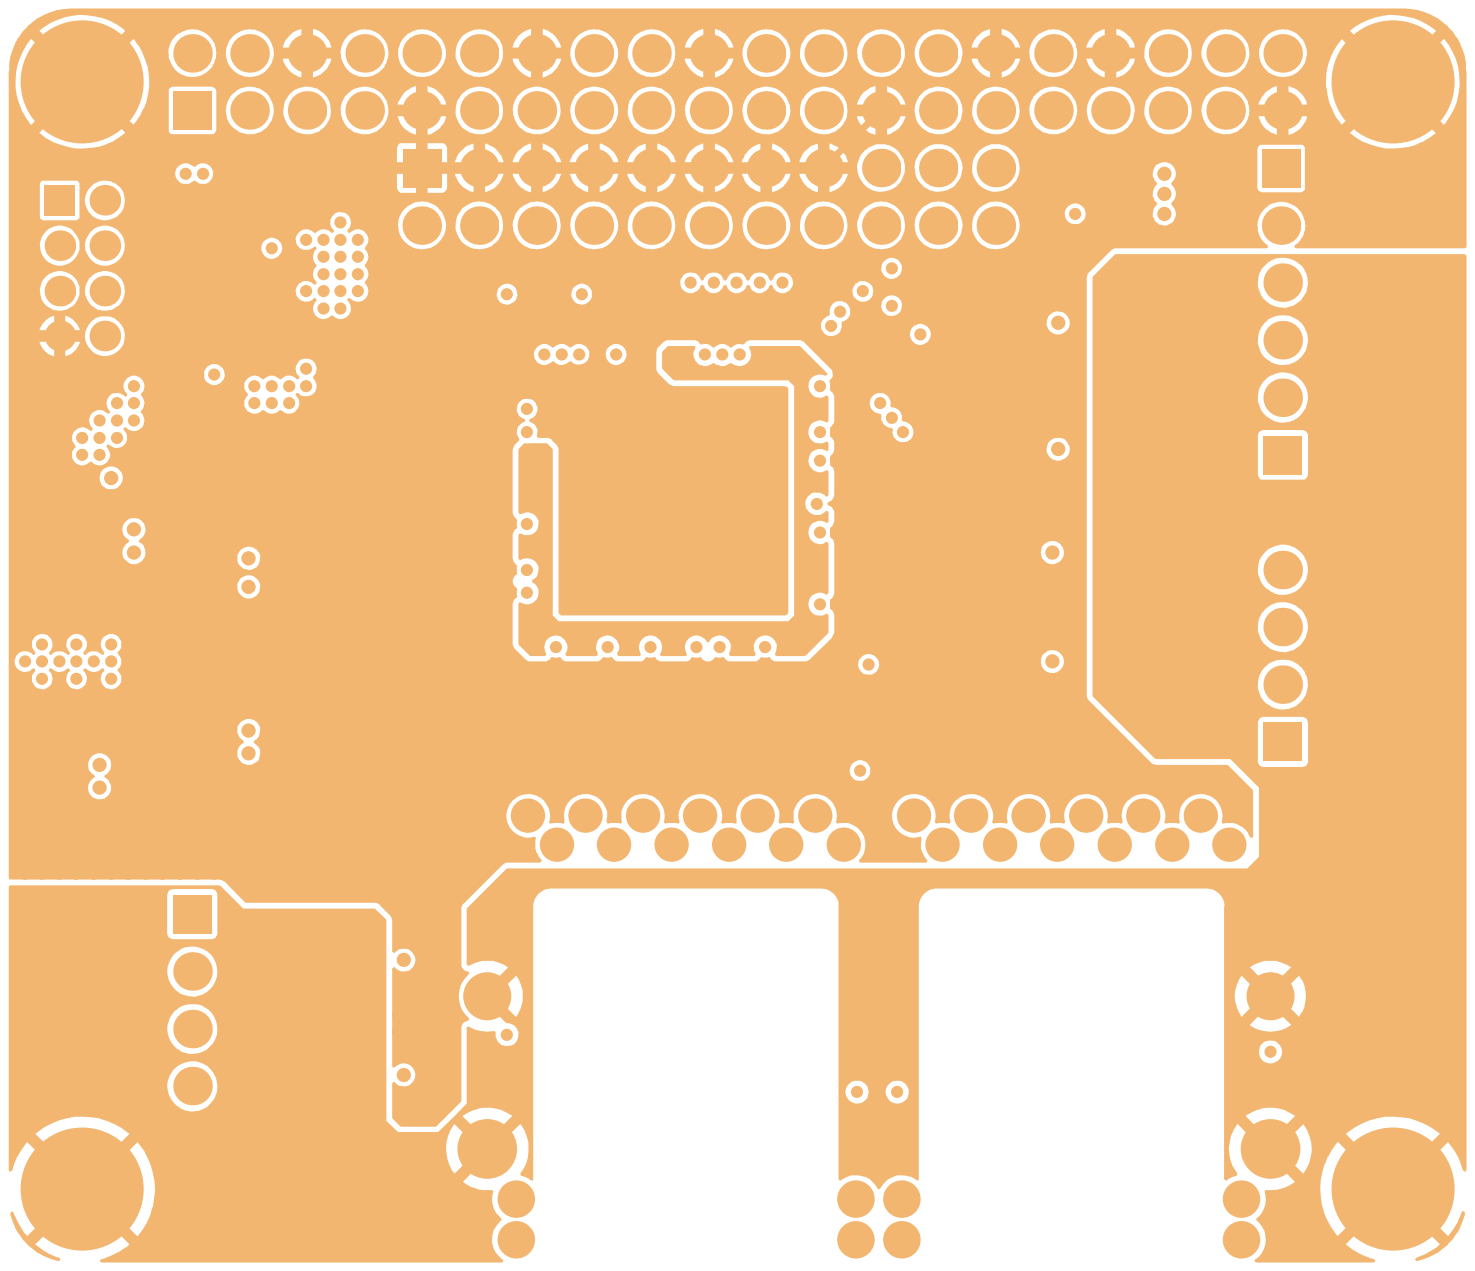
[picture p88: page 4]

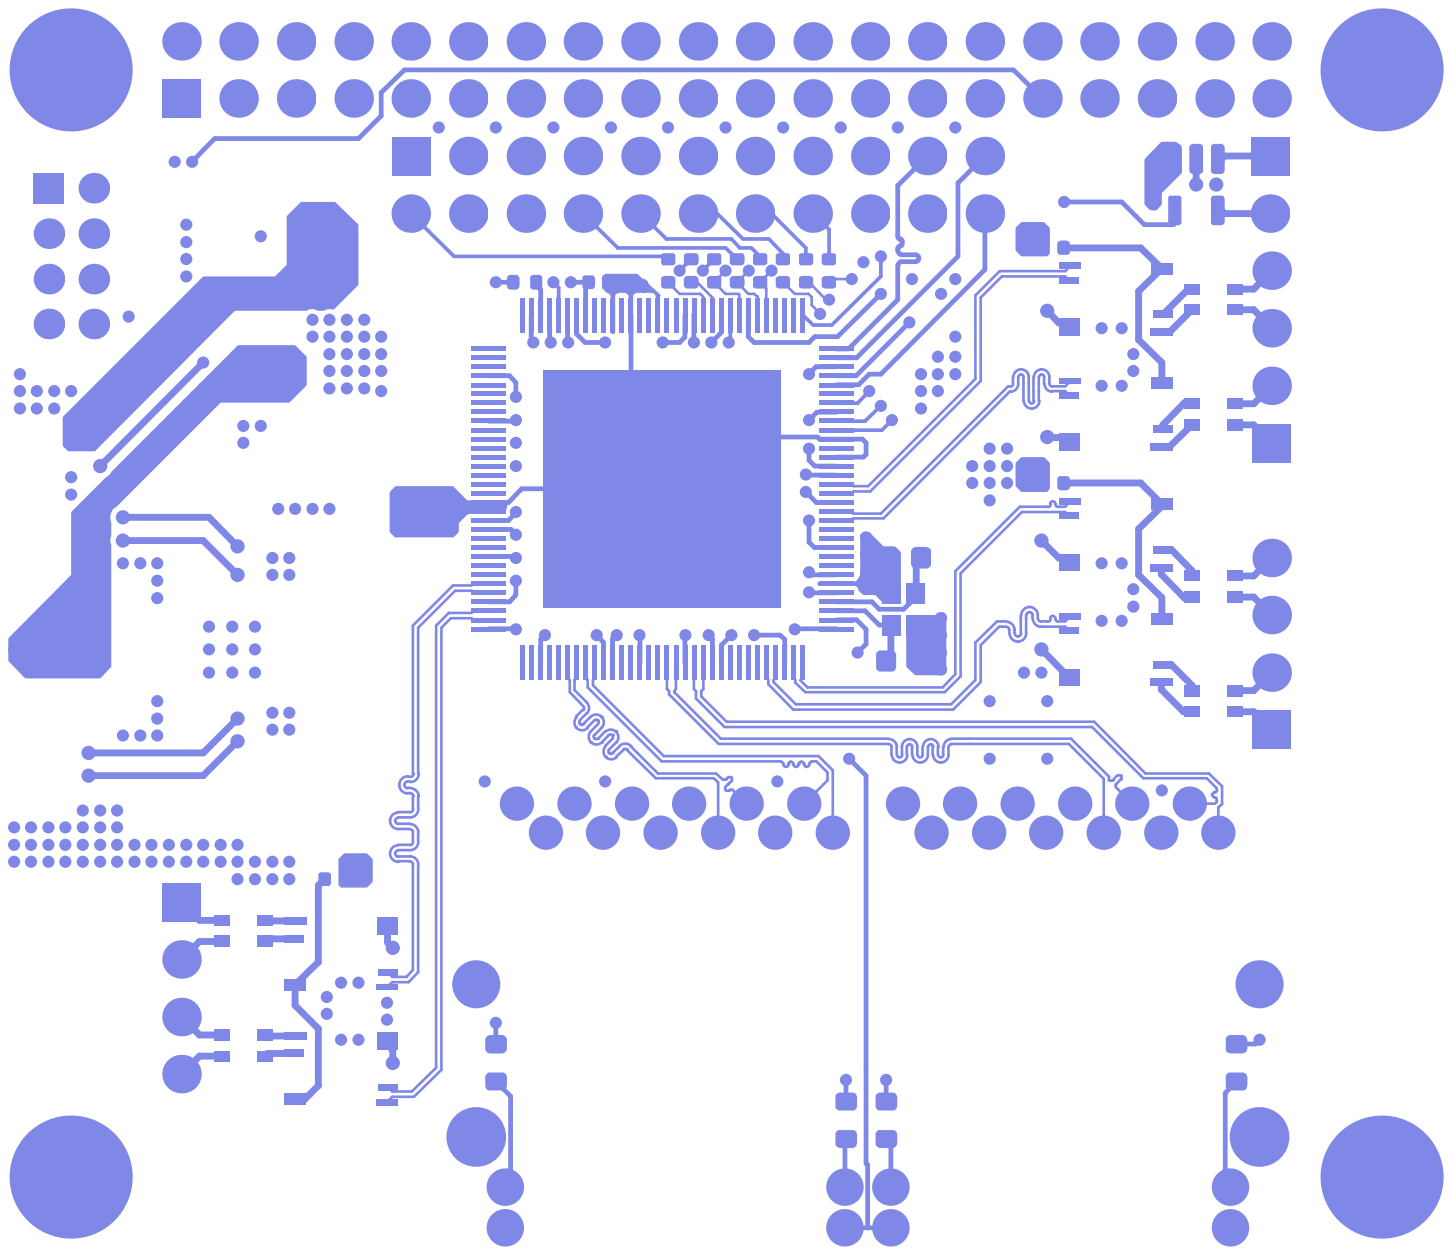
[picture p89: page 5]

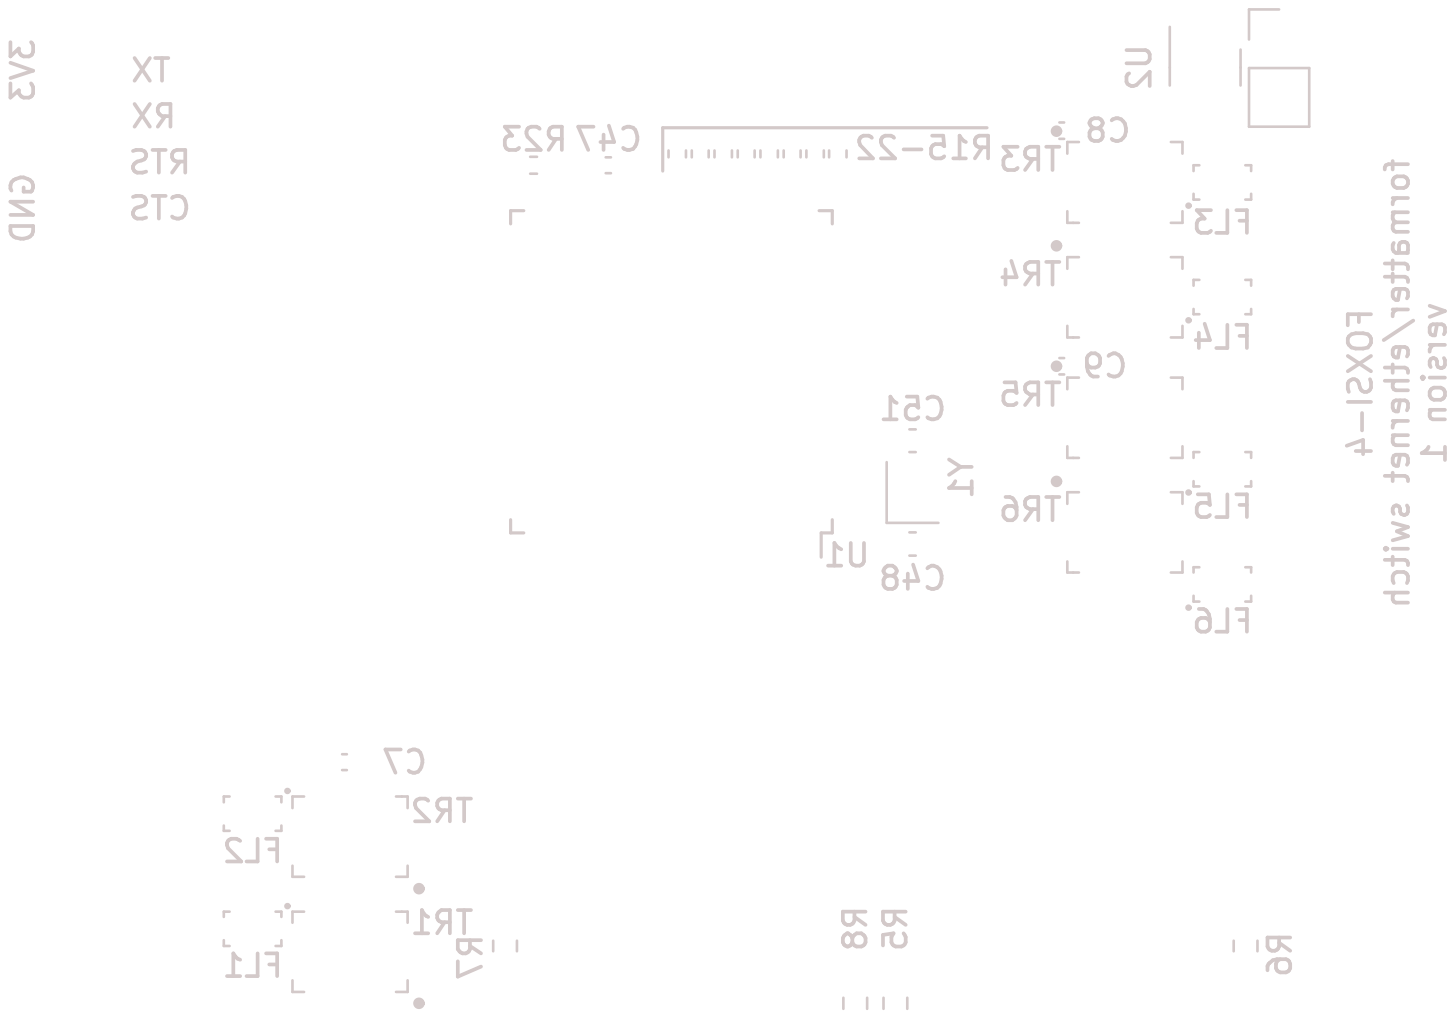
[picture p90: page 6]

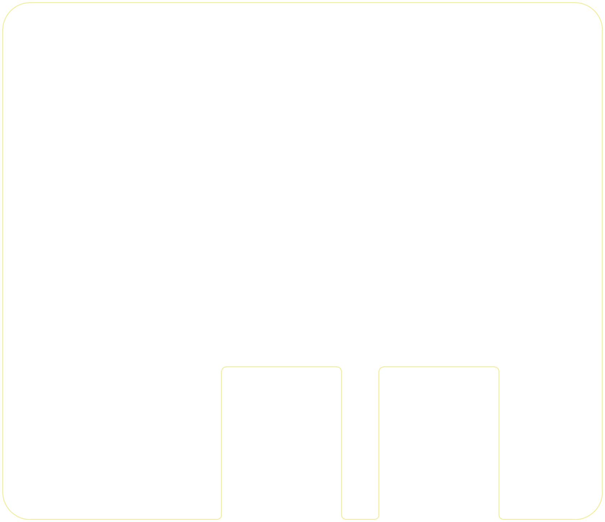
[picture p91: figure]
