foxsi/UMN-boards-FOXSI-4/little_switch/v1/build/drawing.pdf

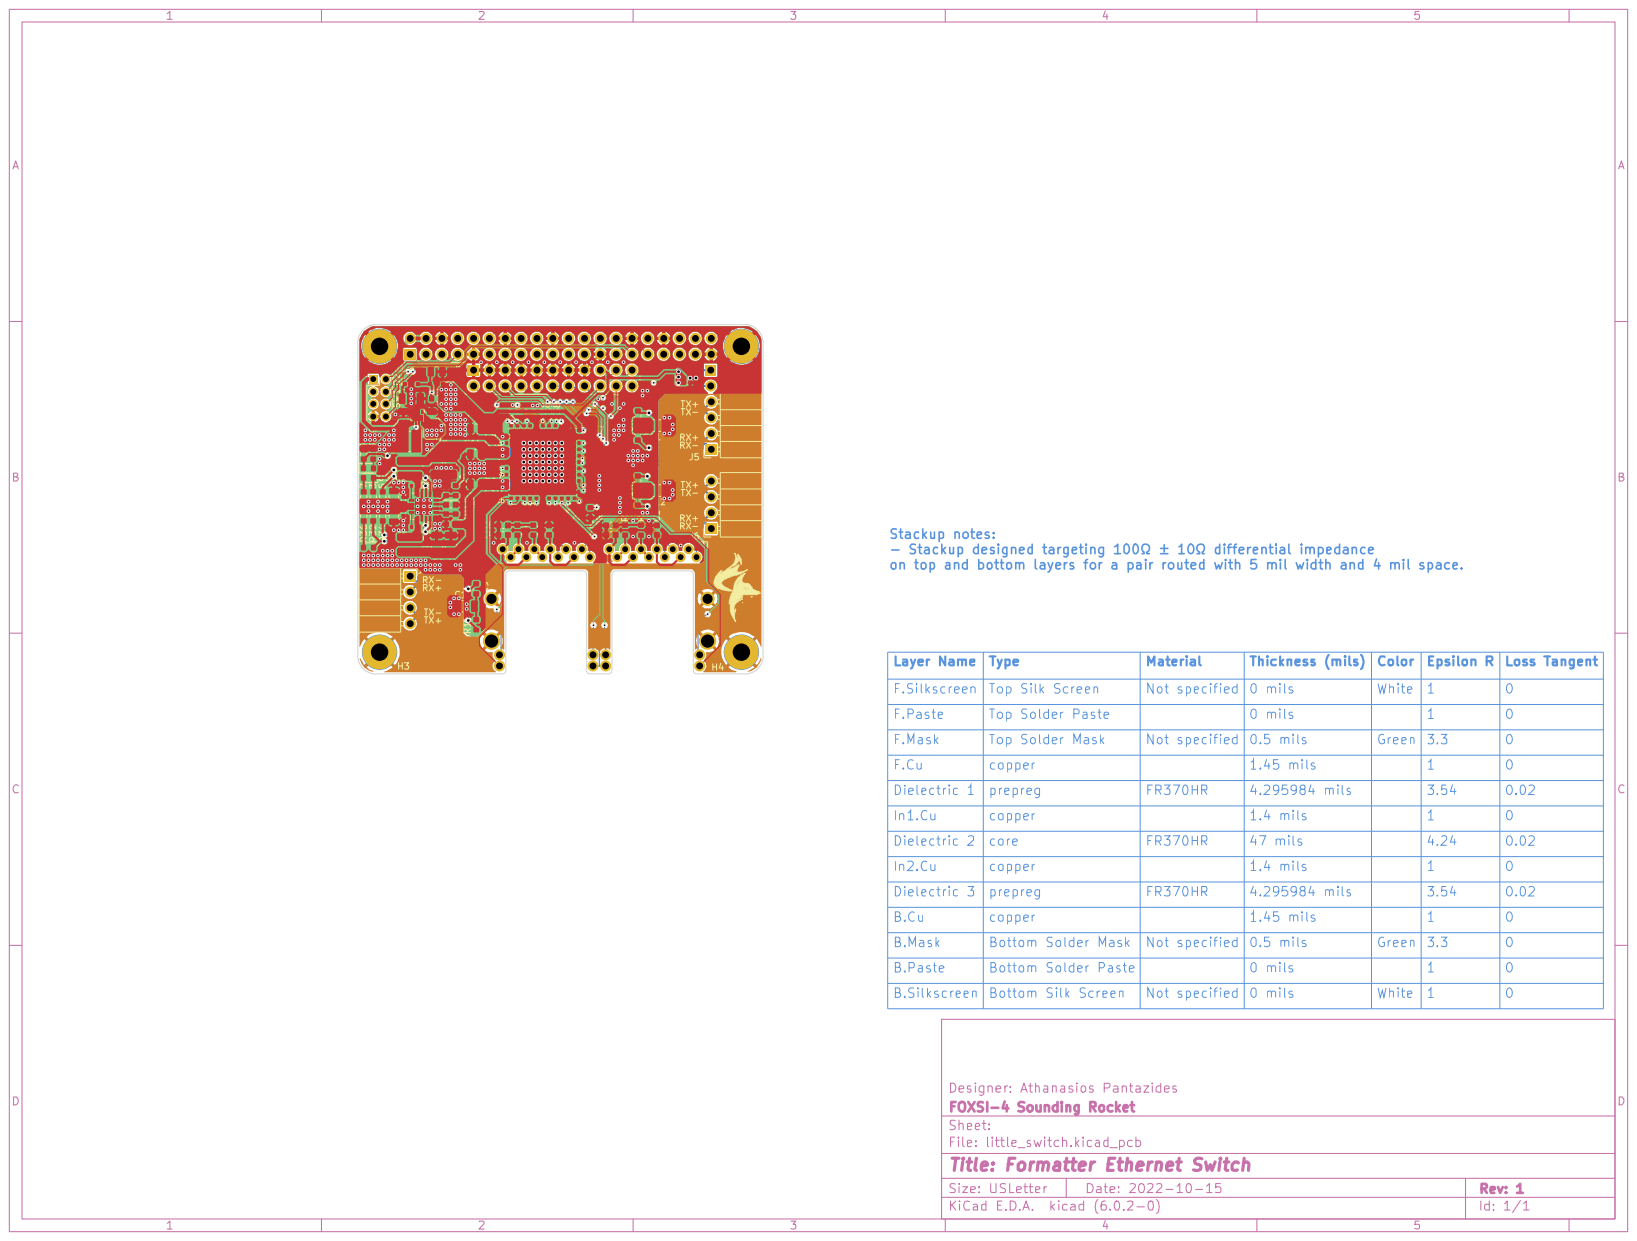
[picture p92: page 1]
