foxsi/UMN-boards-FOXSI-4/(commit log)

2022-10-31 adding notes and BMI270 IMU to plenum
    [board_outline.dxf, eth_phy.kicad_sch, imu.kicad_sch, plenum.kicad_pcb, plenum.kicad_sch, rtd.kicad_sch, rtd_header.kicad_sch]
2023-04-05 adding housekeeping board
    [bom.csv, config.kicad_sch, designators.csv, eth_phy.kicad_sch, format_switch_bom.csv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]
2023-05-15 updating plenum/doc
    [little_switch.kicad_pcb]
2023-10-03 v2 (flight version) of boards
    [board_outline.dxf, bom.csv, config.kicad_sch, converters.kicad_sch, designators.csv, eth_phy.kicad_sch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]
2024-07-22 correcting R10 value to 20k for 12V supply
    [converters.kicad_sch]
2024-10-10 bringing power meta up to date before new version
    [power.csv]
2024-12-03 adding v3 power board
    [bom.csv, converters.kicad_sch, designators.csv, hk_connector.kicad_sch, interface.kicad_sch, positions.csv, power.csv, power.kicad_pcb]
